arcticoder/spurious-force-balance/docs/kb/README.md

# KB index — `spurious-force-balance/docs/kb`

LLM-facing notes for future sessions. Read `session_handoff.md` first (state, what waits on the user, next tasks), then the topic you need. The sibling repo's notes (RP2040, lock-in, ordering, conventions)
are in github.com/arcticoder/lab `docs/kb/README.md`.

| Note | What it is for |
|---|---|
| `session_handoff.md` | state at the end of the last chat: done, in progress, waiting on the user, next three tasks, files to read |
| `balance_design_notes.md` | the torsion balance's numbers, design findings, and the checks that guard them; what is superseded |
| `instrument_electronics_notes.md` | the instrument board: decisions, simulation findings, open points before layout |
| `fab_ordering_notes.md` | JLC shipping, minimums, tactics (tagged by source), and this repo's fabrication decisions |
| `main_board_assessment.md` | why WP5 is slow (generic placement, all-at-once autorouting, two planes on 4 layers, KiCad features rebuilt in Python, rules added late) and the plan A-F; read before layout work |
| `main_board_layout_notes.md` | WP5 layout pipeline (`hardware/instrument/layout/mainboard.py`): placement, Freerouting, DRC, first-run result, KiCad 9 gotchas |
| `pcb_toolchain_notes.md` | KiCad 9, the venv, magpylib, kiutils pitfalls, the JLC parts snapshot, JLC capabilities |
| `project_workflow_notes.md` | the repos, the Opus-plans/Sonnet-actions routine, the user's standing preferences, tools |
| `easyeda_spark_notes.md` | SHELVED 2026-11-01 (EasyEDA/Spark route dropped, KiCad restored): the easyeda-mcp-pro Node fix, bridge status, Spark 2026 facts (unconfirmed), the .jxl picture convention, the main_board routing log, the EasyEDA install patches (`tools/patch_easyeda_autoroute_jobs.py`: job-style autorouting, DRC detail, copper rebuild) |
| `easyeda_validation.md` | SHELVED 2026-11-01: the offline validator `tools/validate_easyeda.py`, what it checks, how ERC/DRC and the `.epro2` export are obtained, the milestone routine |
| `part_a_planning_archive.md` | the instrument project's original planning text (constraints, gates, environment, architecture, toolchain) and the notes of finished Parts D, F, G, H |
| `printing_state.md` | K1 print hours rule, pre-sliced G-code, session routine, and the staged order notes |
