arcticoder/spurious-force-balance/docs/kb/project_workflow_notes.md

# KB: how this repo and its sibling are worked

Audience: future LLM sessions. Facts about the repos, the Opus/Sonnet routine and the user's standing preferences, as of 2026-10-24. The user's own words are never quoted in files; decisions are paraphrased.

## The repos

- `~/Code/python/pico`: the user's Pico/RP2040 sandbox (the Claude Code memory directory is keyed to it).
- `~/Code/python/lab` (github.com/arcticoder/lab, public): reusable bench circuits (SPICE netlists, breadboard guides, pass/fail smoke tests, MicroPython) plus the shared parts ledger (`docs/inventory.md`,
  `docs/orders.md`, `docs/parts_reference.md`) and its own knowledge base (`docs/kb/`). Every circuit there is ephemeral on a breadboard; parts return to inventory.
- `~/Code/python/spurious-force-balance` (github.com/arcticoder/spurious-force-balance, public, split from `lab` on 2026-10-23 with history): the torsion-balance experiment: plan, CAD, noise model, FR4 boards for JLC,
  the fab-assembled electronics design. Experiment-specific work lives in its own repo; a circuit built for an experiment stays in `lab` if it is reusable (`optical_shadow_readout`, `lockin_amplifier`) and the experiment links to it.
  Cross-repo references are GitHub URLs, not relative paths. `lab/lab.code-workspace` lists all three folders; the user keeps that one workspace.
- Licenses (both repos): MIT for code, CERN-OHL-P v2 for hardware designs and their documentation (`LICENSE`, `LICENSE-HARDWARE`).
- Git identity in both: `Arcticoder <10162808+arcticoder@users.noreply.github.com>`. Never commit: the user stages and commits both repos after each chat. Only flag, in `TODO-arcticoder.md`, milestones at which `hardware/easyeda/spurious-force-balance.eprj2` is worth committing (decided 2026-10-30). Commit messages end with the attribution line the session's system reminder gives.

## The Opus plans / Sonnet actions routine

The user alternates models with `/model`. In Opus mode nothing is actioned: Opus analyzes, then writes lettered **Parts** at the top of `docs/TODO-agent.md` (A, D, F, G so far) with concrete, checkable tasks. In Sonnet mode the user
says to process the tasks and Sonnet works them top to bottom, recording what was done in `docs/TODO-completed.md` and replacing a finished Part's task list with a short summary. `docs/TODO-arcticoder.md` is the user's own
list (hands, eyes, purchases only; one-line justifications; "En route" after the actionable sections), and anything the user must do goes at the top ("What I need from you").

## The user's standing preferences that shape this repo

- Paraphrase decisions; never quote the user or describe how they said it.
- **Design to stock sizes:** whole acrylic sheets, standard pads and rods; exact listing sizes in order lines; every cut needs a printed jig and a listed tool; the user has no saw, vise or scale in inventory.
- Carts must not incur single-item or under-threshold shipping fees; lines come from designs. AliExpress is the source for stock parts; no local-store suggestions; no mains parts on AliExpress.
- No hand soldering by the user; fab boards use only JLC's machine-placed SMT parts (nothing mailed in); one consolidated order where possible; USB power; under 50 V DC / 30 V AC.
- **Home printing is PLA only** (the fumes of ABS, PETG and nylon are ruled out). JLC PCB-as-structure, JLC3DP and JLCCNC are in scope when they beat buying and hand-cutting on cost, time or measurement risk.
- Instrument framing: never describe a circuit "without a multimeter"; name what it does. Real smoke tests (pass/fail safety and functional checks), not decorative simulations.
- Safety answers name the specific hazard or control gap; don't reassure or refuse.
- Jumper wires are never inventoried. Flux is not bought from AliExpress.

## Tools available to a session

`~/.venvs/lab-hw/bin/python` (CadQuery, magpylib, kiutils, SKiDL, numpy/scipy/matplotlib), KiCad 9.0.9 `kicad-cli`, ngspice, Freerouting (see `pcb_toolchain_notes.md`), `jlc` (live JLC stock/PCBA-type lookups; see `pcb_toolchain_notes.md`), `gh` (logged in as arcticoder), `git-filter-repo`,
`WebSearch`/`WebFetch` for vendor help pages, and read-only Pico probes through `mpremote` when the user leaves a rig plugged in (see `lab` `docs/kb/live_bench_measurement_notes.md`).
- **TODO-agent.md holds open items only** (the format of `aqei-bridge/docs/TODO.md`): a header pointing to `TODO-completed.md` (dated entries), `TODO-BLOCKED.md` (waiting on the user's build or A5) and `TODO-backlog.md`; finished work leaves the file the same session, and long notes go to `docs/kb/`. The old Part A planning text is in `kb/part_a_planning_archive.md`.
- **Mode:** on 2026-10-27 the user said there is no analysis-only mode for the agent: whichever model is running actions what needs actioning. The Opus/Sonnet split above describes how the user alternates, not a rule that blocks work.
- **JLC quote pages are unreadable from a session** and the `jlc` tool has no quotes: never present an estimated JLC price as fact, and do not send the user clicking through the quote UI for numbers that can be computed; ask for specific numbers only. The user's captures of the pages are in `lab/docs/jlc/`.
- `docs/history.md` is the user's chat transcript: never edit it unprompted and never use it as an analysis source.

## TODO-arcticoder.md hygiene (user's rule, 2026-11-01)
Only separately numbered tasks for the user's hands, eyes or decisions: no notes to self, no status reports, no placeholder "nothing needed" item. Explanations, EasyEDA recipes, the bridge-reconnect reminder (Advanced > MCP Bridge > Connect after sleep), the Spark registration timing (closes 2026-11-30; register only after the design exists) and the next `.eprj2` milestone belong in `kb/` (`session_handoff.md`, `easyeda_spark_notes.md`). A task I give in chat must also be in this file. Each action is its own numbered item.

## JLCONE desktop app access (2026-11-04)

The user launches the JLCONE app with `--remote-debugging-port=9222` when they want a quote or coupon read; the recipe, the gotchas and the permissions are in `lab/docs/kb/jlc_account_and_quotes.md`. Rules: read-only text reads, a few paced mouse clicks, uploads of this repo's own Gerber zips for quotes, never JLC's API, never the cookies, never "Submit"/"Save to cart"/payment (the user approves and pays), one order per task and at most one per day. Leave the page configured and tell the user what to approve.

## Standing rules added 2026-11-10

- **No tracking numbers** in chat or in any file (the user redacts them in `history.md` themselves; do not touch those). Say "tracking number in the JLC app".
- **Never state that I read a page unless the transcript shows the call; when asked, check the transcript and answer from it.** Order-page reads drive the JLCONE account tab through the debug port; the user does not need the tab left on the order list (they only need to know which page it was last on if they look at it), so just say what I read.

## Standing rules added 2026-11-11/12 (chat 13)
- **TODO-agent.md must be at 0 lines at the end of every chat** (`wc -l`): startable items are done in the same chat; items that truly wait (printer power, the user's decision or photo, the JLC app, a running computation) go to `TODO-BLOCKED.md` with the exact condition; user decisions also become numbered tasks in `TODO-arcticoder.md` (a decision that exists only in chat is a miss: the calibration-physics confirmation was one). Staged orders and standing duties live in `TODO-backlog.md`.
- **Never append to `docs/history.md`**; the user pastes the full chat summary there.
- **Long computations:** run them in the background (`run_in_background`) and write the plan to the TODO files before waiting; never poll or sleep. Keep a copy of the last good board/state before a new run. Do not mix the user's request for one thing with an extra experiment in the same background chain without a log file per run.
- **Photos:** the user drops a JPG in the repo root; convert to lossless `.jxl` in `docs/img/` with a descriptive name (via `tools/to_jxl.py` or Pillow with `pillow-jxl-plugin`, applying EXIF orientation), delete the original and its `:Zone.Identifier`, and parse what is in it against the CAD or inventory before relying on it.
- **Estimates vs facts:** label slicer-based print times, masses and price guesses as estimates in user-facing text; never state JLC prices; say when a check was not run.
- **Layout work:** read `kb/main_board_assessment.md` first (why it was slow: generic placement, all-at-once autorouting, planes, rebuilding KiCad in Python); change one thing per routing run and note the result in `kb/main_board_layout_notes.md`.
