arcticoder/spurious-force-balance/docs/kb/main_board_layout_notes.md

# KB: main-board layout pipeline (WP5), started 2026-11-08

Audience: future LLM sessions. The user's direction (2026-11-08): fab-assembled electronics, no hand-built stage; the layout does not wait on A5 (the breadboards `lockin_amplifier` and `optical_shadow_readout` in `lab` are no longer prerequisites; the board's digital lock-in and optical front end replace them).

**Milestone commits:** `4c877d7` holds the first placed-and-routed board, `88e0b3e` the geometry/DFM gate and the first DRC pass; both carry a generic refactoring message, so use these hashes to find them.

## Pipeline (all in `hardware/instrument/layout/mainboard.py`, run with `~/.venvs/lab-hw/bin/python`)

1. `mainboard.py place [W H]` builds `layout/out/main_board.kicad_pcb` (kiutils) from `schematic/out/main_board.net` (164 parts, 111 nets) and `lib/jlc.pretty`: four copper layers, nets on pads, connectors fixed at the edges (USB-C bottom, six 4-pin JST-SH top, four 2-pin JST-SH left, five 2.54 mm headers right), the rest placed by a damped force-directed pass (signal nets pull, power nets weakly, each capacitor toward the IC sharing its power net) then a repulsion-only legalisation with jitter. Deterministic. 110 x 90 mm gives 0 overlaps (parts are about 21% of the area).
2. `mainboard.py route` writes a Specctra DSN (own writer, no pcbnew), runs the bundled Freerouting 2.5.0 (`~/tools/freerouting/freerouting-2.5.0-linux-x64/bin/freerouting -de .dsn -do .ses -mp 8`) and imports the SES back as segments and vias (`import_ses`). A full run takes about 9 minutes (fanout 40 s, eight passes); the SES is written only at the end, so the `-do` file does not exist while it runs (the wrapper's 10-minute limit killed one run; run Freerouting directly in the background and wait for its exit).
3. DRC: `kicad-cli pcb drc --format json --severity-all --output out/drc.json out/main_board.kicad_pcb`.

## Result of the first run (110 x 90 mm, 0.2 mm tracks, 0.15 mm clearance, 0.6/0.3 vias)

415 nets to route, 9 left unrouted, DRC: 3 clearance, 6 tracks under 0.15 mm (0.10-0.12 mm pieces), 8 dangling vias, 2 annular-width, 2 padstack, 2 malformed courtyards (library footprints), 199 silk overlaps and 199 silk-over-copper (silk comes from the easyeda2kicad footprints; clean up before the fab outputs), 164 `lib_footprint_issues` (harmless, footprints are not from a library table). Not a fabricable board yet. Not yet done: ground planes on the inner layers (all four layers are used for routing), wider power tracks, USB differential pair, analog/digital partition checks, mounting holes, connector orientation (rotations were guessed: 0 on top, 90 left/right), silk and refdes, the 4-layer stackup/finish settings, and the visual review (WP6).

## Gotchas

- KiCad 9.0.9's Python `pcbnew` segfaults headless on `LoadBoard` and `BOARD.SetCopperLayerCount` raises a type error, so `ExportSpecctraDSN`/`ImportSpecctraSES` are unusable; kiutils plus the own DSN/SES code replaces them.
- `Footprint.description` from the easyeda2kicad libraries can contain newlines and colons; `kicad-cli` then fails with "Failed to load board". `mainboard.py` blanks it. When a board will not load, bisect by footprint (write one footprint at a time and run `kicad-cli pcb drc`).
- `kicad-cli pcb drc` takes its clearance from the `.kicad_pro` `net_settings.classes[Default]` next to the board, not from `board.design_settings.rules`; with the default 0.2 mm it reported 502 false clearance errors against a 0.15 mm route.
- kiutils writes pad angles as given: footprint rotation must be added to each pad's angle for connectors rotated by 90.
- DSN: unit um, y up (KiCad's y is down), one `component` block per image name, all parts on the front side.

## Design rules from the user (2026-11-09) and the checks that enforce them

- **Layer count by need:** 2 layers for a simple design; 4-6 with dedicated ground and power planes when noise reduction needs them. This board is 4 layers because of the RP2040 + 16-bit ADC + switching boost + USB mix; target stackup F.Cu signal / In1 GND plane / In2 power plane / B.Cu signal. The first Freerouting pass used all four layers for routing (no planes), which is why it is not the final state: pour GND on In1 and power on In2 (keep a plane unbroken under the ADC and its reference), then re-route the signals on F/B only. The mechanical boards and `elec_board` are 2-layer by design (no noise-critical analog on them).
- **No acute angles / 45-degree only:** `mainboard.py geometry [-v]` lists segments not on the 45-degree grid and same-net joints under 90 degrees. First pass (3340 segments): 0 off-grid (Freerouting's default snap angle is 45 degrees; the CLI has no option for it), 7 joints with a 45-degree interior angle (hairpins). Clean these by re-routing or by deleting the stub; also keep an eye on copper pours: thermal-relief spokes and neck-downs make acid traps too.
- **DFM gate:** `mainboard.py dfm` runs DRC and the shape check and exits 1 while a blocking item remains (clearance, track width, annular ring, dangling vias, unconnected nets, padstack, acute joints). Current blocking list: track_width 6, clearance 3, annular_width 2, padstack 2, via_dangling 8, unconnected 9, acute 7. Advisory (silk from the easyeda2kicad footprints, courtyards, library table): fix before the fab outputs but not a fab stop. Run it last, then confirm in JLC's own DFM/placement preview at order time (the preview is the user's step; read it through the app only if asked).

## Direction, rules and work order (moved from TODO-agent.md 2026-11-10)

No EasyEDA or Spark work is open: the native redesign, its MCP tooling, `tools/validate_easyeda.py` and the notes are shelved (`kb/easyeda_spark_notes.md` header). The KiCad/SKiDL netlists, the four mechanical boards, the sensor-head panel and its Gerbers are the order files. Open KiCad work: the WP5 main-board layout (details in `TODO-BLOCKED.md`, no longer gated on A5); WP4e sheet rendering is in `TODO-backlog.md`.
**Direction from the user (2026-11-08): no more hand-built electronics.** The electronics are fab-assembled boards from JLC: the main board and the sensor-head panel replace the breadboards (`lockin_amplifier`, `optical_shadow_readout`), so the A5 prototype check runs on the assembled boards and is not gated on the breadboards. The earlier plan to prove the design on breadboards before laying out the main board is dropped; the layout is not waiting on A5 any more.
**Board-design rules (user, 2026-11-09), apply to every board:** (a) layer count follows need: 2 layers for a simple design, 4-6 with dedicated ground and power planes where noise reduction needs them (the main board is 4 layers with inner planes still to draw; the arm, electrodes, clamps and `elec_board` are simple 2-layer designs); (b) no acute angles in copper (acid traps, signal integrity): 45-degree bends or arcs only; (c) a DFM check is the last step before any fab output. Implemented as `mainboard.py geometry` and `mainboard.py dfm` (exit 1 while anything blocking remains); the 2-layer boards get the same check at their next regeneration. Open: acute-joint cleanup (7 hairpin joints in the first pass), rounding the 45-degree corners is optional.
Main-board layout state: `kb/main_board_layout_notes.md` (first routed pass: 9 of 415 nets unrouted, 3 clearance errors; next: close the 9, add inner-layer ground planes, silk cleanup, connector rotations, mounting holes, DRC clean, WP6 review).
Open now, in order: (0) done 2026-11-08: `docs/plan.md` reconciled (remaining mentions of A5-before-layout, if any, are history); (1) WP5, the main-board layout in KiCad (RP2040 per its reference layout, ADC per its data sheet, analog/digital partition, decoupling, USB pair, DRC clean against JLC's rules; detail in `TODO-BLOCKED.md`, section "Main board"); (2) WP6 render review and the WP7 placement prechecks; (3) WP7 fab outputs (Gerbers, BOM, CPL, order-settings README) and the cost picture for the user's budget decision (JLC quotes are unreadable to me: ask for numbers only). The order itself (cost, coupons, parcel mass) is the user's decision once the files are checked. Waiting on the board only: the rest of WP8 and the bring-up.

## In1 ground plane and the 120 x 90 mm run (2026-11-10)
- `mainboard.py` now pours a GND zone on In1.Cu (`add_planes`, called from `import_ses`; kicad-cli DRC refills it) and the DSN keeps every net except GND off In1.Cu with `(use_layer F.Cu In2.Cu B.Cu)` in the signal class; GND may use all layers. Freerouting honours it: after the run In1.Cu holds 29 GND segments and nothing else.
- A DSN `(plane GND ...)` with In1 as a power layer did NOT work: Freerouting wrote no GND vias for the SMD pads, 148 GND pads stayed unconnected. Do not retry it.
- Board 100 x 80 mm with a plane left 156 connections unrouted; 120 x 90 mm leaves 3 unconnected, 3 clearance, 8 track-width, 17 acute joints (Y-branches), 2 dangling vias, 2 dangling tracks, 1 shorting item. The first routed pass (100 x 80, no plane, signals on In1) is in the scratchpad backup only; commit `4c877d7`/`88e0b3e` hold it in git. **120 x 90 is a price-tier question for the user** (the cheap 4-layer tier needs under 50 x 50 mm; this board is above it either way).
- A full route takes 15-25 minutes on this machine now: use `mainboard.py route 30` (minutes argument); an 8-minute limit writes no SES.
- Still no In2 power plane: In2 carries signals. Next step is the same trick for the 3V3 rails (zone on In2 plus `use_layer` excluding In2 for non-power nets) if the routing leaves room.

## 2026-11-11 evening: new tools, decisions and the In2 attempt
- New `mainboard.py` commands: `sync` (library description, models, courtyards, unplated pegs), `holes` (four M3 holes at the corners, moved inward until clear of copper), `silk` (reference and value texts to the Fab layer, no outlines on C/R/L/F 0603-1206 passives, title text; silk warnings fell from about 600 to 10), `rules` (writes `out/main_board.kicad_dru`: pad-hole gap 0.45 mm), `fixacute` (rewrites 45-degree Y-branch joints whose shorter leg is 0.72 mm or more: 4 of 17 on the 2026-11-10 route), plus `import_ses` now runs sync, holes, silk and both planes. `dfm` gained netlist parity (replaces the missing .kicad_sch: refs, footprints and every pad-net against the netlist; MH holes exempt), a mounting-hole count (at least two 2.5 mm+ NPTH) and a board-size advisory.
- In2 plane: `PLANE2_NET = "3V3_D"`; the DSN class `signals` is limited to F.Cu/B.Cu, `plane2` (3V3_D) may use In2, GND any layer. A 35-minute route with this wrote no SES; a 58-minute one was started 2026-11-11 about 21:00 (`out/route_in2_b.log`). Fallback is the routed state of 2026-11-10 (In1 GND only); `inner_plane_missing` in `dfm` then needs relaxing to In1 with the reason written down.
- Track widths under 0.15 mm in the DRC (0.10 and 0.12 mm, 0.01-0.39 mm long) are Freerouting neck-downs at fine-pitch pads; JLC allows 0.09 mm, so the DRC floor is 0.10 mm and they pass.
- 120 lib_footprint_mismatch warnings now (advisory) are intended: the silk policy deliberately differs from the library.
- Still a real defect: the USB-C VBUS via touches the GND pad A1B12 (short, hole clearance, solder-mask bridge). Courtyards of L4 overlap C49, R18, C3.
- `check_panel.py` reads the panel outline with kiutils because `pcbnew.LoadBoard` segfaults; `analog_sims.dut` ignores the last ngspice sample (a glitch at t = tstop).
- Result of the 58-minute In2 route (2026-11-11, ended 21:44): Freerouting finished in about 45 minutes and wrote `out/main_board.ses` (1427 wires, 372 vias; In2 carries only 3V3_D, as intended), but the import crashed: `sync_library_fields` tries to load a library file for the generated `MountingHole_M3` footprint, which has none (skip footprints not in `jlc.pretty`). So the board file is still the 2026-11-10 fallback and the unrouted count of this run is unknown. Not patched further (method change, `kb/main_board_assessment.md`); the SES stays in `out/` only as a data point (In2 as a solid plane is routable at 120 x 90 in about 45 minutes).

## 2026-11-12: block-placement runs, what worked, final state (read this first)
- Sequence of runs on the block floorplan (`BLOCK_REGIONS`, 120 x 90): (1) signals on In2 + 3V3_D pour: 0 shorts, 47 unconnected; (2) USB-C custom pads fixed in the DSN (their `size` is a 0.005 mm anchor, the copper is the polygon; the router had routed through the real pads, giving 5 shorts and 8 clearance errors); (3) pour dropped, signals F/B only: 25 unconnected; (4) cause of 40 unconnected 3V3_D pads found in the SES (16 wires for 47 pins): the rails class at 0.25 mm cannot enter the RP2040's 0.4 mm-pitch pads, class width back to 0.2 mm: 6 unconnected, all on U3's pads; (5) courtyard-based part sizes and a 0.25 mm keep-out around NPTH holes in the DSN removed the courtyard and hole-clearance errors; (6) `FANOUT_EXTRA` keep-out around U3 (3 mm), U9 (2.4), U8 (1.6) gave a fully routed board on the first run with it (route 40 min limit, finished earlier).
- Final: 415/415 routed, DRC: no shorts, clearance, dangling vias, courtyards, hole clearance; `dfm`: blocking none. Advisory: 4 silk over copper, 120 lib_footprint_mismatch (silk policy, intended), no fiducials, board size vs price tier.
- The In2 pour in all three forms failed (fragments, no layer left, or 45 minutes) and is dropped; In1 GND is the only plane. `stitch_pour` (vias to a pour) exists but is not called.
- `route2` (continue from existing tracks) did not change a stuck board; placement keep-outs did. Freerouting's log is not captured; count unrouted from DRC.
- Added: `fab` command (zone fill with system pcbnew, Gerbers, drill, BOM from netlist LCSC fields, CPL); kicad-cli plots stored fills only, so fill first or the plane is missing from the Gerbers (it was: In1 12 kB before, 256 kB after).
- Not done and not needed for the gate: connector rotation check (user, JLC preview), board-size decision.
