arcticoder/spurious-force-balance/docs/kb/easyeda_spark_notes.md

> SHELVED 2026-11-01: the EasyEDA/Spark route was dropped and KiCad is the design source again. Read this only if EasyEDA work is ever resumed (state of the main board: 117.3 x 96.8 mm, 0 clearance errors, 62 open connections around U4, project saved in `hardware/easyeda/`).

# EasyEDA MCP bridge and the Spark competition (2026-10-29)

## easyeda-mcp-pro
- Package `easyeda-mcp-pro` 1.6.0 (PolyForm Noncommercial) needs Node 24.x (pinned 24.22.1) and checks at startup. `bunx` runs it with whatever `node` is first on PATH (shebang), so bun is fine but PATH decides: the failure was nvm's default Node 22.15.0.
- Fix applied: `nvm install 24.22.1`; the VS Code Insiders `mcp.json` entry sets `env.PATH` with `~/.nvm/versions/node/v24.22.1/bin` first and keeps `TOOL_PROFILE=pro`. `extension --open` then prints the `.eext` path (inside the bun/npm cache; also `extension --copy <dir>`).
- The user reported the bridge connected (2026-10-29); this session still had no easyeda tools (the server loads at session start). Originally unverified: the bridge connection. It needs the user to import the `.eext` in EasyEDA Pro, fully restart it, and click MCP Bridge > Connect; EasyEDA Pro (`easyeda-pro` in /usr/local/bin, a Windows install under WSL) must reach the server's WebSocket across the WSL boundary. The MCP tools only appear in a session started after VS Code reloads the server.
- Cheaper fallback if the bridge fights back: EasyEDA Pro imports KiCad files itself (File > Import).

## Spark 2026 (source: FabFlow blog, a third party with a referral link; the official OSHWLab pages are JS-rendered and returned only navigation text)
- Registration 2026-01-01 to 2026-11-30; judging December; $85,000 pool; categories include Best Documentation and Community Choice.
- Needs: design in EasyEDA (Pro), public on OSHWLab with schematics, layout, BOM, firmware, build instructions.
- Material sponsorship about 80% of manufacturing and shipping (PCB, PCBA, 3DP, CNC), duties and taxes the participant's; acceptance criteria not stated. $100 JLCPCB coupon per registrant; $50 each for referrer and referee when the referee submits.
- Every figure above is unconfirmed until read on the official page while logged in.

## Pictures
- Repo pictures are lossless JPEG XL (`.jxl`) since 2026-10-29; generators write a temporary PNG and call `tools/to_jxl.py` (needs `pillow-jxl-plugin` in `~/.venvs/lab-hw`). `cjxl` is not installed. GitHub does not render `.jxl` inline, so a README that must show a picture needs a PNG/WebP copy. `lab` has no committed PNGs (its `schematic.png` files are generated and gitignored).

## LFS
- `*.jxl` is LFS-tracked in both repos (`.gitattributes`); `lab` also keeps `*.jpg`. Neither repo tracked PNG. Existing .jxl were re-added with `git add --renormalize`.

## MCP client wiring
- The VS Code `mcp.json` configures VS Code's MCP client, not Claude Code. Claude Code reads `~/.claude.json` `mcpServers` (the `claude` CLI is not on PATH in the WSL shell, so the entry was written directly; backup in the scratchpad). A stdio `initialize` against `bunx easyeda-mcp-pro` under Node 24 answers correctly (v1.6.0). EasyEDA Pro itself runs natively in WSL (`/opt/apps/easyeda-pro`), so the bridge is localhost. Two clients running the server at once may fight over the bridge port.
- Spark rule from the user (2026-10-29): the design must be made in EasyEDA, not imported from KiCad/SKiDL; apply only after the redesign exists.

## Bridge state (2026-10-29, later)
- Connected through the VS Code `mcp.json` (key `servers`, not `mcpServers`); in a Claude Code session the tools appear as `mcp__easyeda-mcp-pro__*` after the server is up. `easyeda_health_check` reports bridge_connected with EasyEDA Pro 1.6.0 extension.
- With nothing open, `schematic_components` fails and `canvas_capture` returns no image; every tool wants a `projectId` and there is no tool to create or list projects (only API inventory names `dmt_Project`), so the user must open a project first.
- Tool limits that shape the redesign: schematic writes (place_component, connect_pin_to_net, batch_write, net flags) exist; the PCB side is read-only plus DRC and autoroute; footprints reach the PCB only through `schematic_sync_to_pcb`, whose confirmation dialog the user must click. Custom board outlines, the 208 mm arm shape, placement and copper for the mechanical boards probably need EasyEDA's own UI or the extension API; check `api_inventory` filtered on PCB_ before promising it.

## Project file and profiles
- `hardware/easyeda/spurious-force-balance.eprj2` is a SQLite database (tables: boards, components, ...; 389 KB empty), rewritten on every save, so diffs are opaque: tracked through Git LFS (`*.eprj2` in `.gitattributes`), committed at milestones only, not every save. The OSHWLab copy is uploaded from EasyEDA itself, not from git.
- `canvas_capture` works with the project open (empty PCB, mil grid). The PCB API (`api_inventory` filter `PCB_`) has create/modify for components, pads, lines, polylines, pours, vias, regions; the `pro` profile exposes none of them. `full` adds "controlled documented API method calls" and CircuitIR floorplanning, so the profile was switched to `full` in the VS Code mcp.json (needs a restart). `dev` adds probes; avoid unless debugging.

- The server a Claude Code session talks to is spawned from `~/.claude.json` (not the VS Code `mcp.json`); changing the profile in the wrong file leaves `easyeda_health_check` reporting the old one. Check `profile` there before relying on `full` tools. Only one server process should run, or the bridge may bind to the wrong one.

## Native EasyEDA build: recipe that works (2026-10-30, `full` profile)
- Project UUID `4d31f2a7bcc8695ef8b75bd3a29ba297479082a28cd7122588689b19e4bb50ca`; Board1 holds Schematic1 and PCB1 (one PCB per Board: the other mechanical boards need their own Board/PCB, create through `DMT_Board`/`DMT_Pcb` calls or the UI). `easyeda_api_call` needs `confirmWrite:true` even for getters. Do not call `PCB_Layer.getAllLayers` again: its output is huge.
- Units are mil; y is up (KiCad y is down: use y_e = -y_k, x_e = x_k, 1 mm = 39.37008 mil).
- Board outline: `PCB_PrimitivePolyline.create("", 11, {"$polygon":[x0,y0,"L",x1,y1,...]}, 10, false)`, closed by repeating the first point.
- NPTH hole: `PCB_PrimitivePad.create(12, "", x, y, 0, ["ELLIPSE",d,d], "", ["ROUND",d,d], 0,0,0, false)` (metallization false).
- SMD pad: shape name is `RECT` (`["RECT",w,h,cornerRadius]`), not RECTANGLE; hole omitted; layer 1 top, 2 bottom; pass the net name as the 7th argument.
- Track: `easyeda_pcb_add_track` (layer 2 = bottom, width in mil).
- `easyeda_pcb_place_component` is disabled by the server; footprints come from the schematic through `schematic_sync_to_pcb` (the user clicks the dialog).
- `easyeda_drc_run` takes the project UUID and returned 0 violations for the arm.
- Arm status: outline, 7 NPTH holes, B.Cu pads 1 (5.6 x 12 mm) and 2 (20 x 8 mm), pad 3 (flag, top and bottom copper), the 0.6 mm trace; the net is called `ELEC_LEAD` (it was unnamed in KiCad). Silkscreen text not yet added.

## Mechanical boards done (2026-10-30)
- Boards in the project: Board1/PCB `arm`, Board2/PCB `clamp_plate` (uuid 3ddf518a3b25253b), Board3/PCB `clamp_ground` (a1c4bc42816028ee), Board4/PCB `elec_board` (05dc52ccb60a9ca9); arm is 7bc3367e1c2d2364. `DMT_Board.createBoard` (no args) makes a Board plus empty schematic and PCB; rename with `DMT_Pcb.modifyPcbName(uuid, name)`; switch the focused document with `DMT_EditorControl.openDocument(pcbUuid)` before PCB calls (DRC and the PCB API act on the focused document). Board names are still Board1..4.
- All four reproduce the KiCad geometry (outline, NPTH holes, copper pads, tracks, one via on elec_board) with 0 DRC violations each (arm and elec_board and clamp_ground checked after drawing; clamp_plate has no copper). `PCB_PrimitiveVia.create(net, x, y, holeDia, dia)`; plated through pad: layer 12, pad number, net, hole, metallization true.
- Not yet: silkscreen labels, the sensor-head panel, the instrument schematic and board (sync needs the user's click on the dialog), the Spark texts.

## Sensor heads, schematic side (2026-10-30)
- Board5 = PCB `sensor_head_1` (6b230bf28446d8f9, schematic page bbf87dc32958233f), Board6 = PCB `sensor_head_2` (868eebde0c888e1b, page 6041b681d252cfcb). Library parts found by LCSC number through `schematic_search_device` (library 0819f05c4eef4c71ace90d822a990e87): TMP117 C699536 uuid 4af454a0..., MMC5983MA C404329 dd001152..., SM04B-SRSS-TB C160404 eedd7219..., 100 nF C14663 a299e4f2..., 1 uF C15849 af2e25dc..., 10 uF C15850 e10bc30d....
- Wired with `connect_pins_by_net` (net-label stubs) to the same nets as `schematic/heads.py` (3V3_D, GND, I2C_SDA, I2C_SCL, MAG_CAP), unused pins marked no-connect with `setPinNoConnect`; head 1 validates fully (0 floating, ERC 0). Head 2's nets are right and ERC passes, but `validate_netlist` reports valid:false with "7 component(s) have no net connections" (unexplained; recheck after the PCB sync). Pin numbers equal the KiCad/SKiDL numbers for these parts.
- Head 2's 100 nF capacitor landed in the title-block area (placed at y=100): move it before publishing the schematic.
- `schematic_sync_to_pcb` only opens EasyEDA's confirmation dialog; the user must click it (steps in `TODO-arcticoder.md`).

- EasyEDA Pro 3.2.x menu: the sync is Design > Import Changes from Schematic (Alt+I) inside the PCB editor (no "Convert/Update PCB" item). `PCB_Document.importChanges()` via `api_call` with the PCB focused returns true but only raises that dialog; `pcb_components` stayed empty until the user confirms. Canvas captures do not show dialogs.

## Sensor head 1 layout recipe (2026-10-30, later session)
- Pad coordinates and nets: `PCB_PrimitiveComponent.getAllPinsByPrimitiveId(componentPrimitiveId)` through `easyeda_api_call` (confirmWrite true); the output is very large (about 3 KB per pad), so query one part at a time and read only X, Y, Net. Pad coordinates are absolute (mil, y up).
- The sync leaves parts in one row with no overlap, so placement can be kept; head 1's row spans x 0..860, y -456..-197 mil. Outline for a 26 x 17 mm board around it: `PCB_PrimitivePolyline.create("", 11, {"$polygon":[-80,8.3,"L",943.6,8.3,943.6,-661,-80,-661,-80,8.3]}, 10, false)`.
- `easyeda_pcb_autoroute` works with the PCB focused: `ignoreNets:["GND"]`, `cornerStyle:"45"`, `optimization:"completion"`, `existingPrimitiveMode:"keep"`, `boardData:{hasOutline:true,widthMm:26,heightMm:17,layerCount:2}`; it routed 4/4 nets in 1 s (detours, 8.9 to 10 mil tracks, two vias, one bottom-layer segment). Its DRC counts are coarse; `PCB_Drc.check(true,false,true)` via `api_call` gives per-net groups (the entries print as `[MaxDepth]`, so only the count and net name are readable).
- GND pour: `PCB_PrimitivePour.create("GND", layer, {"$polygon":[...]}, "solid", false, "GND_top", 1, 10, false)`; the copper is only filled after `easyeda_pcb_rebuild_copper`. A call with `net:"GND"` rebuilt the first pour (layer 1; DRC errors 12 to 6) but the bottom pour failed read-back, and the tool then refuses every later rebuild ("previous rebuild ended without complete verification"), apparently until the MCP server is restarted. Do not rebuild both pours in one call: pass one `pourIds` entry per call, and check `PCB_PrimitivePoured.getAll` for a fill.
- Head 1 state: outline, autorouted signals, top GND pour filled; bottom pour created but unfilled; 6 GND connection errors remain (pads enclosed by traces). Fix: restart the server, rebuild the bottom pour, add GND stitching vias beside the enclosed pads (CN1 pad 2, U1 pads 2/4/7, C1 pad 2, ...), rerun DRC. Head 2 not started.

- Bridge after suspend (user report 2026-10-30): the bridge drops when the computer sleeps; recovery is `pkill -f claude`, restart the session, then EasyEDA Pro's Advanced > MCP Bridge > Connect. `easyeda_health_check` returning `bridge_connected:false` / `degraded` means the user must click Connect again; the rebuild-copper guard does NOT reset with a new server process: it is persisted in `~/.easyeda-mcp-pro/easyeda-mcp-pro.sqlite` (a failed rebuild read-back blocks `easyeda_pcb_rebuild_copper` until reconciled; do not edit that file to bypass it, ask the user to rebuild copper from EasyEDA's menu instead). Deleting and recreating a pour does not fill it.
- Head 1 after the 2026-10-30 reconnect: bottom pour recreated (id ff793f60...), five 24/12 mil GND vias placed in big GND pads, DRC still 6 GND connection errors (bottom pour unfilled).

- Head 1 finished (2026-10-30, evening): the user rebuilt the bottom pour from EasyEDA's menu (the pour was renamed GND_BOT2 and held one fill); the tool's guard stayed locked anyway. The 6 remaining errors were GND pads enclosed by autorouted 3V3/SDA traces; a second `easyeda_pcb_autoroute` with `routingNets:["GND"]`, `existingPrimitiveMode:"keep"` connected them with GND tracks/vias and DRC read 0 (`PCB_Drc.check` returns `[]` when clean). Order that works: signals (ignore GND), pours (user rebuilds copper), then GND autoroute.
- EasyEDA writes `.epro2` auto-backups to `hardware/easyeda/spurious-force-balance_backup/` on save (timestamped, about 360 KB each); the folder is gitignored (`hardware/easyeda/*_backup/`).

- Head 2 (2026-10-31): same recipe; outline, signals autorouted (3/3 nets), GND_TOP/GND_BOT pours created, waiting for the user's Copper Manager rebuild, then the GND autoroute and DRC. Copper Manager lists nothing until pours exist (a user's empty list on a board without pours is expected). C5 in the schematic title block still to move.

- Head 2 finished (2026-10-31): after the user rebuilt both pours in Copper Manager, a GND-only autoroute gave DRC 0. Its schematic is fine: `schematic_components` and `validate_netlist` are project-wide counts, so head 2's "7 components have no net connections" warning is head 1's parts; C5 at (400,100) is nowhere near the bottom-right title block (A4 1170 x 825, position 3). Nothing to fix.
- Panels: `DMT_Panel` only has createPanel/copy/delete/getAllPanelsInfo/getPanelInfo/modifyPanelName; `panel1` exists (uuid 7ff8c5b618e84216), with no content API, so the panel would be built by the user in the UI. 2026-10-31: `panel1` opens as an empty frame with corner marks; the user could not paste a PCB into it and no verified procedure exists, so the panel is parked (do not give the user panel steps from memory; ask what the panel tab's menus offer if it is revisited). The JLC order uses the KiCad panel Gerbers.

- Silkscreen (2026-10-31): `easyeda_pcb_add_text` fails ("cannot create text primitive"); use `PCB_PrimitiveString.create(layer, x, y, text, "NotoSansMonoCJKsc-Regular", fontSizeMil, lineWidthMil, 1, 0, false, 0, mirror, false)` through `api_call` (layer 3 top silk, 4 bottom silk with mirror true). The anchor is the text's top-left; width is about 0.68 x font size per character (so centre a label at x - n*0.34*size, y + size/2). Done from the KiCad texts: arm (2 labels), clamp_plate (CLAMP), clamp_ground (GND, bottom), elec_board (SIG, GUARD, ELECTRODE note, bottom). Board uuids and KiCad (x, -y) mapping unchanged; the arm outline spans x +-100 mm, y +20..+80 mm in EasyEDA coordinates.

- Bottom-silk labels under top copper do not show in the combined view (top copper and top solder-mask/paste draw over them): elec_board's ELECTRODE note looked missing to the user but exists (verified with `PCB_PrimitiveString.getAll` and by hiding layers 1, 5 and 7 with `PCB_Layer.setLayerInvisible`, then restoring with `setLayerVisible`). Check text with `getAll` rather than a screenshot, or hide those layers first. Layer ids: 1 top, 2 bottom, 3 top silk, 4 bottom silk, 5 top mask, 6 bottom mask, 7 top paste, 8 bottom paste.

## State at 2026-10-30 handoff
- Both sensor-head PCBs now hold their imported footprints (sensor_head_1: C1-C4, CN1, U1, U2; sensor_head_2: C5, CN2, U3), unplaced and without an outline; footprints: C0603, C0805 (10 uF), WSON-6 2x2 mm (TMP117), LGA-16 3x3 mm 0.5 mm pitch (MMC5983MA), SM04B-SRSS-TB. Designators run project-wide (C5, CN2, U3 on head 2).
- The user imports with Design > Import Changes from Schematic (Alt+I) in the PCB tab and presses Apply; no tool does it for them.
- Next: outline, placement, routing, pour, DRC for the heads; the panel in Panel1; silkscreen; the main board.

## Main board in EasyEDA: plan and device table (2026-10-31)
- Source of truth for the parts and nets: `hardware/instrument/schematic/main_board.py` (164 BOM parts, 46 LCSC numbers, 542 pins, 111 multi-pin nets, 16 unconnected pins). Export that circuit to JSON with a small script (`builtins.default_circuit.parts`, pin.num, net name when the net has more than one part pin; skip LCSC "C0" power flags) rather than retyping it.
- `hardware/easyeda/main_board_devices.json`: LCSC number -> library device uuid (library 0819f05c...), found with `easyeda_schematic_search_device`. Short LCSC keys match many devices as substrings (C1588 also returns LTC1588...): pick the device whose name is the expected MPN. RP2040 is "RP2040_C2040" (key "RP2040"); the ADC crystal C21900468 is not in the library, so it uses C9002's device (as `main_board.py` does). **Unverified: C17928 (1 ohm 1206 shunt) resolved to "1206W4F100KT5E", whose name does not look like 1 ohm; check its value before use.**
- Board7 was created with `DMT_Board.createBoard` (name Board7, empty schematic and PCB); rename the PCB `main_board` with `DMT_Pcb.modifyPcbName`.
- Pipeline: `schematic_batch_write` (up to 200 ops, atomic) to create the components, then `schematic_connect_pins_by_net` per net (pin numbers equal the KiCad pin numbers for the parts tried), `schematic_set_pin_no_connect` for the 16 unconnected pins; then the user's Alt+I import, then placement and routing.
- Main board schematic progress (2026-10-31): Board7 (PCB renamed `main_board`, PCB uuid 85757acc0463db9b, schematic page a173bbce992e5a91) holds all 164 parts placed with `schematic_batch_write` (60 ops per call worked, atomic; operationId = the SKiDL ref, and the resulting designators equal those refs, e.g. USBC1, D1, U9; the RP2040 is U3). Layout is a spaced grid (passives at x 0..1320, y -100..-1000; ICs and connectors at x 900..2900, y 300..2400), so the sheet is not presentable yet. Pin numbers of the library symbols match the SKiDL pin numbers for the parts checked (RP2040, USB-C `A4B9`, USBLC6, polyfuse).
- `schematic_connect_pins_by_net` on this large sheet answers "timed out after 15000ms" but the wiring is applied; do not retry before listing `easyeda_schematic_nets` (a retry draws duplicate stubs). Verify the finished wiring by comparing each net's `node_count` with the SKiDL netlist.

### Main board schematic: wired and validated (2026-10-31)
- Result: `easyeda_schematic_validate_netlist` on Board7 reports 111 nets, no floating pins, native ERC 0 errors (57 warnings), `valid:true`. All 164 parts placed, all nets wired, the 16 intentionally unconnected pins set no-connect (`setPinNoConnect` batch).
- **Designators are EasyEDA's own, not the SKiDL refs.** `schematic_batch_write` operationIds are not designators; EasyEDA numbers parts by prefix (RP2040 = U4, flash U8, DAC U11, ADC U12, ADC crystal U13, TLV9062 chips U14 and U15, SN74LVC1G3157 U16/U17/U18, MT3608 U19, OPA197 U20, TMP117 U9/U10, accelerometer U7?, etc.; resistors and capacitors follow placement order). Read the real ones from `easyeda_schematic_components` (limit 100, use `offset`; the 60 KB reply is saved to a file by the harness). Keep a SKiDL-ref -> primitiveId map in a scratch file while wiring and use primitive ids, never designators, in `connect_pins_by_net` (a designator is rejected).
- TLV9062 unit B (pins 5, 6, 7) must carry the same designator as its unit A, or it becomes a separate designator that collides with other parts and leaves the footprint's pads 5-7 without nets. Chip 1 = U14 (unit B id 9ed70091b05687e4), chip 2 = U15 (unit B id 7e974e0e0b9b3812); both renamed after the first validation showed them colliding with U10/U11. Re-run `validate_netlist` after any designator edit.
- Timeouts (15 s "Bridge method timed out") on `connect_pins_by_net`, `net_detail` and `component_pins` were caused by the EasyEDA focus drifting to another document (the user working in another tab), not by net size: call `DMT_EditorControl.openDocument(<schematic page uuid>)` first when calls start failing ("failed to get all pins of the component" is the other symptom). With the focus right, nets of up to 6 pins apply in about a second; a 16-pin net still timed out, so chunk large nets (6 pins per call; GND took 25 calls).
- BOM follow-ups before any order: the ADC crystal U13 carries LCSC "C9900177807" because it uses the C9002 library part (3.2 x 2.5 mm, 4 pads) as a stand-in; set its LCSC/MPN fields to C21900468 (3X016384UP, 16.384 MHz, 16 pF) and check the pad numbering against the data sheet. R31 resolved to "1206W4F100KT5E" with value 1 ohm (EasyEDA's own record), so the earlier doubt about C17928 is settled. The layout of the sheet is a spaced grid, not a presentable schematic.
- Next: the user imports into the `main_board` PCB (Alt+I), then outline/placement/routing there. The PCB is 85757acc0463db9b.

- **Multi-unit parts and the PCB (2026-10-31):** the TLV9062 (U14, U15) is two schematic instances each (SubPartName `.1` with Unique ID `gge94`/`gge95`, AddIntoPcb true; `.2` with empty Unique ID, AddIntoPcb false). After Import Changes the footprint's pads 5-7 had no nets (found with `PCB_Net.getAllPrimitivesByNet`), and the dialog said "no changes" even after deleting and re-adding the footprints. Test in progress: copy unit A's Unique ID onto unit B (`SCH_PrimitiveComponent.modify(id, {uniqueId})`, done for both chips). If a re-import still lacks the nets, a component pad's net cannot be set through the API (`PCB_PrimitivePad.modify` on a component pad fails), so use two single op-amps instead. `SCH_Netlist.getNetlist` times out on this sheet.

- **Fix for multi-unit parts (2026-11-01, confirmed):** the PCB lost the pins of a second schematic unit because that instance had `AddIntoPcb:false` (the library default for unit 2). `SCH_PrimitiveComponent.modify(unitBId, {addIntoPcb:true})` on the schematic (page focused first) plus a user Alt+I made pads 5-7 of U14/U15 carry their nets with no duplicate footprint; the earlier "No changes" dialog had been the importer ignoring the unit-B instances. Do this for any multi-unit part before the first import (the Unique ID copy is not what fixed it). Validator after: 0 errors on main_board and both heads.
- Fork assessment (`~/Downloads/easyeda-mcp-pro` v1.6.0): the extension's `api.call` is a generic path caller (`easyeda-bridge-extension/src/api-runtime.ts`), so the import problem was EasyEDA behaviour, not the MCP server; a fork would add little.

- **Main board placement attempt (2026-11-01):** outline is a polyline on layer 11, now x -100..4100, y -3300..150 mil (106.7 x 87.6 mm; id 21627621fb40ee9d; the first 100 x 80 mm one gave 7 pad-to-outline DRC errors with the auto layout and was deleted). `PCB_Document.autoLayout()` / `startAutoLayout()` (EDA >= 3.2.150; typings in `/opt/apps/easyeda-pro/resources/app/assets/pro-api/<version>/api-types.d.ts`) time out the bridge at 15 s but keep running in EasyEDA and move the parts afterwards. The first run gave a usable spread inside the outline (DRC: 7 outline + 1 pad clearance errors, 526 connections); my second explicit call then collapsed the parts into a dense, overlapping central cluster, so the layout is non-deterministic and a second run must not be started. `easyeda_pcb_autoroute` on the 164-part board also times out at 15 s (heads took 1 s); its effect was not visible afterwards. Decision for next session: compute a deterministic floorplan in a scratch script (footprint sizes from `PCB_PrimitiveComponent.getAllPinsByPrimitiveId`) and move each part with `easyeda_pcb_modify_component` (many parallel calls), then autoroute in a job (`startAutoRouting` + `getAutoJobStatus`, which also times out for the first call, so poll with the jobId from `getAutoJobLog` or just wait and capture the canvas). Do not ask the user to commit the `.eprj2` in this state.

- **Patched MCP server (2026-11-01):** `easyeda_pcb_modify_component` is broken in v1.6.0: its input schema has no `projectId` but the handler requires one (`verifiedPcbIdentity` in `easyeda-bridge-extension/src/pcb-read-operations.ts`), so it always answers "PCB project identity unavailable". `api_call` `PCB_PrimitiveComponent.modify` works but returns about 3 KB of state per part. Fork at `~/Downloads/easyeda-mcp-pro` (branch `local/batch-place`, built with Node 24.22.1 via `corepack pnpm@11.28.8 install --ignore-scripts` then `npx tsc -p tsconfig.build.json`): new tool `easyeda_pcb_place_batch` (`placements:[{primitiveId,x,y,rotation?}]`, `confirmWrite:true`, loops `PCB_PrimitiveComponent.modify`, returns `{moved, failed}`); `~/.claude.json` `mcpServers.easyeda-mcp-pro` now runs `node ~/Downloads/easyeda-mcp-pro/dist/index.js` (backup of the old entry: scratchpad `claude.json.bak`; the old one was `bunx easyeda-mcp-pro`). The EasyEDA extension itself is unchanged (still 1.6.0). Floorplan: `tools/floorplan_main_board.py` reads `hardware/easyeda/exports/main_board_parts.json`, writes `main_board_placement.json` (designator -> id, x, y, rotation; extent fits the 106.7 x 87.6 mm outline). Next session: call `easyeda_pcb_place_batch` with those placements (chunks of about 40), capture the canvas, run DRC, then autoroute as a job.

- **Main board placed (2026-11-01):** `tools/floorplan_main_board.py` placement applied with the fork's `easyeda_pcb_place_batch` (164 parts in three calls, 0 failures); headers H1-H4 were respaced (x 1250/1560/1850/2150, y -3140) after 3 pad-clearance DRC errors; then DRC showed only the 526 unrouted connections (no outline or clearance errors). Edge connectors (signal pads inward) and USB-C on the right edge came out as intended. Signal autoroute (`easyeda_pcb_autoroute`, GND ignored, 45 degree, completion) times out the bridge at 15 s and runs for many minutes inside EasyEDA (user saw a progress percentage); `PCB_Drc.check` keeps reporting the open connections until it finishes. Orientation of the JST and USB-C connectors is inferred from pad geometry (not verified in the 3D view). Orientation check is a user task after routing.
- **PR prep (2026-11-01):** fork `arcticoder/easyeda-mcp-pro` cloned at `~/Code/typescript/easyeda-mcp-pro`, branch `fix/pcb-component-project-id` (upstream HEAD 83a30d6 still has the bug): `focusedProjectId()` in `src/tools/L1_pcb_write.ts` reads `DMT_Project.getCurrentProjectInfo` through `api.call` and passes `projectId` to `pcb.listComponents` (the root cause of "PCB project identity unavailable"; falls back to `{}` if unreadable), plus the new `easyeda_pcb_place_batch` tool. Unit tests (`tests/unit/tools/pcb-write.test.ts`, 67 pass with the resilience file), `tsc --noEmit` and `lint-tool-metadata` pass. Confirmed live 2026-11-01 with the PR build (`~/.claude.json` now runs `~/Code/typescript/easyeda-mcp-pro/dist/index.js`): modify_component preview, apply and restore work. `pnpm verify:fast` needs a `pnpm` shim for corepack (nested scripts otherwise pick the Windows pnpm 10.8.1): a script `pnpm` that runs `corepack pnpm@11.28.8 "$@"` first on PATH, Node 24.22.1; new tools also need `pnpm generate:capability-docs` and the `approxToolCount` values in `src/config/profiles.ts` + `tests/unit/config/profiles.test.ts`. PR: https://github.com/oaslananka/easyeda-mcp-pro/pull/811 (opened 2026-11-01). `~/Downloads/easyeda-mcp-pro-old` is the original clone with the first batch-tool patch (branch `local/batch-place`).

- **Routing status (2026-11-01):** first signal pass (GND ignored) left 22 signal connections open on 11 nets (3V3_D, I2C_SCL, I2C_SDA, SPARE_A/F/G/H, USB_DP, LED1_MOD, DUT_EN, QSPI_SD1) besides the 149 GND ones; a second `routingNets` pass for exactly those nets was started at about 11:45. Then: GND pours on both layers (user rebuilds copper in Copper Manager), GND autoroute for the rest, DRC 0, `native_checks.json`, validator, user checks connector orientation in the 3D view, then the `.eprj2` commit request.

- Main-board pours (2026-11-01): `PCB_PrimitivePoured.getAll` returns one object per pour with `pourFills` (a non-empty list = filled; 162 KB output, save-to-file and count with python). A screenshot shows the fill as solid colour. `PCB_Drc.check(true,false,true)` on this board returns nested `[MaxDepth]` placeholders: read the per-net `count` fields. The canvas shows no autorouter progress bar after the bridge times out in the capture; ask the user whether it is still running before starting another pass.
- Autorouter slowness (2026-11-01, user report: crawls from 35% to 40% in minutes on main_board, twice, after restarting EasyEDA; earlier boards finished in seconds): cause unverified; suspect the 369 filled GND pour pieces as obstacles (the first signal passes ran before any pour existed). The typings (`pro-api/*/api-types.d.ts` `IPCB_AutoRoutingProps`) have no router-engine field (JRouter/HRouter is UI-only) but this EasyEDA (3.2.x) lists `PCB_Document.startAutoRouting/getAutoJobStatus/cancelAutoJob/getAutoJobLog` as "since v4.1.79": calling `startAutoRouting` through `api_call` timed out after 15 s like `easyeda_pcb_autoroute`, so it is probably absent or blocking here; no jobId came back. Fallback if it stalls: no autorouter for GND; add a GND via beside each pad listed in the DRC "GND" connection errors (top and bottom pours then join), via `easyeda_pcb_add_via`/`PCB_PrimitiveVia.create`, plus a short track where the pad is enclosed. Rebuild copper after vias (user, Copper Manager).
- Patching `pro-api/0.3.59.1ca9efb5/api.js` (asked 2026-11-01; not done): it is only the thin RPC client of EasyEDA's `pro-api` package (`rpcCall("extensionApi.PCB_Document.autoRouting", cfg)`); the handlers live in the app (`app.js`, 2.6 MB), and the config object it sends (`routingRange, routingCorner, isKeep, routingEffectPriority, routingNetPriority, layers, ignoreNets, ignoreLayers`) has no router-engine field, so adding one in api.js would change nothing unless the app's handler reads it; it is also checksummed in `extension.json` and unverified whether the MCP bridge extension loads it at all. Not worth it. The 15 s timeout is the MCP server's `BRIDGE_TIMEOUT_MS` (default 15000, max 120000, `src/config/env.ts`), set through the server's `env` in `~/.claude.json`; it only lengthens the wait for a reply, the autorouter itself keeps running either way. Copper rebuild is already in both the API (`PCB_PrimitivePour.rebuildCopperRegion`) and the MCP (`easyeda_pcb_rebuild_copper`, per-pour `pourIds`); what blocked it was the persisted read-back guard in `~/.easyeda-mcp-pro/easyeda-mcp-pro.sqlite`, not a missing API. Untried this session: calling `rebuildCopperRegion` through `api_call` (`PCB_PrimitivePour.rebuildCopperRegion` on one pour id) would sidestep the guard.
- **Autorouter engines and job-API patch (2026-11-01).** The app is split: `app.js` is only the Electron shell; the editor lives in `assets/pro-pcb/*/js/pcb.js` (class `lge`, instance `x2`, rpc services registered with `A.messageBus.rpcService`), `assets/pro-ui/*/js/ui.js` (class `Vg` plus the `PCB_Document:{...}` registry that `eda.pcb_Document.*` resolves through) and `pcbRouterWorker.js`. There is no router-name field and none is needed: `autoRouting` picks the engine from `routingEffectPriority` (API `optimization`): 1 (default, "completion") publishes `pangolin/autoRouting_wasm` (`PCBRouter` wasm), 0 ("faster") publishes `pangolin/autoRoutingJR` (the JRouter wasm). My `startAutoRouting` call of 2026-11-01 used 0 (JRouter); the earlier MCP runs used the default 1. Which one the user's UI calls HRouter is not confirmed. The app version (3.2.209) has no `startAutoRouting/getAutoJobStatus/cancelAutoJob/getAutoJobLog` handlers although `pro-api/api.js` calls them (so they hang to the 15 s timeout). `tools/patch_easyeda_autoroute_jobs.py` adds them (originals saved as `*.orig`, `--revert` restores, refuses if an anchor string changed, so re-run it after an EasyEDA update; effect only after a restart, which kills a running route): `PCB_Document.startAutoRouting(props)` returns `{jobId}` at once; `getAutoJobStatus(jobId)` returns `{jobId,state(running|completed|canceled|failed),progress 0-100,error,partial}` (progress from `lge.updateProgress`); `getAutoJobLog`; `cancelAutoJob` (manual `routerInterrupt`). Syntax-checked with `node --check`; untested live and the pro-pcb `extension.json` md5 list was not updated (unknown whether EasyEDA verifies it). Next: after the restart call it through `api_call` (`PCB_Document.startAutoRouting` args `[{RoutingNets:["GND"],existingPrimitiveMode:"keep",optimization:0|1}]`), poll status until completed, then DRC; then change the fork's `easyeda_pcb_autoroute` to use the job calls.
- **Router option + job API live (2026-11-01, later).** After the user's restart `PCB_Document.getAutoJobStatus("x")` returns null at once (job API loaded). The patcher now also adds `router` ("pangolin" | "jrouter", overrides `optimization`): `pcb.js` engine choice (`lge.autoRouting`), and `api.js` `getAutoRoutingUserConfig` passes `router` through (it builds the config object field by field, so an unknown prop was dropped). Needs another restart to load; verify by starting a GND job with `router:"jrouter"` and polling. The user declined the `BRIDGE_TIMEOUT_MS` change: do not offer it again. State of the killed GND route unknown: re-run DRC (`PCB_Drc.check(true,false,true)`; before it, 98 GND + 22 signal errors).
- **Job API in use (2026-11-01, evening).** Start: `PCB_Document.startAutoRouting` through `api_call` with `[{RoutingNets:[...],existingPrimitiveMode:"keep",router:"jrouter"|"pangolin"}]` returns `{jobId}` at once; poll `getAutoJobStatus(jobId)` (a poll every 1-2 minutes from a background `sleep` is enough). main_board results: JRouter GND-only pass took about 10 minutes (progress 16% after 20 s, 19% after 1.5 min, 89% after 4 min, 93% after 6 min, completed after about 10) and cut the GND connection errors from 98 to 33; a pangolin pass for the 10 open signal nets (3V3_D, I2C_SCL, I2C_SDA, SPARE_A/F/G/H, USB_DP, LED1_MOD, QSPI_SD1; two open connections each) took about 4 minutes and changed nothing, so the autorouter cannot connect them with the other copper in place (their primitives are pads only: `PCB_Net.getAllPrimitivesByNet("USB_DP")` returns just two pads). `completed` with `partial:true` is what a finished job reports; success is judged by DRC. Several of the open ratlines run from the RP2040 area to the bottom-edge parts (H1-H4, connectors), so hand-routing them means long runs across a dense board: consider moving parts or routing them on a layer with fewer GND tracks first.
- **Job API gotchas (2026-11-01).** (1) The app's 15-minute API timeout timer (`setTimeout` in `lge.autoRouting`) is never cleared, so an earlier job's timer fires during a later job and interrupts it (job state `failed`, "Auto routing timed out after 15 minutes", after about 8 minutes); the patcher now guards it (loads at the next EasyEDA restart; until then leave 15 minutes between job starts). (2) A JRouter pass for the 10 open signal nets sat at 50% for 12+ minutes with nothing added; cancelled with `cancelAutoJob` (manual interrupt keeps the geometry already placed). Both engines leave the same 20 signal connections open, so the signals need hand routing or part moves; GND stands at 33 open connections after the JRouter pass (98 before).
- **main_board routing state (2026-11-01, late).** DRC: 41 clearance errors (12 track-track, 7 track-via, 6 hole-track, 10 copper-track, 3 copper-via, 3 copper-hole) and 24 connection errors (6 GND, 18 on the 9 listed signal nets, two open connections each; LED1_MOD, 3V3_D, I2C_SCL, SPARE_A/F/G/H, USB_DP, QSPI_SD1; I2C_SDA dropped out). The clearance errors appeared after I cancelled a pangolin GND pass at 60% (progress reaches only about 60% in 13 minutes; the 15-minute timeout would undo the whole run, so cancelling keeps interim geometry that has clearance violations); a second completed pangolin pass added nothing. The bridge's DRC returns only counts (nested `[MaxDepth]`), so the user's DRC panel is the source of per-error locations (item 1 in `TODO-arcticoder.md`). Offline connectivity model for GND: `PCB_Net.getAllPrimitivesByNet("GND")` (490 KB, saved by the harness) gives Pad/Track/Via/Copper/Polygon records (Copper coordinates and pad `topWidth/topHeight` are in units of 10 mil, pad `center`, track and via coordinates in mil); a union-find over pad/via/track/copper overlap found 22 isolated GND pad groups (mostly single passive pads, no island big enough for a 24 mil via), plan script was in the session scratchpad only. Upstream state: PRs #813 (modify_component fix) and #816 (`easyeda_pcb_place_batch`, independent implementation) are merged; #811 can be closed; the fork's branch is older than upstream main, switch the MCP to upstream when convenient (needs a rebuild and a session restart).
- **DRC detail (2026-11-01).** `[MaxDepth]` in `PCB_Drc.check` results comes from the bridge extension's `normalizeValue(result, 5)` in `easyeda-bridge-extension/src/api-runtime.ts` (`callAllowedApi`), not from EasyEDA; `callAllowedApi` accepts any method found on an allowed `eda.<class>`, so a string result passes through untouched. The patcher adds `PCB_Drc.checkJson(strict, ui, verbose)` to `pro-api/api.js` (class `VT`, returns `JSON.stringify` of the whole result with cycle guard). Use it via `api_call` `PCB_Drc.checkJson` args `[true,false,true]` after the restart; untested whether the structured result keeps the per-error primitive ids/coordinates (the app's own DRC panel shows them). The user will not click through the app any more: everything is coded, and they restart EasyEDA when asked.
- **DRC detail works (2026-11-01, late).** `api_call PCB_Drc.checkJson [true,false,true]` returns the whole DRC result as a JSON string (about 70 KB: save it to a file; the first try dumped it into context). Each clearance item has `obj1/obj2` ids and types (`errData`), net suffixes, layer, `position` (divide-by-10 units: multiply by 10 for mil); each connection item has `objs` (primitive ids) and `pos`. What it showed on main_board: 12 GND tracks and 5 GND vias from the cancelled pangolin pass overlapped other nets' tracks (d = 0 mil); I deleted them with `PCB_PrimitiveLine.delete([ids])` and `PCB_PrimitiveVia.delete([ids])` (ids from `errData.obj1/obj2` whose suffix starts with `(GND)`), which cleared those 28 errors and re-opened GND (26 connection errors, many of them dangling router stubs `(GND): e19xx/e20xx` and pads). The 13 remaining clearance errors are the stale GND pour fills (top `e0e0`, bottom `e1e1`) against the I2C_SDA track/vias a router pass added after the pours were filled: the pours need rebuilding. `easyeda_pcb_rebuild_copper` fails with "readback-mismatch" (`Pour deb152eb... != 6a590aab...`, its verification compares the wrong pour) and is then guard-locked; the patcher adds `PCB_PrimitivePour.rebuildCopperById(id|ids)` to `api.js` (calls the app's rebuild rpc, one pour per call) and raises the API autoroute time limit from 15 to 60 minutes (`pcb.js`); both load at the next restart. Plan: rebuild both pours (ids `6a590aab3806d515` top, `deb152eb4908f417` bottom; check `PCB_PrimitivePour.getAll` for current ids), run a GND pangolin pass to completion (it reached 60% after 13 minutes before), DRC via `checkJson`, then the 9 signal nets.
- **main_board re-floorplan and routing lessons (2026-11-01, chat 5).** (1) A GND pangolin pass on the dense board, a pour rebuild, then deleting dangling GND stubs made things worse: the stubs were the only link between some pads and a via, so removing them opened 15 pad connections; and 9 stitching vias+tracks I placed by hand (shapely script, scratchpad only) mostly landed in pour fragments of the congested RP2040 area (the vias themselves then showed as unconnected). Conclusion: the 106.7 x 87.6 mm placement (margin 28 mil per part) is too dense to route; the free copper fragments (26 `Copper Region(Filled)` "free" errors) and the 18 signal ratlines around U4 cannot be fixed by stitching. (2) `tools/floorplan_main_board.py` now takes `FP_SCALE` (spreads anchor positions and interior; edge parts keep hugging their edges, right/bottom edges shift out) and `FP_MARGIN` (per-part bbox margin, default 28). Used 1.1 and 40: outline now polyline x -100..4520, y -3650..160 mil (117.3 x 96.8 mm; new id 6e7bf56be77fbe8f); the old outline was deleted, pours recreated (`PCB_PrimitivePour.create("GND", layer, {$complexPolygon:[[-80,140,"L",4500,140,4500,-3630,-80,-3630,-80,140]]}, "solid", false, name, 1, 0.2, false)`; new ids GND_TOP 473110e174a939f3, GND_BOT 0311cc6a827b5195). `FP_SCALE=1.0 FP_MARGIN=28` reproduces the old placement. Placement applied with `easyeda_pcb_place_batch` (4 calls, 164 parts, 0 failed). (3) `startAutoRouting` with `RoutingNets` = all non-GND nets and `existingPrimitiveMode:"remove"` removes existing copper ONLY on the listed nets: old GND tracks stayed at their old positions and overlapped the new signal tracks (841 clearance errors). Re-routing GND in remove mode cleared the GND vias but left 385 GND tracks (deleted by id from `PCB_PrimitiveLine.getAll`). Lesson: after moving parts, delete all tracks/vias of every net first (ids from `getAll`, `PCB_PrimitiveLine.delete(ids)` takes a long array in one call). (4) A pangolin GND pass again produced about 300 GND tracks overlapping signal tracks at 0.2 mil (324 clearance errors) even though the job said completed: do not use the autorouter for GND; rely on the two pours plus stitching vias. (5) Signals alone routed to 9 open nets (XIN, DVDD_1V1, DUT_EN, MON_5V, LED1_MOD, LED2_MOD, I2C_SDA, I2C_SCL, SPARE_A/G/H) with 0 clearance errors; GND with no router copper leaves 89 SMD pads + 1 TH pad without a pour connection. (6) Each `PCB_PrimitiveVia.create`/`PCB_PrimitiveLine.create` reply is about 1.5 KB of state; the patcher now adds `PCB_PrimitiveVia.createMany([[net,x,y,hole,dia],...])` and `PCB_PrimitiveLine.createMany([[net,layer,x1,y1,x2,y2,width],...])` (ids only; needs an EasyEDA restart; `easyeda_pcb_add_via` fails with a generic create error even with valid numbers). (7) Stitching plan method: pull pads/lines/vias with `getAll` (the harness saves 1 MB files), shapely obstacles per layer (non-GND pads, tracks buffered by width/2, vias), candidate via centers on a ring 7 mil outside each unconnected GND pad polygon so the 24 mil via copper overlaps the pad edge (no track needed), reject any within 8 mil of other-net copper on either layer, add each accepted via to the obstacle set; 68 of the 90 open pads had a spot, 22 (U10_6, U17_3, U9_2, U10_3, U12_10/13/27/32, C22_2, C64_2, R26_2, U11_4, R22_2, C65_2, U4_19, C44_2, R19_1, C32_2, CN12_6, CN4_2, D1_2, R45_2) did not. Scripts lived in the session scratchpad; recreate from this description as `tools/stitch_gnd_pads.py` if needed again. (8) DRC-by-detail parsing: `PCB_Drc.checkJson` result is `[ {name,count,list:[{name,count,list:[item]}]} ]`; item.explanation.errData has obj1/obj2/obj1Suffix/obj2Suffix; net is the text in the suffix parentheses. State at the end of chat 5: main_board saved (2026-11-02T01:27Z); 0 clearance errors, 114 connection errors (90 GND pads, 24 on the 9 signal nets above); GND stitching vias not yet placed (waiting for the restart that loads `createMany`).
- **GND stitching done with createMany (2026-11-01, late).** After the restart `PCB_PrimitiveVia.createMany` works (68 vias in one call, ids returned). Vias were placed overlapping the unconnected GND pad edges per the plan (7 mil ring around the pad polygon, 8 mil clearance to other-net copper); pours rebuilt (`rebuildCopperById` with both ids); DRC: 1 clearance error (via 688a8dec3aaa1920 near the USB-C slot region of USBC1, deleted afterwards) and 63 connection errors: 39 GND (about 22 pads that had no via spot, e.g. U9_2/7, U10_3/6, U12_10/13/27/32, U17_3, C22_2, C65_2, C64_2, R26_2, U11_4, R22_2, C15_2, C10_2, U4_19, CN4_2/6, D1_2, C9_2, R24_2, R45_2, R48_2, R15_1, R19_1, C32_2, C39_2, C44_2, plus about 10 stitching vias that landed in pour fragments around U4, e.g. e460-e510) and 24 on the nine open signal nets (XIN U4_20/U7_1, MON_5V R47_2/U4_39, DUT_EN R26_1/U4_15, DVDD_1V1 U4_23 + vias e357/e359, LED1_MOD R22_1/U4_8, LED2_MOD R24_1/U4_9, I2C_SDA R9_2/U4_6, I2C_SCL R10_2/U4_7 + via e432, SPARE_A H1_1/U4_4, SPARE_G H4_1/U4_11, SPARE_H H4_2/U4_12). Everything left is in the RP2040 (U4) escape area and the spare-header run to the bottom edge: route those by hand with `PCB_PrimitiveLine.createMany` (U4 east-side pads at x about 2420+; bottom-layer escapes through vias), then move the stranded stitching vias next to a pad with a short track. `PCB_Drc.checkJson` returns the result INLINE when it is under the harness limit (about 50 KB): a DRC reply of 63 errors cost about 25k tokens of context; to avoid it, call it only when the board is nearly clean, or ask for `PCB_Drc.check` counts first. The project was saved at 2026-11-02T02:15Z.
- **Offline maze router `tools/route_open_nets.py` (2026-11-01, late).** Inputs: `getAll` dumps of pads, lines and vias; output: a plan for `PCB_PrimitiveLine.createMany` / `PCB_PrimitiveVia.createMany`; env `RT_PITCH` (grid, mil) and `RT_CLR` (clearance, mil). Findings on the 9 open signal nets plus DVDD_1V1/XIN/DUT_EN: at a 5 mil grid nothing routes (the 0.4 mm-pitch U4 pads need the finer grid; the DRC rule is 4 mil track-to-track, 6 mil slot-to-via); at 2.5 mil / 4.5 mil clearance only XIN and DUT_EN found paths, and they are absurd detours (XIN, a crystal input, ran about 2000 mil around the board with 8 vias; DUT_EN 14 vias) so they were NOT applied; MON_5V, LED1_MOD, LED2_MOD, I2C_SDA, I2C_SCL, SPARE_A/G/H and DVDD_1V1 have no path at all because the pads are enclosed by fan-out tracks of neighbouring pins on both layers (an ASCII dump showed U4_20's pad boxed in by tracks above and below, with a free pocket only beyond a 5 mil blocked row). Conclusion: the pangolin fan-out around U4 uses the escape corridors; the remaining nets cannot be added without ripping up. Runtime: about 15 s per net at 5 mil, 2-5 minutes per net at 2.5 mil (pure Python A*).
- **Next approach for the U4 area (decision 2026-11-01).** Rip up every signal track and via that touches U4's neighbourhood (or all signals on the board) and route them with `tools/route_open_nets.py` in a deliberate order (crystal XIN/XOUT and USB first, short nets before long ones, nets sharing a bus together) instead of letting pangolin consume the corridors; or make room first (move the U4 decoupling capacitors and the SPARE headers H1-H4 farther out, or place the spare-header nets on the bottom layer by moving H1-H4 to the other side). Do not apply a plan whose length is more than about 2x the pad-to-pad distance for a clock or analog net.
- **DRC call sizes.** `PCB_Drc.checkCompact(strict, ui, maxErrors)` is added to the patcher (loads at the next restart): returns `{counts:{group:n}, errors:["group|type|obj1|obj2|ids|x_mil|y_mil|distance"]}` with `errors` empty unless `maxErrors` > 0, so a full state check costs about 300 characters; use it in place of `checkJson` for loops, `checkJson` only for a one-off deep dive.
