arcticoder/spurious-force-balance/hardware/balance/boards/fab/arm.png

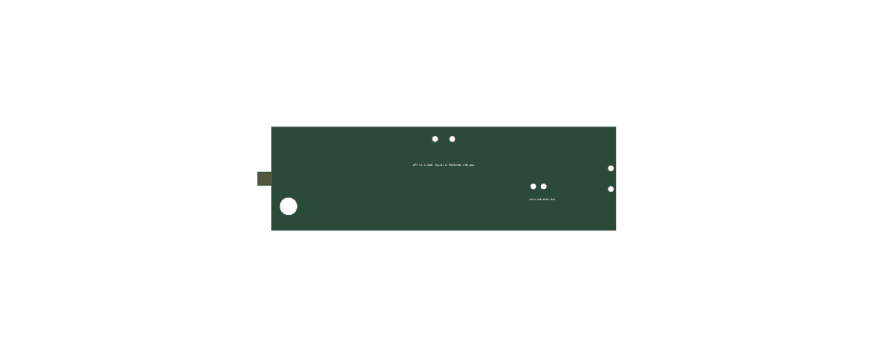
hardware/balance/boards/fab/arm.png
