arcticoder/spurious-force-balance/hardware/balance/boards/fab/clamp_plate.png

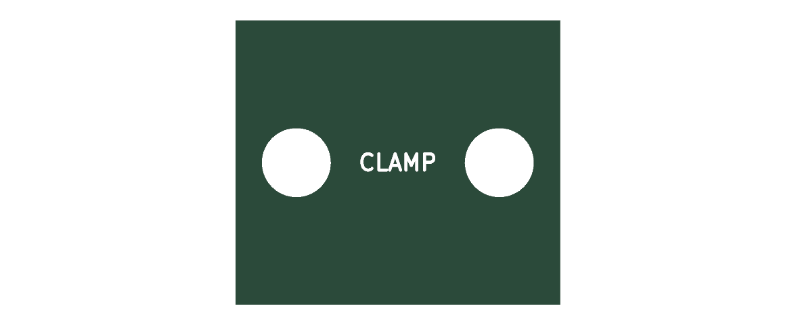
hardware/balance/boards/fab/clamp_plate.png
