arcticoder/spurious-force-balance/hardware/balance/boards/fab/elec_board.png

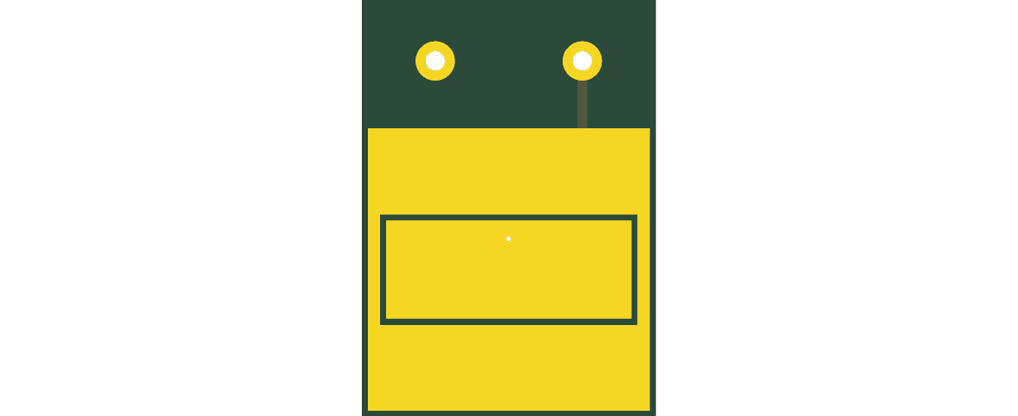
hardware/balance/boards/fab/elec_board.png
