arcticoder/spurious-force-balance/hardware/balance/cad/views.png

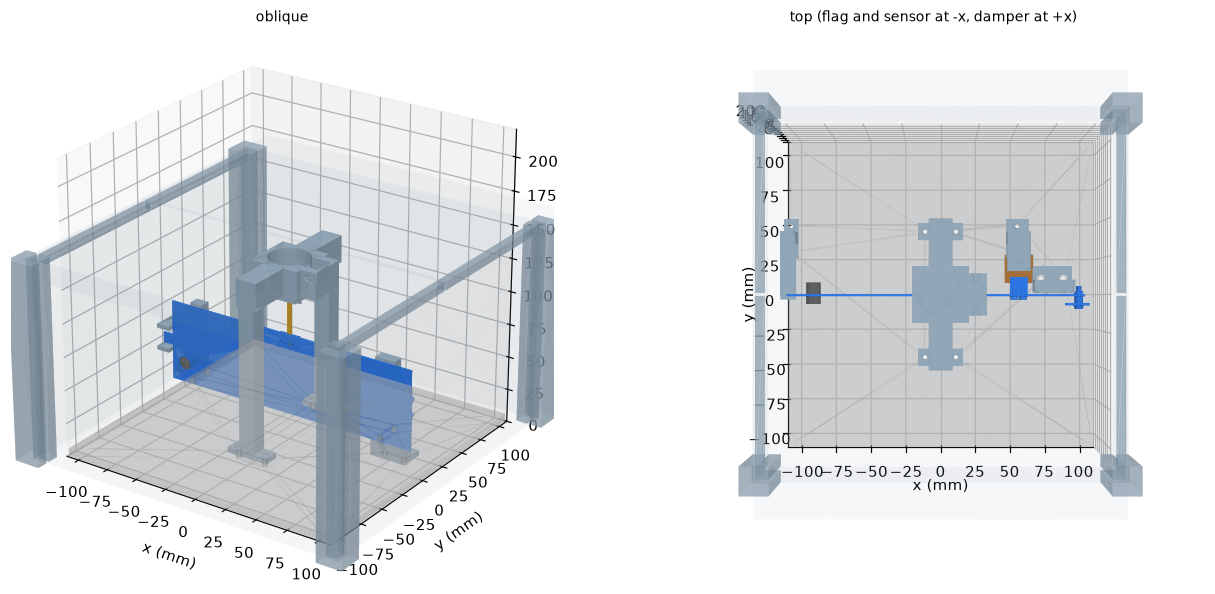
hardware/balance/cad/views.png
