arcticoder/spurious-force-balance/hardware/instrument/heads_panel/out/heads_panel.png

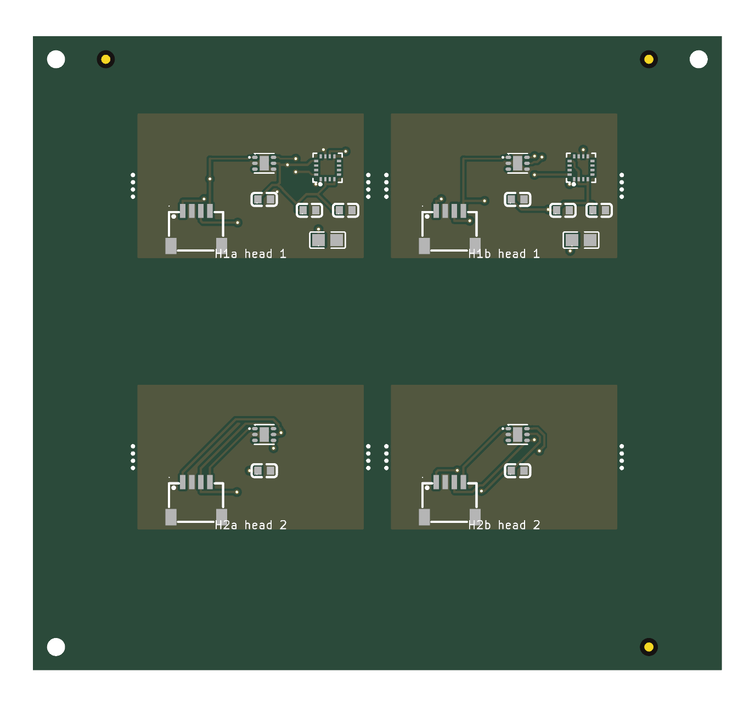
hardware/instrument/heads_panel/out/heads_panel.png
