arcticoder/spurious-force-balance/docs/kb/fab_ordering_notes.md

# KB: ordering fabrication from JLC (PCB, PCBA, 3D printing, CNC) — shipping, minimums, tactics

Audience: future LLM sessions. Ingested 2026-10-24 from a user-supplied pair of LLM chats (a Gemini answer on JLC shipping and a
Grok review of it) and checked against web sources the same day. The chat transcript itself was not committed. Tags: **[confirmed]**
read on a JLC/OSH Park page on 2026-10-24 (URL given); **[community]** third-party measurement or guide; **[second-hand]** stated
by an LLM chat and not checked; **[verify at checkout]** always read the live quote page. Prices drift with promotions and destination.
The user is in Canada (British Columbia area) and pays by the cheapest postal tier.

## Shipping

- JLC shipping is dearer than AliExpress's free tier because there is no retail margin to subsidize freight, FR-4 is dense, and each
  custom order is packed and tendered on its own; AliExpress consolidates thousands of parcels. [second-hand, plausible]
- **The 0.3 kg cliff on "Global Standard Direct Line":** one 2024 measurement (Peter Tanner, `petertanner.dev/posts/JLCPCB-shipping-price-hack/`)
  found the price jumping from 3.18 at 0.18–0.29 kg to 14.35 at 0.33 kg, **in Australian dollars for an Australian destination**, so the
  numbers don't transfer; only the shape does. [community; the 0.3 kg threshold is not on any JLC page found] Treat 0.3 kg as a
  working limit and read the quote.
- Board weight in the quote uses the **bounding rectangle × thickness**, so cutouts and odd outlines don't lower it; assembly raised one
  quoted mass past a tier. [community]
- Direct Line may be limited to orders under a total value, may not prepay duties, and the price has moved with promotions (about
  $1.50 for a 100 × 100 mm 5-piece order in some 2025 promos). [community / second-hand]
- **Canada:** JLC's shipping-policy page lists a 20 CAD threshold for Canada [community snippet of jlcmc.com/help/article/Shipping-Policies;
  read it before ordering]. Couriers (DHL, UPS, FedEx) bill brokerage on parcels over about CAD 20, which can double a small order's cost;
  postal tiers are usually cheaper, with an optional Canada Post collection fee (users report $5–10). [community] **Check at checkout** whether GST is collected up front.
- **Combine Shipping (a JLC add-on)** [confirmed, `jlcpcb.com/help/article/combine-shipping-service`, page dated Sep 2026]: turn it on under
  Add-On Services, choose a trigger (by weight, by order count, or a fixed weekly schedule), and orders are held until the trigger is
  met; you then pick a courier and pay storage and shipping. **Free storage is 15 days** from the first order's arrival at the warehouse
  (fees from day 16). A search snippet of an older version said 7 days; the live page says 15. The page does not list which products
  qualify or say whether one order can be split. Separate sources: PCB, stencil, SMT parts and JLCMC mechanical parts ship together
  since August 2024; JLC3DP and JLCCNC orders combine with PCB orders [second-hand; verify the qualifying list at checkout]. One order
  (one design × quantity) is one unit and cannot be split across parcels. [second-hand, consistent with the page]
- The slowest process sets the ship date of a combined parcel (CNC and 3D printing are usually slower than PCBs). [second-hand]
- A freight forwarder or factory pickup adds inbound fees and courier minimums that exceed the saving at this volume; not used.
  Paying for boards and having JLC discard them isn't an option. [second-hand]

## Board orders

- **Price tier:** 2-layer boards under 100 × 100 mm are the $2 tier for 5 pieces; 4–8 layers must be under 50 × 50 mm for the same
  price. [confirmed on a Hack Club guide, `hwdocs.hackclub.dev/user-contrib-guides/jlc-cost-optimizing/`, undated, US-focused]
- **Minimum 5 bare boards per design.** Keep or recycle the rest. Panelization (below) is the way to get several designs per 5 boards.
- **Assembly:** economic PCBA accepts 2–50 pieces [confirmed, `jlcpcb.com/solutions/pcb-prototype-assembly`], so a 5-board order can
  have 2 assembled; one assembled is not offered. Economic assembly places parts on one side. [community guide]
  Each **extended** part adds a loading fee of about $3 [community guide; the repo's `parts.py` counts 27 extended]. Standard (two-sided)
  assembly has a setup fee about $17 higher. [community guide] JLC also marks individual parts "Standard only"; one such part puts the whole board on Standard.
  As of the live check of 2026-10-24, two of the instrument BOM's 50 parts are (the accelerometer C189624 and magnetometer C404329); **Decision (H5, 2026-10-24): the electronics order uses Standard assembly**, keeping both sensors (the magnetometer measures the budget's field term and has no Economic equivalent). Fallbacks if it is dropped: NXP MMA8452Q C11360 for the accelerometer. [`jlc` CLI, live]
- **Thickness:** weight scales with thickness, so 1.0 or 1.2 mm instead of 1.6 mm cuts board mass about 35–40%. [arithmetic; second-hand]
  FR-4 is about 1.85 g/cm³, so a 100 × 100 mm 1.6 mm board is about 30 g and five are about 150 g, plus packing.
- **Panelizing:** designs can share a board with mouse-bites or V-cuts. JLC's panel page suggests 150–200 mm panels and says nothing
  about mixed-design surcharges [confirmed absent, `jlcpcb.com/help/article/panelizing-your-pcb-for-assembly`]; a fee of about
  $3–4 for multiple designs in one file is reported [second-hand; ask JLC support]. A board that is two designs joined once pays one
  assembly setup.
- Steel stencils add weight and area; leave them out unless needed. [second-hand]
- **Two small shipments under the weight limit can cost less than one over it.** [community]

## Alternatives

- **OSH Park** [confirmed, `docs.oshpark.com/services/two-layer/`]: 2-layer, ENIG finish standard, $5 per square inch for **3 copies**,
  free shipping worldwide, 9–12 days (Super Swift $10 per square inch, 4–5 business days); 1.6 mm board (a 0.8 mm 2-layer 2 oz service
  exists), purple mask. Customs and brokerage for Canada are not stated; check. Useful for tiny ENIG boards.

## How this repo uses it (decisions of 2026-10-24; full record in `docs/fabrication.md`)

- **FR4 boards as structure.** The balance's arm, strip clamp plates and fixed electrode are unassembled JLC boards (four designs, 5 pcs each, 1.2 mm, black mask, ENIG on three): they fix the thermal,
  creep and mass-uncertainty problems of printed parts and need no cutting. Everything fixed is PLA on the user's K1. No JLC3DP or JLCCNC part is needed now.
- **Every JLC parcel targets under 0.29 kg estimated** (boards 154 g for the mechanical order plus about 40 g packing [assume]); a smoke check holds the mechanical order to that.
- **Two JLC shipments:** the mechanical boards now, the electronics (5 bare, 2 assembled; sensor heads panelized together; no stencil) after the A5 prototype measurement, because 15 free days of Combine Shipping
  storage cannot bridge weeks of measurement.
- **Arm board over the cheap tier:** 200 x 60 mm. If its quote is over about $60 or the parcel over 0.29 kg, ask the user before changing anything: a shorter arm needs a damper rework (zeta 0.10 per pad at 75 mm).
- **Separate small designs rather than a mixed panel** unless the quote shows the panel cheaper (a mixed-design surcharge is unconfirmed). OSH Park is dearer for the arm and comparable for the small boards.
- **AliExpress for stock parts only after the design fixes the counts** (acrylic, washers, 304 nuts, JST-SH cable, weights, tools).

## 2026-10-27 additions (user's JLC account; prices there are in CAD)

- **Coupons** [user-supplied, in `lab/docs/jlc/coupons.md` once Part I1 is done]: most new-user coupons end 2026-11-25 (PCB C$8.42, SMT C$14.03, CNC C$28.06, shipping, 3D printing 1, mechanical parts 1), the others 2026-12-25; the larger JLCONE $8 PCB (C$11.22) and JLCONE-$20 CNC (C$28.06) end 11-26; the full list, including the EasyEDA-only and PCBA Special Offer coupons, is in `lab/docs/jlc/coupons.md`; only one coupon applies per order (C$14.03 = US$10 at the account's rate on 2026-10-27); generic 30/60-day ones carry no date in the list. One coupon per checkout; monthly SMT coupons lapse at month end. The "shipping" coupons apply only above a shipping charge of C$20.99 (all services) or C$55.97 (global ship), so they do not combine with the $3-4 postal tier. [user-supplied: EasyEDA exports reportedly unlock PCBA coupons withheld from Gerber uploads, and publishing to the Open Source Hardware Hub reportedly yields project coupons of $10 up to $400; both unverified, see backlog]
- **Mass rule** [community: petertanner.dev, 2024]: JLC estimates a board's mass from its bounding rectangle times thickness, so cut-outs and panel gaps still count; the cheap Global Standard Direct Line tier jumps at 0.3 kg (AUD 3.18 at 0.29 kg, 14.35 at 0.33 kg in 2024). Several orders with Combine Shipping on become one parcel, so combine only below 0.29 kg; two parcels of $3-4 beat one heavy parcel of $14+. PCBA packaging options (cardboard, ESD) add weight.
- **Standard PCBA minimum is 70 x 70 mm with edge rails in the design; stencil and assembly are processed per order; Economic needs only 10 x 10 mm, single side, $8 setup** [user's capture of the quote page, `lab/docs/jlc/pcba_quote_ui.md`]. Consequence for the two Standard-only sensors: the heads must ride on a panel of at least 70 x 70 mm.
- **HDI** launched 2026-09-14 [jlcpcb.com/news/hdi-pcb-manufacturing-services]: the page gives no thickness, layer, via or price data; the quote UI lists "HDI: microvia, minimum laser via 75 um". It changes via technology and density, not the mass rule.
- **JLCCNC's sheet-metal quote page shows only a file upload to a visitor** (the specification window appears after an upload); JLCMC's product pages list fastener categories but no product data without a search: both need the user's captures.
- **Arm stiffness (computed, `hardware/balance/material_study.py`)**: with the device card, vane and ballast on it the arm's first bending mode is about 36 Hz at 1.2 mm FR4 (E 20 GPa; two 100 mm cantilevers bending in the thin direction), 29 Hz at 1.0 mm, 22 Hz at 0.8 mm, 54 Hz at 1.6 mm; 0.8 mm aluminium matches FR4 1.2 mm (24.8 g, 36 Hz); printed PLA needs 2 mm for 32 Hz and has 5x the thermal drift. (An earlier unloaded estimate of 64 Hz ignored the lumped masses and was wrong.) The decision (FR4 vs aluminium) waits on quotes: `docs/fabrication.md`.
- **Coupons do not stack in one checkout**: the SMT and the stencil coupons cannot both apply to the same PCBA order.

## Observed quotes (user, CAD at the account's rate; the quote pages cannot be read from a session)

- **Arm alone, 5 pieces, 208 x 60 mm** (2026-10-28): Engineering fee C$5.61, Board C$8.56, Surface Finish ENIG +C$25.25 (HASL: C$0). **Thickness defaults back to 1.6 mm at every upload: at 1.6 mm the page estimated 0.34 kg and the Global Standard Direct Line shipping was C$12.05; at 1.2 mm it is under 0.3 kg and shipping is C$2.10.** Quantity cannot go below 5. Subtotal with shipping and the JLCONE coupon (-C$8.42, applied when the line went into the cart): **C$7.86** (FR4 1.2 mm, green, HASL with lead).
- The mass JLC estimates includes about **155 g of packing**: five arms are 185 g at 1.6 mm by the bounding-rectangle rule and the page showed 0.34 kg (`tools/jlc_parcel_mass.py`, `PACKING_G`; one data point). The arm's parcel at 1.2 mm is 294 g of the 300 g line: nothing else fits in it. The shipping method's "<=55 x 40 cm" restriction is not the issue for these boards.
- The small default board shows the new-user "special offer" price of about C$2.81 (5 pieces up to 100 x 100 mm); the arm (over that size) gets the normal lines. Coupons are applied at the payment step and in the cart; a coupon cannot take a line below zero. The user states two coupons can be used per order. The earlier $70-140 estimate for the four boards was wrong (the arm is C$7.86 net).
- The `jlc` command-line tool searches the LCSC/EasyEDA parts catalogue only: it has no PCB, CNC or shipping quote; the JLC quote pages are scripts a fetch cannot read. Every other JLC price in this repo is an estimate.

## JLC small-board pricing read from the quote page (2026-11-04; details in `lab/docs/jlc/small_boards_panel_quote_2026-11-04.md`)

- A 5-piece 2-layer board up to 100 x 100 mm as **Single PCB, 1 design** gets a **C$2.79 Special Offer**, independent of 1.2 versus 1.6 mm and HASL; very small boards add "Deburring/Edge rounding" (C$0.28 at 14 x 16 mm, C$0.14 at 17-34 mm). "Confirm Production file = Yes" adds C$1.46. The PCB coupons need goods over C$2.79, so they do not apply to Special Offer orders.
- **Panel by Customer** adds C$5.65 per design beyond the first (3 designs: Engineering 5.57 + Panel 11.31 + Board 2.37 = C$19.25 for the 36 x 96.5 mm `small_panel`), so the three small balance boards are ordered as three single-board orders, one order per day at most (the user's rule), not as the panel. Declaring a multi-design file as one Single PCB would misstate it; do not.
- HDI (4 layers, 1-step) is C$188.11 for the same file; JLCCNC sheet metal is quoted manually in 2-4 hours after an upload (`lab/docs/jlc/hdi_quote_ui.md`, `cnc_sheet_metal_quote_ui.md`). The arm order (Y3) order page, read through the app on 2026-11-08 in USD: merchandise $10.10, shipping $7.75 (Global Standard Direct Line, 0.28 kg), discount -$15.35, PayPal fee $0.50, total $3.00. The earlier "merchandise 1.20 + shipping 1.80" was wrong. Order pages are in USD while the card is charged in CAD (the elec_board order, placed 2026-11-05: $2.10 + $1.50 shipping = $3.60 USD = C$5.10, about 1.42); quote-page figures (C$2.79 offer, C$2.92 calculated) are CAD estimates. Status table in `hardware/balance/boards/fab/ORDER.md`.
- **Shipping series on the Global Standard Direct Line (2026-11-08 analysis):** Y3 arm, 0.28 kg, 2026-11-03: US$7.75; elec_board, 0.14 kg, 2026-11-05: US$1.50; clamp_ground Y5, 0.14 kg, 2026-11-06: about C$2.12 (derived: grand total C$5.08 less merchandise C$2.96); clamp_plate Y6, 0.14 kg, 2026-11-08: C$8.14 (about US$5.77). Weight and destination are the same for the last three, so the rise is in the rate (a promotional rate ending, or a rate change), not in the parcel. The 0.3 kg cliff does not explain it. Support is the only way to confirm. Coupon behaviour: the Y3 discount exceeded its goods, so coupons can take off shipping at checkout; the test for clamp_plate is in `TODO-arcticoder.md`.
- Order state: the arm (HASL) is ordered and in JLC's review; elec_board, clamp_ground and clamp_plate are three user tasks in `TODO-arcticoder.md`; the account's unused coupons are in `lab/docs/jlc/coupons.md`.

## Shipping discount line (read 2026-11-09)
The Global Standard Direct Line's list rate was US$5.77 for 0.14 kg and US$7.75 for 0.28 kg on the order pages; Y3/Y4/Y5 each carried an order-level DISCOUNT line (Y4/Y5: -US$4.27, net shipping US$1.50) that absorbed shipping. The clamp_plate checkout showed the list rate. Plan with the list rate unless the cart shows the discount. See `lab/docs/kb/jlc_account_and_quotes.md`.
