arcticoder/spurious-force-balance/hardware/instrument/parts.md

# Candidate parts — instrument board (WP2)

Generated by `hardware/instrument/parts.py` from the JLC parts snapshot; do not edit by hand.
Every part is machine-placed SMT in JLCPCB's library. Quantities are per main board and are fixed by the schematic (WP4).
Before ordering, run `parts.py --live` (live stock, basic/extended, Economic-vs-Standard PCBA).

| Group | Role | LCSC | Type | Qty | In stock | Unit price (5) | Part | Why |
|---|---|---|---|---|---|---|---|---|
| core | RP2040 microcontroller | C2040 | extended | 1 | 53,168 | $0.9966 | RP2040 (LQFN-56(7x7)) | keeps every RP2040 register address the repo's code uses; PIO + DMA for the LED modulation and ADC readout |
| core | QSPI flash, 16 Mbit | C131025 | extended | 1 | 3,665 | $1.2638 | W25Q16JVSSIQ (SOIC-8-208mil) | W25Q16JV, the flash on the Pico itself, so MicroPython and the repo's firmware boot unchanged |
| core | RP2040 12 MHz crystal (the Raspberry Pi Pico crystal) | C20625731 | extended | 1 | 10,637 | $0.6245 | ABM8-272-T3 (SMD3225-4P) | ABM8-272-T3: 10 pF load, 50 ohm ESR, 30 ppm; the RP2040 hardware design guide says any other crystal needs extensive testing, so this exact part is used with its 15 pF load capacitors and 1 kohm series resistor |
| core | USB-C receptacle, 16-pin | C165948 | extended | 1 | 367,975 | $0.1872 | TYPE-C-31-M-12 (SMD) | power and data |
| core | USB ESD protection | C7519 | extended | 1 | 32,269 | $0.1781 | USBLC6-2SC6 (SOT-23-6L) | USBLC6-2SC6 on D+/D-/VBUS |
| core | input polyfuse, 0.75 A hold | C20987 | extended | 1 | 6,459 | $0.1022 | SMD1206P075TF (1206) | SMD1206P075TF; the USB budget peaks near 390 mA (pins.py) |
| core | tactile switch (BOOTSEL, RESET) | C318884 | basic | 2 | 296,384 | $0.0207 | TS-1187A-B-A-B (SMD-4P,5.1x5.1mm) | basic part |
| power | 3.3 V LDO, 250 mA, 6.5 uVrms noise (analog and digital rails) | C80670 | extended | 2 | 57,672 | $0.1652 | LP5907MFX-3.3/NOPB (SOT-23-5) | LP5907-3.3, one part number for both rails: the analog rail (ADC AVDD, op-amps, optical heads, 82 dB PSRR at 1 kHz) and the digital rail (RP2040, sensors, logic); the digital load stays under 100 mA (pins.py) |
| power | ferrite bead, 600 ohm at 100 MHz | C1002 | basic | 2 | 717,275 | $0.0116 | GZ1608D601TF (0603) | analog rail split (3V3_A carries under 50 mA; the bead is rated 200 mA); basic part |
| power | boost converter (to 24 V) | C84817 | extended | 1 | 111,362 | $0.0956 | MT3608 (SOT-23-6) | MT3608, 2 V to 24 V adjustable, for the plate driver |
| power | boost inductor, 22 uH | C128694 | extended | 1 | 195,953 | $0.0845 | SMMS0630-220M (SMD,7.1x6.6mm) | SMMS0630-220M, 2.6 A |
| power | Schottky diode, 1 A 40 V (boost, motor flyback) | C2480 | basic | 3 | 1,318,854 | $0.0192 | SS14 (SMA(DO-214AC)) | SS14; basic part |
| analog | 24-bit simultaneous ADC, 4 channels | C882747 | extended | 1 | 2,046 | $6.5515 | ADS131A04IPBSR (TQFP-32(5x5)) | ADS131A04: 79 nV/rtHz input-referred at 3.3 V (TI Table 1), up to 128 kSPS, 16.384 MHz clock |
| analog | ADC clock, 16.384 MHz crystal | C21900468 | extended | 1 | 2,905 | $0.0810 | 3X016384UP (SMD3225-4P) | 3X016384UP, 16 pF, +/-10 ppm |
| analog | quad 12-bit DAC with I2C | C108207 | extended | 1 | 6,786 | $2.3292 | MCP4728-E/UN (MSOP-10) | MCP4728: LED currents, plate drive, device-current set |
| analog | op-amp, dual, 10 MHz, rail-to-rail | C398355 | extended | 4 | 164,086 | $0.1197 | TLV9062IDR (SOIC-8) | TLV9062: LED current sinks; device-under-test current source; TIAs on the heads use the same part |
| analog | op-amp, 36 V, 10 MHz, rail-to-rail output | C221351 | extended | 1 | 97,424 | $0.9163 | OPA197IDBVR (SOT-23-5) | OPA197: electrostatic plate driver on the 24 V rail |
| analog | analog switch, SPDT (LED gate) | C10426 | extended | 3 | 252,661 | $0.1054 | SN74LVC1G3157DBVR (SOT-23-6) | SN74LVC1G3157: gates each LED's current reference from the PIO |
| analog | N-MOSFET, SOT-23 (motor drivers, LED sinks) | C20917 | basic | 4 | 757,862 | $0.0895 | AO3400A (SOT-23) | AO3400A; basic part |
| analog | N-MOSFET, DPAK (device-under-test current sink) | C99124 | extended | 1 | 22,068 | $0.3574 | AOD4184A (TO-252) | AOD4184A, 40 V 50 A; dissipation is the open point of WP3 |
| analog | device-current shunt, 1 ohm 1206 1% | C17928 | basic | 1 | 146,898 | $0.0235 | 1206W4F100KT5E (1206) | 0.3 A gives 0.3 V (90 mW of 250 mW); read by the ADC; basic part |
| analog | device-current ballast, 4.7 ohm 2512 1 W | C25489 | extended | 1 | 222,281 | $0.0379 | 25121WJ047JT4E (2512) | takes 1.3 V and 0.42 W of the 5 V off the sink MOSFET (WP3 thermal check); on the board, not the balance |
| sensors | temperature sensor, 16-bit digital | C699536 | extended | 3 | 26,658 | $1.0261 | TMP117AIDRVR (WDFN-6-EP(2x2)) | TMP117 on the main board; two more on the heads |
| sensors | 3-axis accelerometer | C189624 | extended | 1 | 16,312 | $1.1474 | LIS2DW12TR (LGA-12(2x2)) | LIS2DW12: floor motion and level |
| sensors | 3-axis magnetometer (head board) | C404329 | extended | 1 | 14,167 | $2.0883 | MMC5983MA (LGA-16(3x3)) | MMC5983MA, 18-bit, +/-8 G, I2C/SPI |
| optical | photodiode, SMD 4.4 x 3.9 mm (each head) | C145262 | extended | 2 | 18,857 | $0.5442 | VBPW34S (SMD,4.4x3.9mm) | VBPW34S |
| optical | 940 nm IR LED, 1206, 20 degrees (LED head) | C131280 | extended | 1 | 68,187 | $0.0505 | IR26-21C/L110/CT (1206) | IR26-21C |
| connectors | JST-SH 1 mm, 4-pin, SMD | C160404 | extended | 10 | 60,891 | $0.2151 | SM04B-SRSS-TB(LF)(SN) (SMD,P=1mm,卧贴) | LED heads x2 (3V3A, ground, LED sink, reference-photodiode output), photodiode heads x2 (3V3A, ground, output, ground), I2C heads x2 |
| connectors | JST-SH 1 mm, 2-pin, SMD | C160402 | extended | 4 | 63,871 | $0.1327 | SM02B-SRSS-TB(LF)(SN) (SMD,P=1mm,卧贴) | plate, two motors, device leads |
| connectors | 2.54 mm pin header, 1 x 2, SMD | C41417359 | extended | 5 | 46,091 | $0.0282 | HX PZ2.54-1x2P TP-YQ (SMD,P=2.54mm(交错脚)) | debug serial, SWD, spare I/O in pairs, test pads (Dupont wires plug on) |
| indicators | red LED, 0603 | C2286 | basic | 2 | 7,858,146 | $0.0077 | KT-0603R (0603) | status; basic part |
| passives | resistor 1 kohm 0603 1% | C21190 | basic | 20 | 24,277,749 | $0.0020 | 0603WAF1001T5E (0603) | basic |
| passives | resistor 10 kohm 0603 1% | C25804 | basic | 10 | 32,380,385 | $0.0052 | 0603WAF1002T5E (0603) | basic |
| passives | resistor 5.1 kohm 0603 1% (CC pulldowns, I2C) | C23186 | basic | 3 | 23,749,760 | $0.0015 | 0603WAF5101T5E (0603) | basic |
| passives | resistor 2.2 kohm 0603 1% (I2C pull-ups) | C4190 | basic | 2 | 6,762,276 | $0.0018 | 0603WAF2201T5E (0603) | basic |
| passives | resistor 33 kohm 0603 1% (TIA feedback) | C4216 | basic | 2 | 3,644,037 | $0.0021 | 0603WAF3302T5E (0603) | basic |
| passives | resistor 100 kohm 0603 1% | C25803 | basic | 12 | 19,748,113 | $0.0031 | 0603WAF1003T5E (0603) | basic |
| passives | resistor 51 ohm 0603 1% (LED current sense) | C23197 | basic | 5 | 1,524,650 | $0.0018 | 0603WAF510JT5E (0603) | basic; 1.02 V = 20 mA |
| passives | resistor 47 kohm 0603 1% (plate driver feedback) | C25819 | basic | 1 | 1,993,053 | $0.0021 | 0603WAF4702T5E (0603) | basic; gain 1 + 47k/10k = 5.7 |
| passives | resistor 27 ohm 0805 (USB series) | C17594 | extended | 2 | 252,532 | $0.0029 | 0805W8F270JT5E (0805) | extended; RP2040 USB needs 27 ohm in series |
| passives | capacitor 100 nF 0603 X7R | C14663 | basic | 34 | 50,349,394 | $0.0141 | CC0603KRX7R9BB104 (0603) | basic; decoupling at every supply pin |
| passives | capacitor 1 uF 0603 X5R | C15849 | basic | 16 | 9,868,521 | $0.0152 | CL10A105KB8NNNC (0603) | basic |
| passives | capacitor 10 uF 0805 X5R | C15850 | basic | 6 | 3,710,191 | $0.0692 | CL21A106KAYNNNE (0805) | basic |
| passives | capacitor 22 pF 0603 C0G (crystal loads) | C1653 | basic | 2 | 1,920,262 | $0.0058 | CL10C220JB8NNNC (0603) | basic |
| passives | capacitor 10 pF 0603 C0G (plate-driver feedback) | C1634 | basic | 3 | 1,511,383 | $0.0060 | CL10C100JB8NNNC (0603) | basic; removes an 8.6% overshoot in the WP3 simulation |
| passives | capacitor 1 nF 0603 X7R (TIA feedback, filters) | C1588 | basic | 6 | 6,432,787 | $0.0090 | CL10B102KB8NNNC (0603) | basic |
| power | ferrite bead, 120 ohm at 100 MHz, 2 A | C14709 | basic | 1 | 1,291,458 | $0.0147 | BLM18PG121SN1D (0603) | BLM18PG121SN1D: supply entry and boost input carry up to 0.4 A (the 600 ohm bead C1002 is only rated 200 mA); basic part |
| passives | capacitor 15 pF 0603 C0G (RP2040 crystal loads) | C1644 | basic | 2 | 804,717 | $0.0114 | CL10C150JB8NNNC (0603) | basic; with the crystal's 3 pF stray gives the 10 pF load |
| passives | capacitor 10 nF 0603 X7R 50 V (device-current loop integrator) | C57112 | basic | 1 | 5,976,362 | $0.0102 | 0603B103K500NT (0603) | basic |
| passives | capacitor 4.7 uF 1206 X7R 50 V (24 V boost output and filter) | C132170 | extended | 3 | 58,180 | $0.1138 | CC1206KKX7R9BB475 (1206) | CC1206KKX7R9BB475; 50 V rating because a 25 V part loses most of its capacitance at 24 V of bias |

50 part numbers, 195 components per board; 27 extended parts (JLC charges a per-part setup fee for each extended part on an assembled order, amount to be read on jlcpcb.com at order time); parts cost about $27.49 per board at the 5-piece unit prices (components only: the board, assembly fee and shipping are extra).
