arcticoder/spurious-force-balance/hardware/instrument/fab/bom.csv

Comment | Designator | Footprint | LCSC Part #
CL21A106KAYNNNE | C1,C5,C8,C51,C52 | C0805 | C15850
CC0603KRX7R9BB104 | C2,C9,C10,C11,C12,C13,C14,C15,C18,C19,C22,C23,C24,C25,C26,C28,C30,C31,C32,C33,C38,C46,C47,C57,C58,C59,C60 | C0603 | C14663
CL10C150JB8NNNC | C20,C21 | C0603 | C1644
CL10A105KB8NNNC | C3,C4,C6,C7,C16,C17,C27,C29,C34,C35,C36,C37,C39 | C0603 | C15849
CL10C220JB8NNNC | C40,C41 | C0603 | C1653
CL10B102KB8NNNC | C42,C43,C44,C45 | C0603 | C1588
CL10C100JB8NNNC | C48,C49,C56 | C0603 | C1634
0603B103K500NT | C50 | C0603 | C57112
CC1206KKX7R9BB475 | C53,C54,C55 | C1206 | C132170
SM04B-SRSS-TB | CN1,CN2,CN3,CN8,CN9,CN10 | CONN-SMD_4P-P1.00_SM04B-SRSS-TB-LF-SN | C160404
SM02B-SRSS-TB | CN4,CN5,CN6,CN7 | CONN-SMD_2P-P1.00_SM02B-SRSS-TB-LF-SN | C160402
USBLC6-2SC6 | D1 | SOT-23-6_L2.9-W1.6-P0.95-LS2.8-BL | C7519
SS14 | D2,D3,D4 | SMA_L4.2-W2.6-LS5.0-RD_1 | C2480
SMD1206P075TF | F1 | F1206 | C20987
HX PZ2.54-1X2P TP-YQ | H1,H2,H3,H4,H5 | HDR-SMD_HX-PZ2.54-1X2P-TP-YQ | C41417359
GZ1608D601TF | L1,L2 | L0603 | C1002
BLM18PG121SN1D_C14709 | L3 | L0603 | C14709
SMMS0630-220M | L4 | IND-SMD_L7.3-W6.6_MHCI06030 | C128694
KT-0603R | LED1,LED2 | LED-SMD_L1.6-W0.8-R-RD | C2286
AO3400A | Q1,Q2,Q4,Q5 | SOT-23-3_L2.9-W1.3-P1.90-LS2.4-BR | C20917
AOD4184A | Q3 | TO-252-2_L6.6-W6.1-P4.57-LS9.9-TL-CW | C99124
0603WAF5101T5E | R1,R2,R36 | R0603 | C23186
0603WAF1002T5E | R11,R13,R27,R39,R43,R45,R47,R48 | R0603 | C25804
0603WAF1003T5E | R12,R22,R24,R26,R30,R33,R34,R35,R42,R44,R51,R53 | R0603 | C25803
0603WAF510JT5E | R23,R25,R37,R40,R41 | R0603 | C23197
0805W8F270JT5E | R3,R4 | R0805 | C17594
1206W4F100KT5E | R31 | R1206 | C17928
25121WJ047JT4E | R32 | R2512 | C25489
0603WAF4702T5E | R38 | R0603 | C25819
0603WAF1001T5E | R5,R6,R7,R8,R14,R15,R16,R17,R18,R19,R20,R21,R28,R29,R46,R49,R50,R52 | R0603 | C21190
0603WAF2201T5E | R9,R10 | R0603 | C4190
TS-1187A-B-A-B | SW1,SW2 | SW-SMD_4P-L5.1-W5.1-P3.70-LS6.5-TL_H1.5 | C318884
LP5907MFX-3.3/NOPB | U1,U2 | SOT-23-5_L3.0-W1.7-P0.95-LS2.8-BR | C80670
TLV9062IDR | U10,U11 | SOIC-8_L5.0-W4.0-P1.27-LS6.0-BL | C398355
SN74LVC1G3157DBVR | U12,U13,U14 | SOT-23-6_L2.9-W1.6-P0.95-LS2.8-BR | C10426
MT3608 | U15 | SOT-23-6_L2.9-W1.6-P0.95-LS2.8-BL | C84817
OPA197IDBVR | U16 | SOT-23-5_L3.0-W1.7-P0.95-LS2.8-BR | C221351
RP2040 | U3 | LQFN-56_L7.0-W7.0-P0.4-EP | C2040
ABM8-272-T3_C20625731 | U4 | CRYSTAL-SMD_4P-L3.2-W2.5-BL | C20625731
W25Q16JVSSIQTR | U5 | SOIC-8_L5.3-W5.3-P1.27-LS8.0-BL | C131025
TMP117AIDRVR | U6 | WSON-6_L2.0-W2.0-P0.65-TL-EP | C699536
LIS2DW12TR | U7 | LGA-12_L2.0-W2.0-P0.50-BL | C189624
MCP4728-E/UN | U8 | MSOP-10_L3.0-W3.0-P0.50-LS5.0-TL | C108207
ADS131A04IPBSR | U9 | TQFP-32_L5.0-W5.0-P0.50-LS7.0-TL | C882747
TYPE-C-31-M-12 | USBC1 | USB-C_SMD-TYPE-C-31-M-12_1 | C165948
X322512MSB4SI | X1 | CRYSTAL-SMD_4P-L3.2-W2.5-BL | C21900468
