arcticoder/spurious-force-balance/hardware/instrument/heads_panel/out/bom.csv

Comment | Designator | Footprint | LCSC Part #
C0603 | C1,C4,C5,C8,C9,C10 | C0603 | C14663
C0805 | C2,C6 | C0805 | C15850
C0603 | C3,C7 | C0603 | C15849
CONN-SMD_4P-P1.00_SM04B-SRSS-TB-LF-SN | J1,J2,J3,J4 | CONN-SMD_4P-P1.00_SM04B-SRSS-TB-LF-SN | C160404
WSON-6_L2.0-W2.0-P0.65-TL-EP | U1,U3,U5,U6 | WSON-6_L2.0-W2.0-P0.65-TL-EP | C699536
LGA-16_L3.0-W3.0-P0.50-BL_SQ | U2,U4 | LGA-16_L3.0-W3.0-P0.50-BL_SQ | C404329
