arcticoder/spurious-force-balance/hardware/balance/boards/fab/arm_cnc.dxf

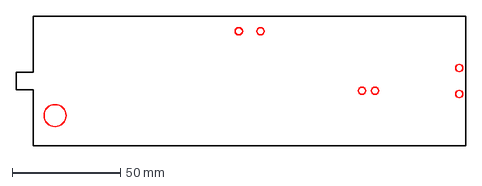
[picture p6: CAD file, 2026-11-14]
hardware/balance/boards/fab/arm_cnc.dxf
208.0 x 60.0 mm
