arcticoder/spurious-force-balance/hardware/balance/cad/fixture_hacksaw_handle_body.stl

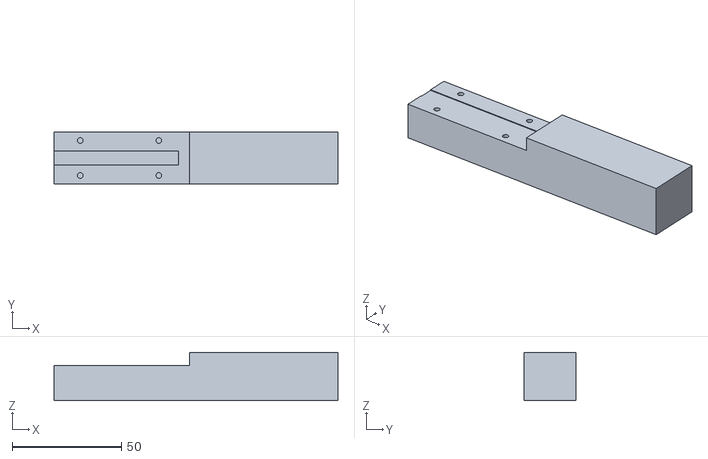
[picture p7: CAD file, 2026-11-14]
hardware/balance/cad/fixture_hacksaw_handle_body.stl
130.0 x 24.0 x 22.0
