arcticoder/spurious-force-balance/hardware/balance/cad/fixture_hacksaw_handle_cover.stl

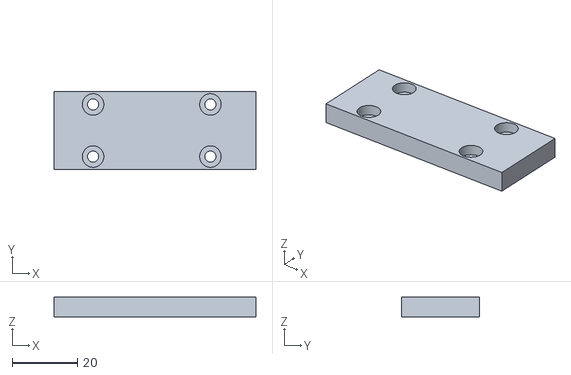
[picture p8: CAD file, 2026-11-14]
hardware/balance/cad/fixture_hacksaw_handle_cover.stl
62.0 x 24.0 x 6.00
