arcticoder/spurious-force-balance/hardware/balance/cad/encl_print_wall_nx_a.stl

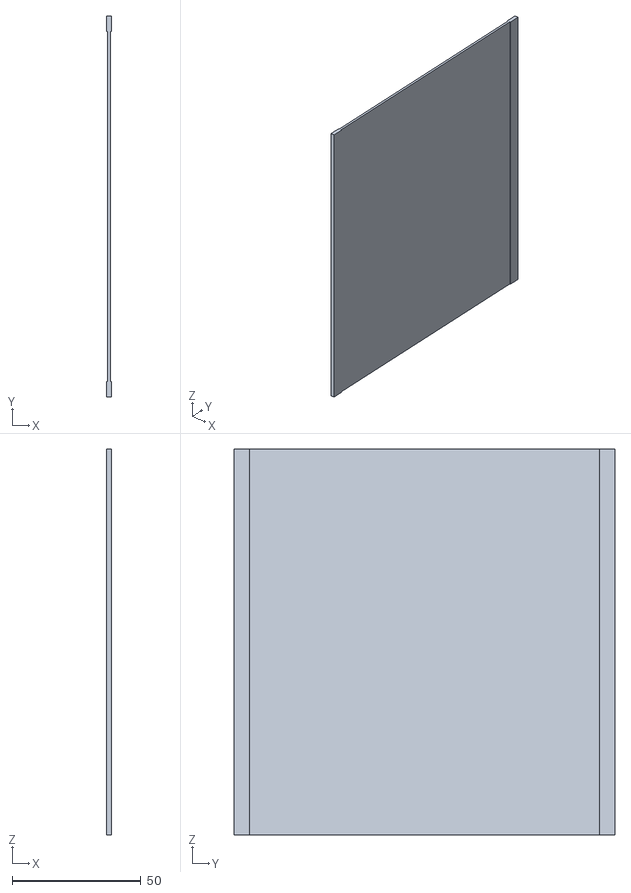
[picture p9: CAD file, 2026-11-13]
hardware/balance/cad/encl_print_wall_nx_a.stl
2.00 x 148.0 x 150.0
