arcticoder/spurious-force-balance/hardware/balance/cad/encl_print_wall_ny_b.stl

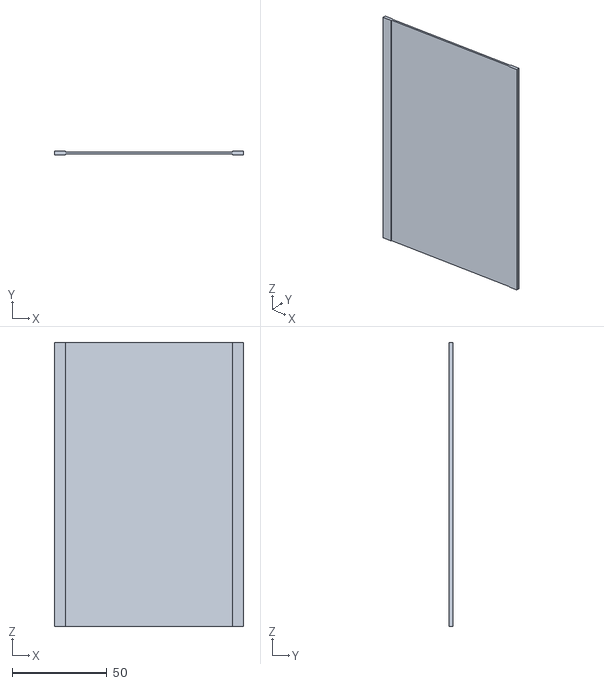
[picture p10: CAD file, 2026-11-13]
hardware/balance/cad/encl_print_wall_ny_b.stl
100.0 x 2.00 x 150.0
