arcticoder/spurious-force-balance/hardware/balance/cad/encl_print_lid_0_b.stl

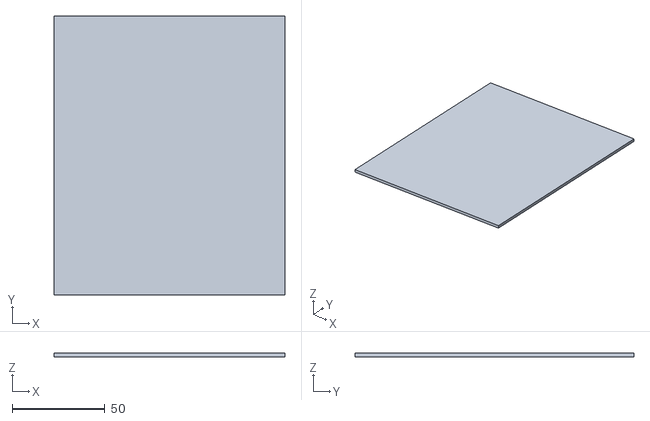
[picture p11: CAD file, 2026-11-12]
hardware/balance/cad/encl_print_lid_0_b.stl
124.0 x 150.0 x 2.00
