arcticoder/spurious-force-balance/hardware/balance/cad/encl_print_lid_1_mullion.stl

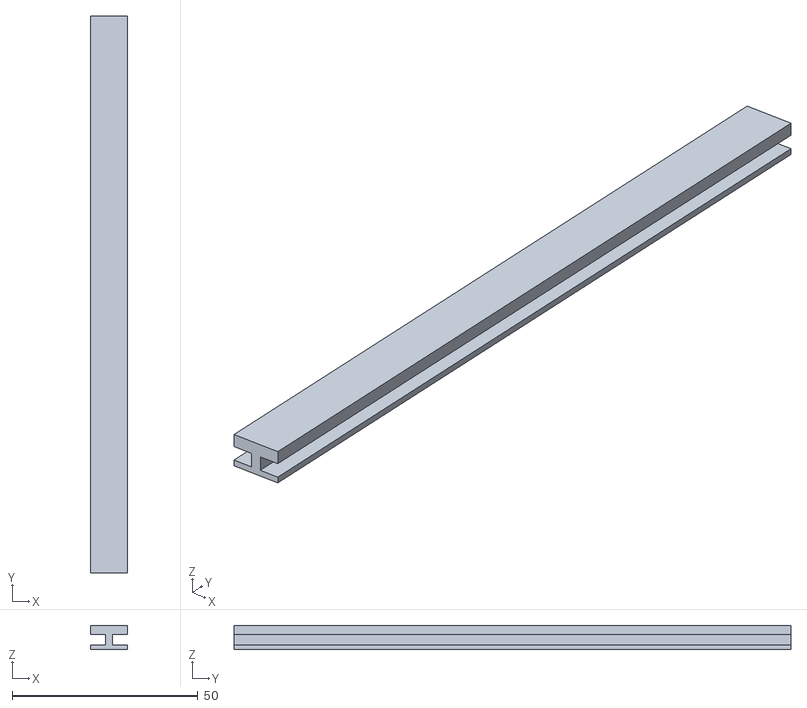
[picture p12: CAD file, 2026-11-12]
hardware/balance/cad/encl_print_lid_1_mullion.stl
10.0 x 150.0 x 6.50
