arcticoder/spurious-force-balance/hardware/balance/cad/encl_print_wall_nx_mullion.stl

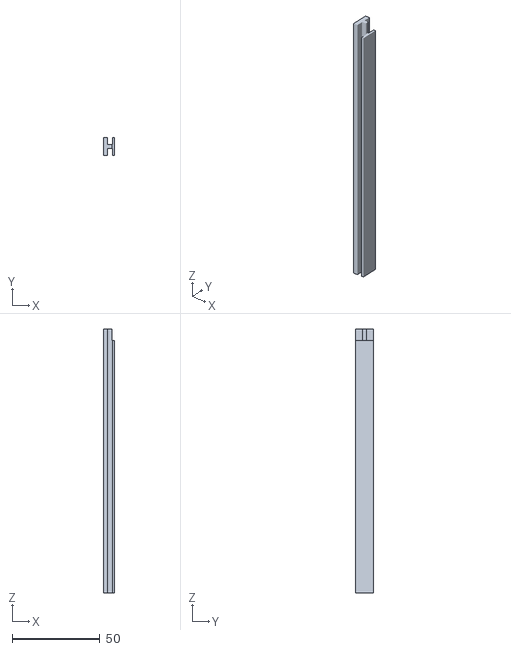
[picture p13: CAD file, 2026-11-12]
hardware/balance/cad/encl_print_wall_nx_mullion.stl
6.50 x 10.0 x 150.0
