arcticoder/spurious-force-balance/hardware/balance/cad/fixture_saw_guide_base.stl

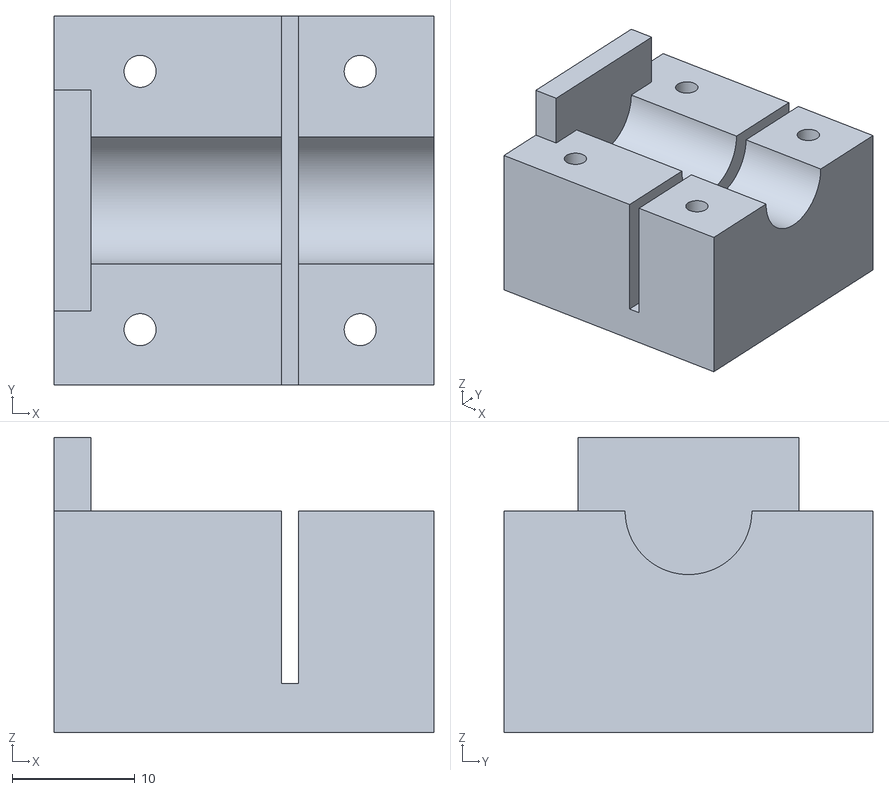
[picture p14: CAD file, 2026-11-12]
hardware/balance/cad/fixture_saw_guide_base.stl
30.9 x 30.0 x 24.0
