arcticoder/spurious-force-balance/hardware/balance/cad/fixture_cal_rider.stl

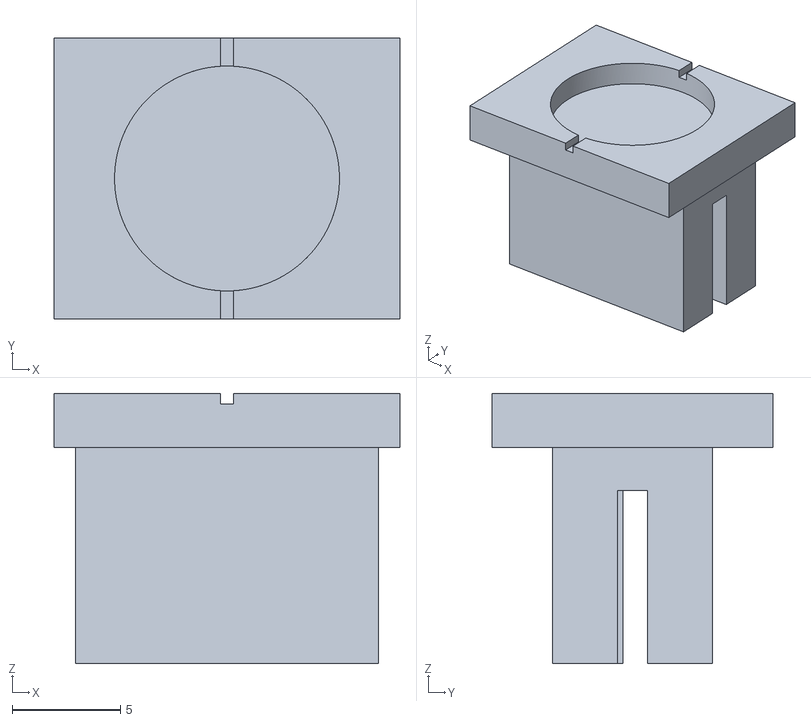
[picture p15: CAD file, 2026-11-12]
hardware/balance/cad/fixture_cal_rider.stl
16.0 x 13.0 x 12.5
