arcticoder/spurious-force-balance/hardware/balance/cad/fixture_saw_guide_plate.stl

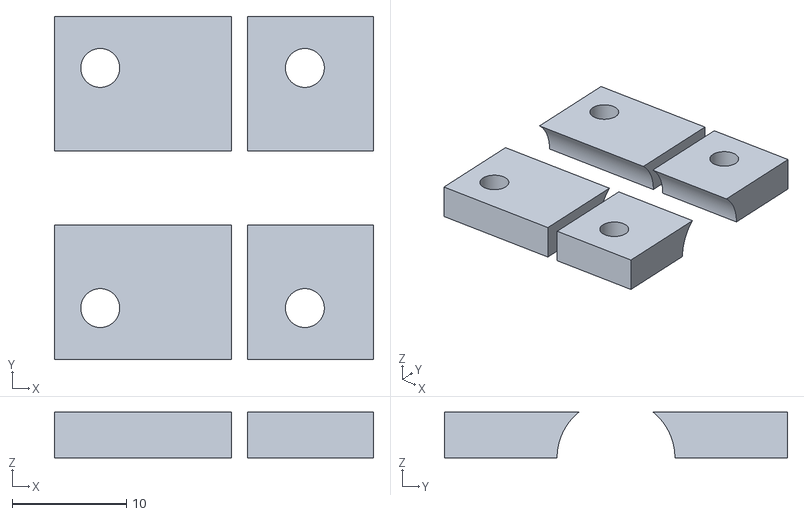
[picture p16: CAD file, 2026-11-12]
hardware/balance/cad/fixture_saw_guide_plate.stl
27.9 x 30.0 x 4.00
