arcticoder/spurious-force-balance/hardware/balance/cad/ballast.stl

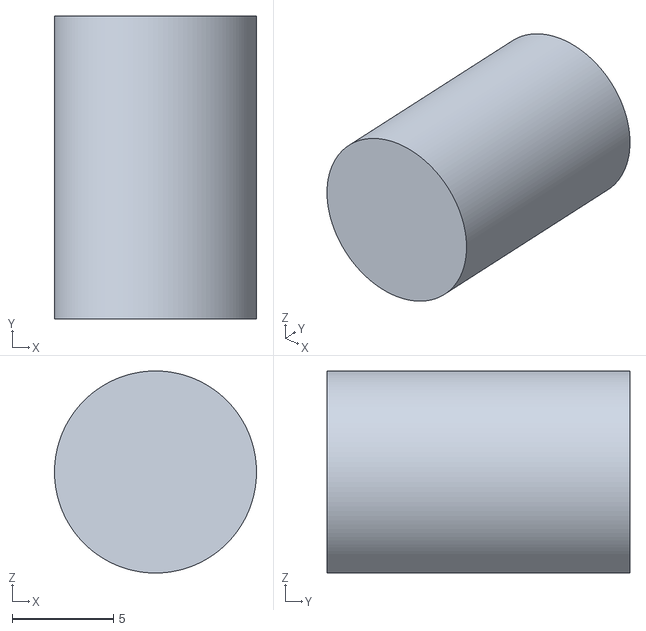
[picture p17: CAD file, 2026-11-11]
hardware/balance/cad/ballast.stl
10.0 x 15.0 x 10.00
