arcticoder/spurious-force-balance/hardware/balance/cad/encl_post_pp_bar.stl

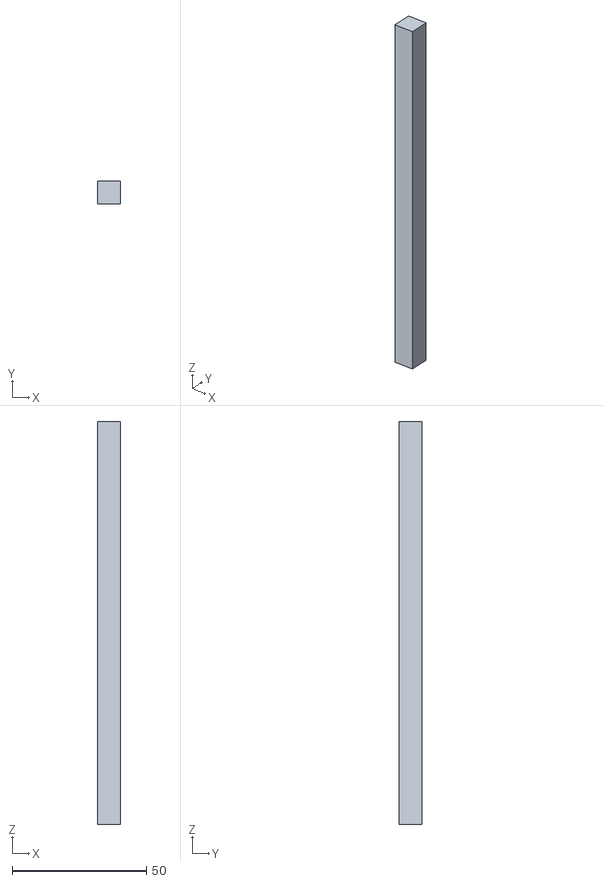
[picture p18: CAD file, 2026-11-11]
hardware/balance/cad/encl_post_pp_bar.stl
8.60 x 8.60 x 150.0
