arcticoder/spurious-force-balance/hardware/balance/cad/encl_post_pn.stl

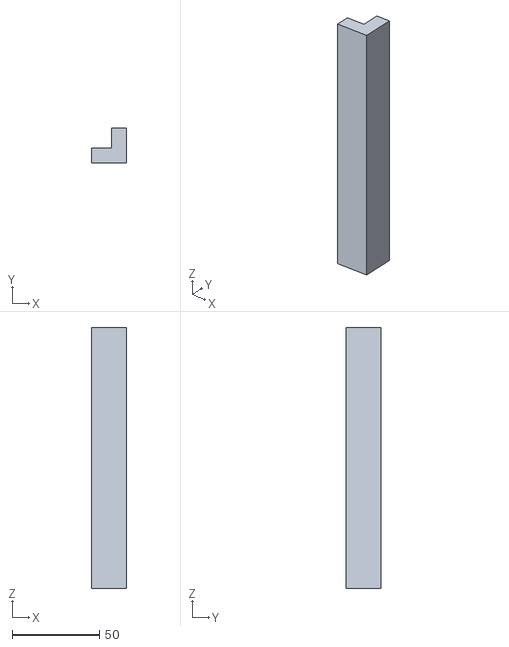
[picture p19: CAD file, 2026-11-11]
hardware/balance/cad/encl_post_pn.stl
20.0 x 20.0 x 150.0
