arcticoder/spurious-force-balance/hardware/balance/cad/balance.step

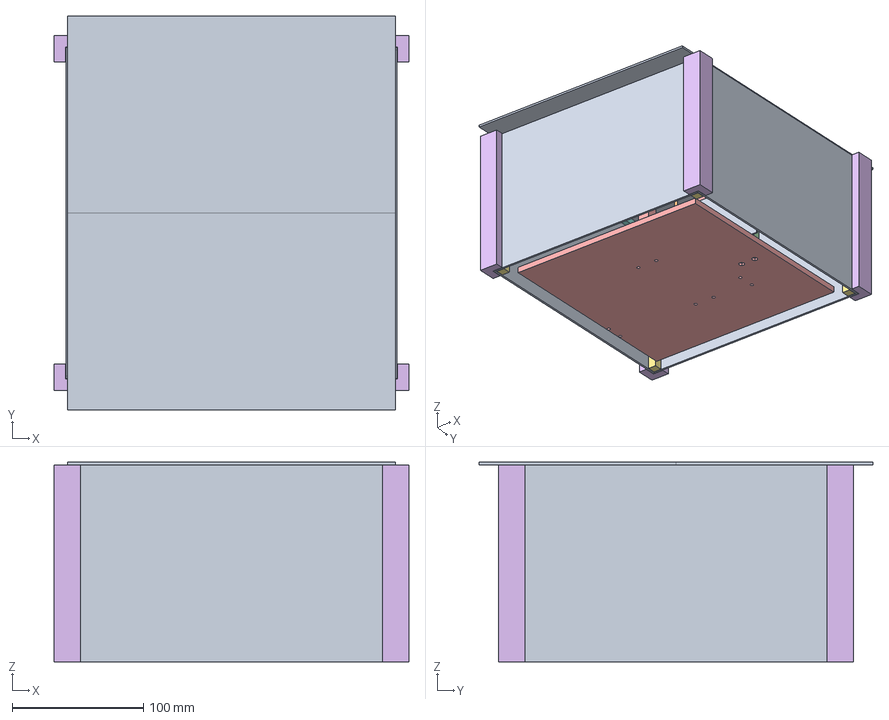
[picture p20: CAD file, 2026-11-11]
hardware/balance/cad/balance.step
270.0 x 300.0 x 152.0 mm
arm
strip
clamp_low
hw_clamp_low
ballast
vane_holder
hw_holder
vane
dut_card
hw_dut
gantry
head
clamp_up_a
clamp_up_b
sensor_bracket
damper_holder
magnet_low_0
magnet_up_0
magnet_low_1
magnet_up_1
elec_board
elec_bracket
base
encl_post_pp
encl_post_pp_bar
encl_post_pn
encl_post_pn_bar
encl_post_np
encl_post_np_bar
encl_post_nn
encl_post_nn_bar
encl_shelf_px_0
encl_shelf_px_1
encl_shelf_nx_0
encl_shelf_nx_1
panel_py
panel_px
panel_ny
panel_nx
encl_lid_a
encl_lid_b
