arcticoder/spurious-force-balance/hardware/balance/cad/magnet_low_1.stl

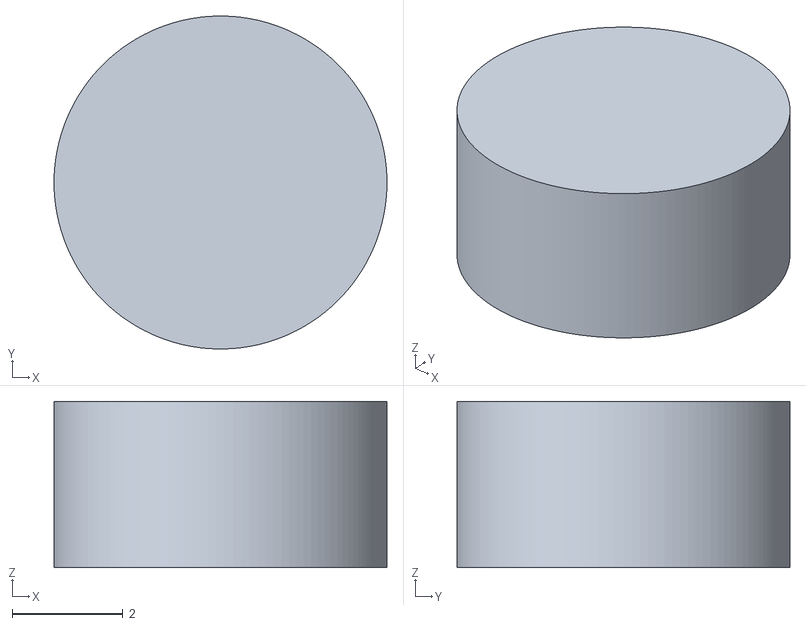
[picture p21: CAD file, 2026-10-27]
hardware/balance/cad/magnet_low_1.stl
6.00 x 6.00 x 3.00
