arcticoder/spurious-force-balance/hardware/balance/cad/dut_card.stl

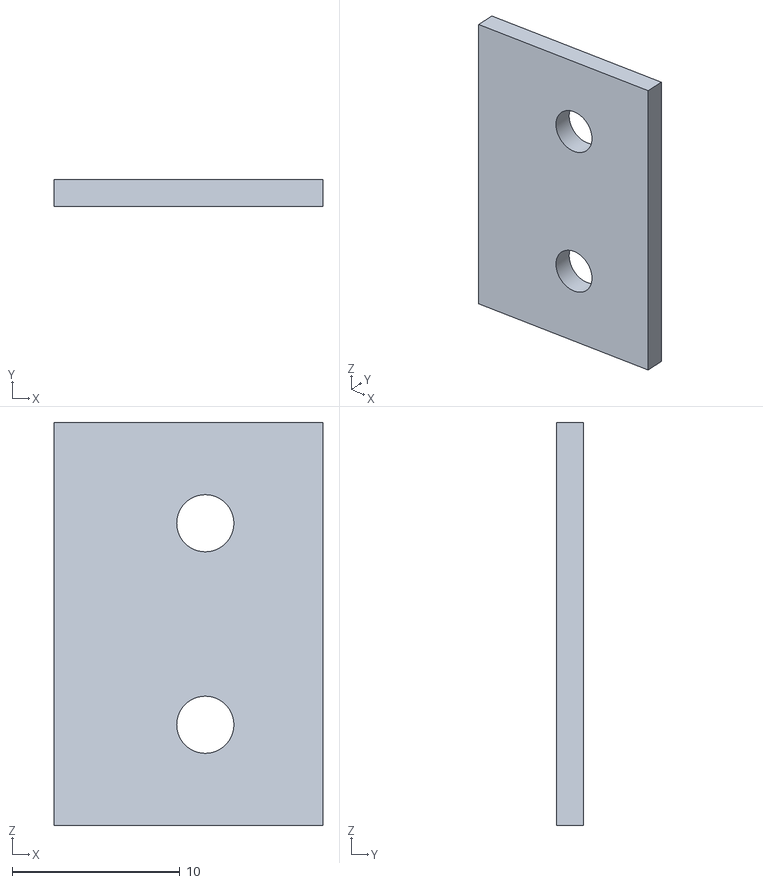
[picture p22: CAD file, 2026-10-24]
hardware/balance/cad/dut_card.stl
16.0 x 1.60 x 24.0
