arcticoder/spurious-force-balance/hardware/balance/cad/base.stl

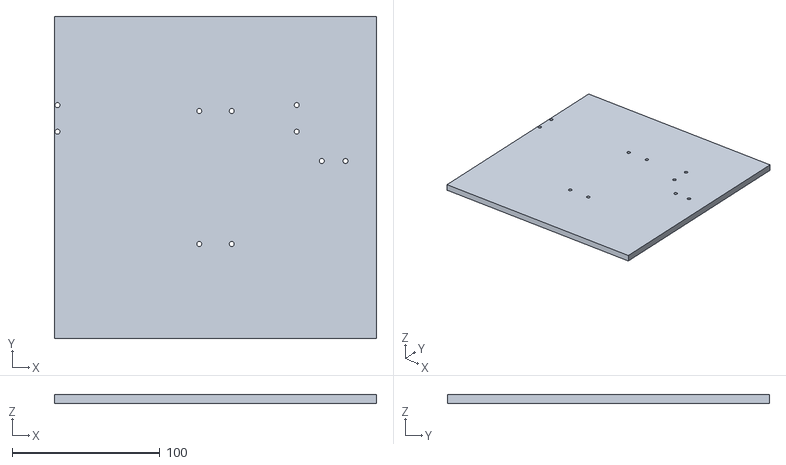
[picture p23: CAD file, 2026-10-24]
hardware/balance/cad/base.stl
218.0 x 218.0 x 6.00
