arcticoder/spurious-force-balance/hardware/balance/cad/clamp_up_a.stl

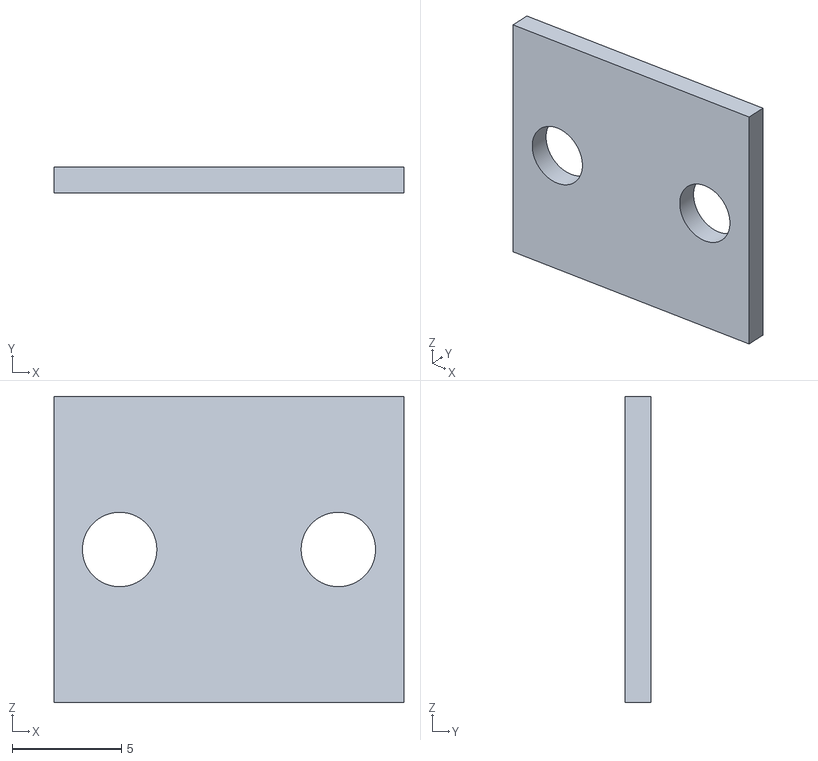
[picture p24: CAD file, 2026-10-24]
hardware/balance/cad/clamp_up_a.stl
16.0 x 1.20 x 14.0
