arcticoder/spurious-force-balance/hardware/balance/cad/hw_clamp_low.stl

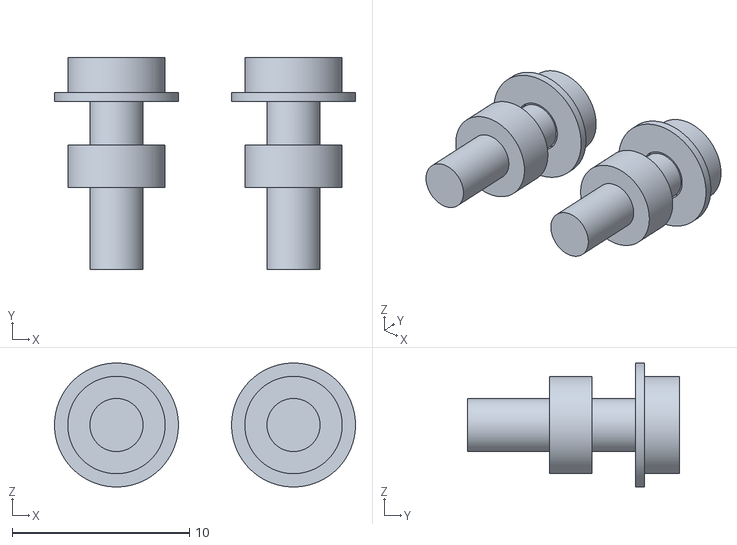
[picture p25: CAD file, 2026-10-24]
hardware/balance/cad/hw_clamp_low.stl
17.0 x 12.0 x 7.00
