arcticoder/spurious-force-balance/hardware/balance/cad/hw_holder.stl

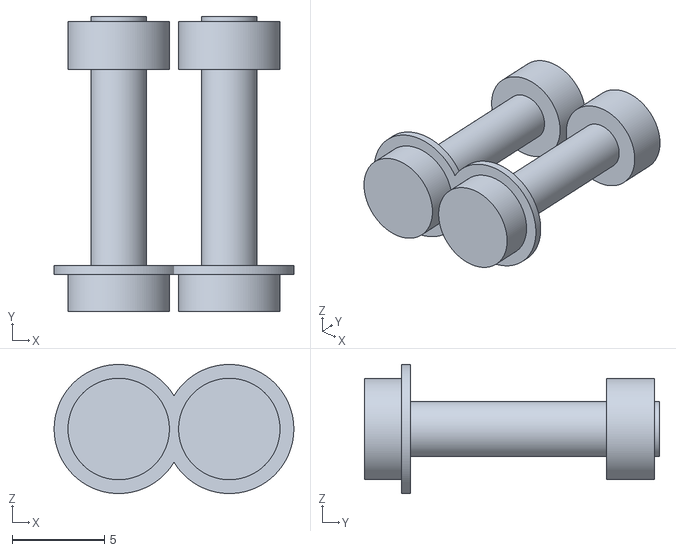
[picture p26: CAD file, 2026-10-24]
hardware/balance/cad/hw_holder.stl
13.0 x 16.0 x 7.00
