arcticoder/spurious-force-balance/hardware/balance/cad/vane_holder.stl

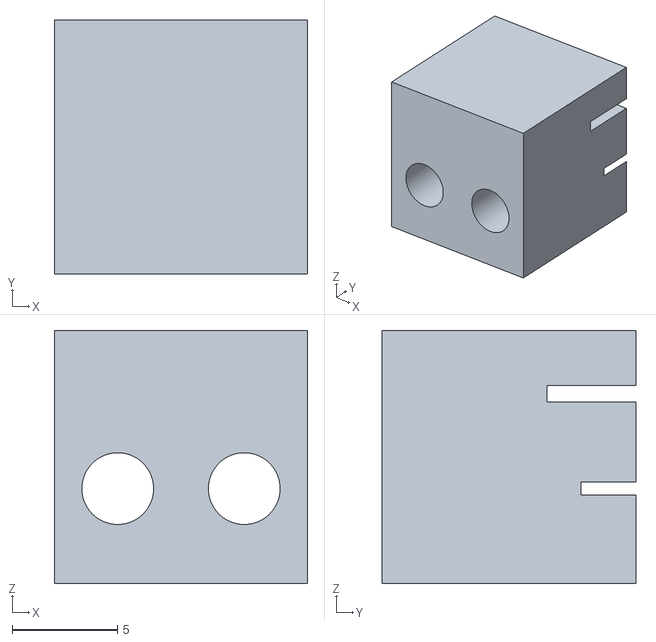
[picture p27: CAD file, 2026-10-24]
hardware/balance/cad/vane_holder.stl
12.0 x 12.0 x 12.0
