arcticoder/spurious-force-balance/hardware/balance/cad/damper_holder.stl

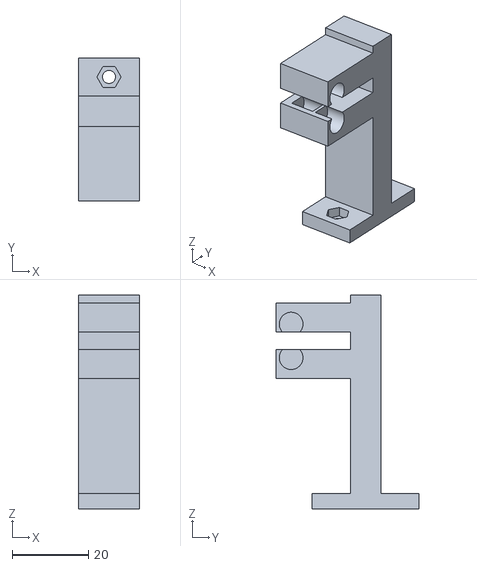
[picture p28: CAD file, 2026-10-24]
hardware/balance/cad/damper_holder.stl
16.0 x 37.5 x 56.0
