arcticoder/spurious-force-balance/hardware/balance/cad/fixture_gap_gauge.stl

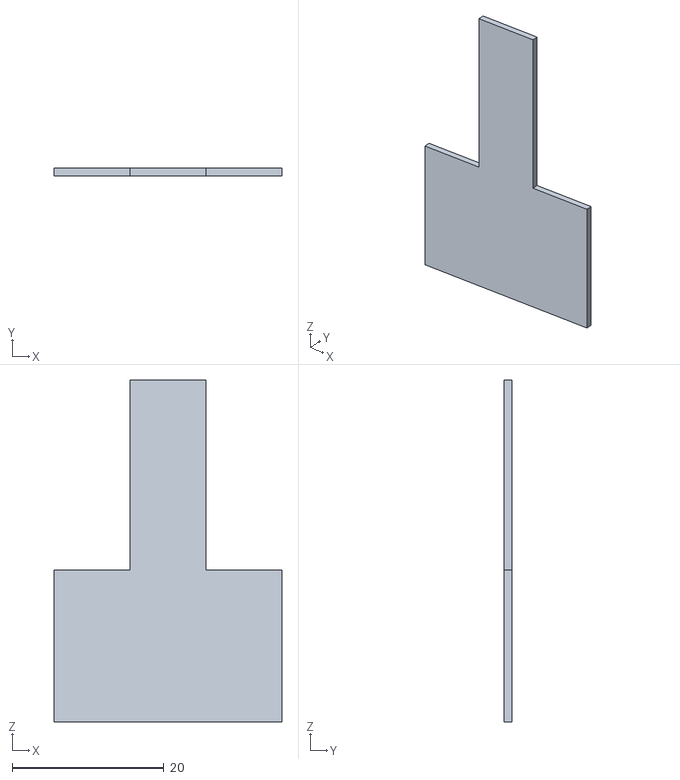
[picture p29: CAD file, 2026-10-24]
hardware/balance/cad/fixture_gap_gauge.stl
30.0 x 1.00 x 45.0
