arcticoder/spurious-force-balance/hardware/balance/cad/strip.stl

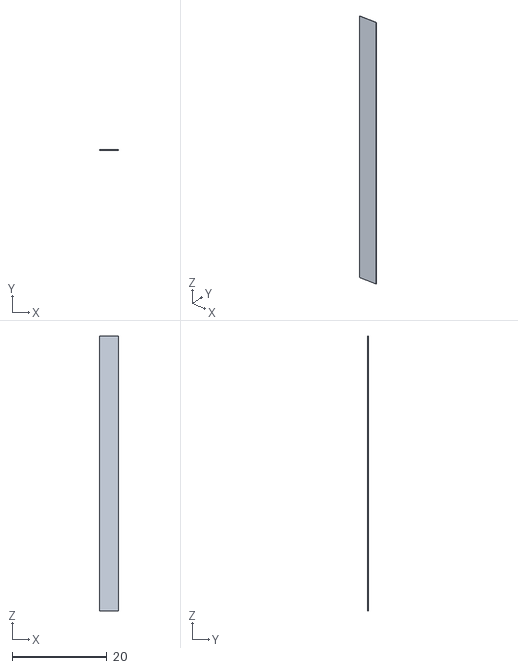
[picture p30: CAD file, 2026-10-24]
hardware/balance/cad/strip.stl
4.00 x 0.05 x 58.0
