arcticoder/spurious-force-balance/hardware/balance/cad/panel_nx.stl

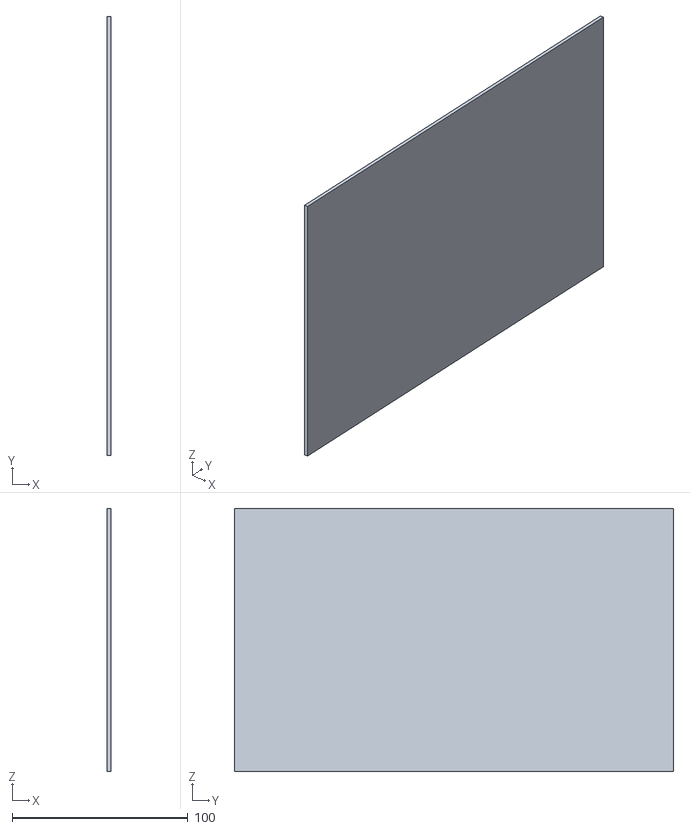
[picture p31: CAD file, 2026-10-24]
hardware/balance/cad/panel_nx.stl
2.00 x 250.0 x 150.0
