arcticoder/spurious-force-balance/hardware/balance/cad/encl_shelf_nx_1.stl

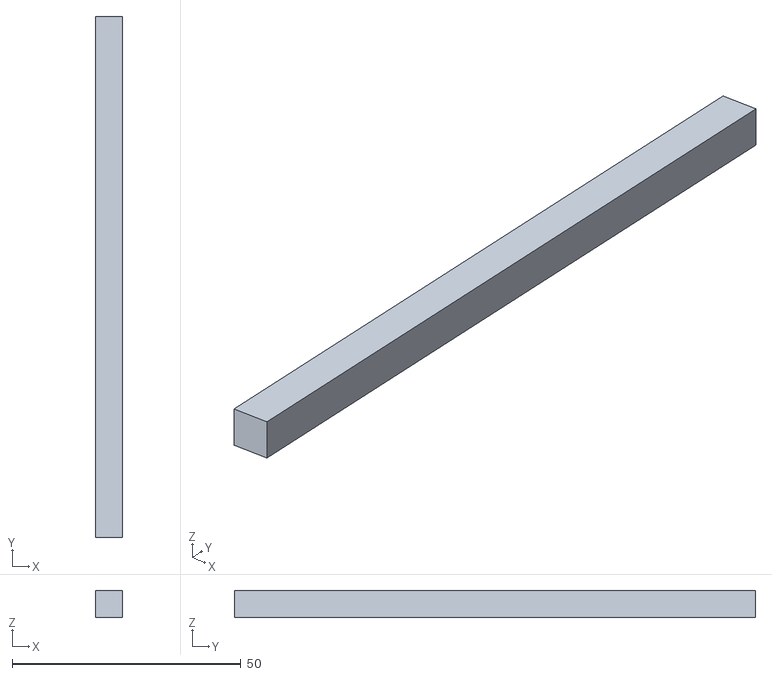
[picture p32: CAD file, 2026-10-24]
hardware/balance/cad/encl_shelf_nx_1.stl
6.00 x 114.0 x 6.00
