arcticoder/spurious-force-balance/hardware/balance/cad/vane.stl

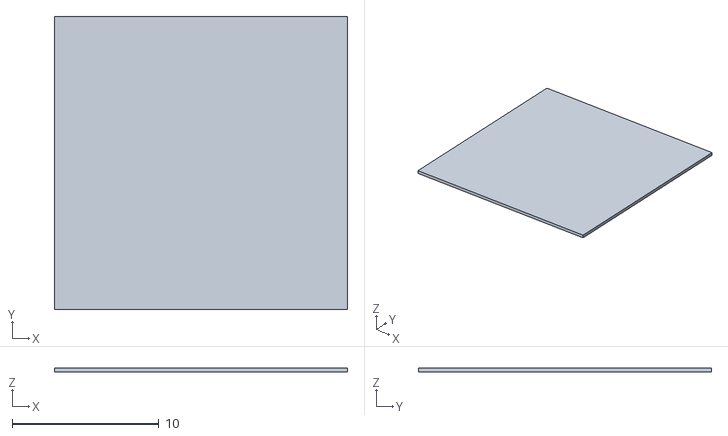
[picture p33: CAD file, 2026-10-24]
hardware/balance/cad/vane.stl
20.0 x 20.0 x 0.3
