arcticoder/spurious-force-balance/hardware/balance/cad/fixture_strip_guide.stl

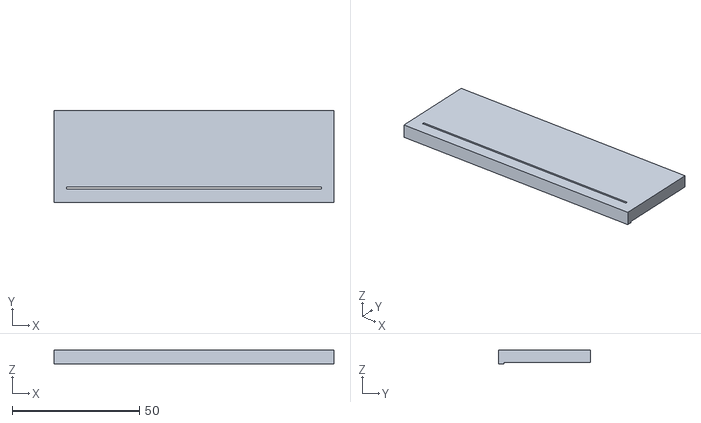
[picture p34: CAD file, 2026-10-24]
hardware/balance/cad/fixture_strip_guide.stl
110.0 x 36.0 x 5.50
