arcticoder/spurious-force-balance/(list of files, cad)

Other CAD files:
hardware/balance/cad/encl_print_wall_py_b.stl
hardware/balance/cad/encl_print_wall_py_a.stl
hardware/balance/cad/encl_print_wall_px_b.stl
hardware/balance/cad/encl_print_wall_px_a.stl
hardware/balance/cad/encl_print_wall_nx_b.stl
hardware/balance/cad/encl_print_wall_ny_a.stl
hardware/balance/cad/encl_print_wall_ny_mullion.stl
hardware/balance/cad/encl_print_lid_1_b.stl
hardware/balance/cad/encl_print_wall_py_mullion.stl
hardware/balance/cad/encl_print_wall_px_mullion.stl
hardware/balance/cad/encl_print_lid_0_a.stl
hardware/balance/cad/encl_print_lid_0_mullion.stl
hardware/balance/cad/encl_print_lid_1_a.stl
hardware/balance/cad/encl_post_nn_bar.stl
hardware/balance/cad/encl_post_np_bar.stl
hardware/balance/cad/encl_post_pp.stl
hardware/balance/cad/encl_post_np.stl
hardware/balance/cad/encl_post_pn_bar.stl
hardware/balance/cad/encl_post_nn.stl
hardware/balance/cad/magnet_up_0.stl
hardware/balance/cad/magnet_low_0.stl
hardware/balance/cad/clamp_low.stl
hardware/balance/cad/magnet_up_1.stl
hardware/balance/cad/encl_lid_a.stl
hardware/balance/cad/panel_px.stl
hardware/balance/cad/encl_shelf_px_1.stl
hardware/balance/cad/encl_shelf_nx_0.stl
hardware/balance/cad/panel_py.stl
hardware/balance/cad/balance.3mf
