arcticoder/spurious-force-balance/docs/kb/printing_state.md

# KB: printing state and staged orders (moved from TODO-agent.md 2026-11-10)

Audience: future LLM sessions. State as of 2026-11-10; update at each print session.

## Print hours and direct control

**Print hours rule (user, 2026-11-09):** the K1's touchscreen counter is the true total; Moonraker's `server/history/totals` (`total_print_time`) only counts jobs since Moonraker was installed (1.61 h before and 2.85 h after the 2026-11-09 evening print, which I read at both points). The user read 131 h on the touchscreen on 2026-08-06 and has printed more since, so the real total is above that and unknown: ask the user for the touchscreen figure (task on their list) and keep a running estimate as touchscreen figure plus Moonraker hours since. **When the total reaches 300 h, put a task on `TODO-arcticoder.md` to re-run the printer's equipment self-test** (touchscreen). Record each reading and date in `kb/session_handoff.md` and the wsl K1 note.
Direct control: the orcaslicer and 3d-printer MCP servers drive Orca and the K1 (connection notes in `~/Code/sysadmin/wsl/docs/kb`). The 3MF is a source for settings and per-part overrides, not required to print. State (2026-11-10): printed so far: plate 1 of 2026-11-08 (head, saw guide plate, elec_bracket, four shelves, vane_holder) and `balance_plate0_small` of 2026-11-09 (sensor_bracket, damper_holder, fixture_gap_gauge, fixture_saw_guide_base, 74 min, 31.7 g). **Pre-sliced G-code is ready in `~/.orcaslicer-mcp/gcode/` (all at the section-6 settings, 225/220 C, bed 60, 3 walls, 30%, tree supports, no prime tower, headers checked):** `balance_p0_post_nn.gcode` (post nn, 1 h 13 min, 37.2 g), `balance_p4_strip_guide.gcode` (35 min, 14 g), `balance_p1_posts_np_pn_pp.gcode` (three posts, 3 h 34 min, 110 g), `balance_p3_gantry.gcode` (3 h 16 min, 70 g), `balance_p2_base.gcode` (4 h 41 min, 177 g). The gantry and base times differ from the older figures (3 h 58 min and 3 h 25 min); the older slices may have used other per-object settings, so re-check the base against the 177 g before trusting the mass, and look at both in the preview before printing. The Orca project is in the MCP fork's memory (five plates), not saved to disk. Plan: the user prints the gantry on the morning of Wed 2026-11-11 (4 h window, printer plugged in and switched on by them; Tuesday's window was dropped because of rain). The gantry slice is 3 h 16 min, 70 g (older figure 3 h 58 min): look at it in the preview and check the header before submitting, and tell the user which spool to load. Start-up heating and levelling take about 12 min on top. The base (4 h 41 min) does not fit a 4 h window. Filament: the opened black spool had about 65-90 g before the last print used 32 g; one post needs 37 g, so a post may need a spool swap (pause, swap, resume) and the other jobs (70-177 g) need the unopened spool. Procedure for every session: `~/Code/sysadmin/wsl/docs/print-session-runbook.md`. Heater and print start need the user's explicit request each time. Bed mesh: the tilt is front to back, almost none left to right, so Z-belt tooth skipping does not apply; the direction: front is the low end by about 1.4 mm (convention checked 2026-11-11 against Klipper's source; see the wsl K1 note); `START_PRINT` levels every print. K1 notes: `~/Code/sysadmin/wsl/docs/kb/apps/k1-moonraker.md`.

## Print-session routine

Runbook: `~/Code/sysadmin/wsl/docs/print-session-runbook.md`; follow it at the start of each session, update it when a step is learnt. Name it in the user's task for every printing session (done for 2026-11-11). The slices are made before the session and each G-code's header, mass and preview are checked before submitting. After a session re-slice nothing unless a part changed; a reprinted part is sliced that day and saved under a dated name.

## Staged orders (one order per day; promote to `TODO-arcticoder.md` only when the order before it is placed)

2026-11-09: the AliExpress balance list was promoted to the user's list (nothing else was in transit and the calipers need a button cell); when the user sends the links and prices, log the order in `lab/docs/orders.md` (listings, variants, prices, bag), add the cells to the inventory on arrival, then give the head-hole measurement steps once the calipers have a cell. The sensor-head panel (about 13 parts; New User SMT coupon C$13.93 ends 2026-11-25) with a 4-pin JST-SH cable stays optional; `clamp_plate` stays in `TODO-BLOCKED.md` (revisit condition there). Keep a JLC or AliExpress parcel in transit at all times: when the AliExpress order is placed, the next gap is the JLC side (after the arm, elec_board and clamp_ground land, nothing is in production at JLC until the main board or the small-designs order).

## Session log 2026-11-11 (gantry day)
- Window: printer free about 7:07-14:00; the user wants the last print off the plate at 13:45 and the next file ready at each handover. Plan: gantry (started about 7:22, finish about 10:40), then `balance_p0_post_nn` (1 h 13 min, 37.2 g, about 1 h 25 min with start-up), then `balance_p4_strip_guide` (36 min, 14 g, about 48 min); the user clears the plate and says go before each; headers of both files were checked. Three posts (3 h 34 min) and the base (4 h 41 min) do not fit.
- Filament: the black spool opened recently (formerly the sealed one, about 1 kg) is loaded; the other black spool is nearly empty. Both black spools were opened before today (inventory corrected).
- Load sequence that worked: `G28` (cold; the printer was unhomed so `G1` is refused until homed), `G90`, `G1 Z120 F600`, `G1 X10 Y210 F6000`, `M104 S225`, the user seats the filament and locks the feeder, then `M83` + `G1 E40 F150` + `G1 E40 F200` pushed the strand (it fell onto the plate corner; the user removed it). Start: upload with curl `-F print=true`, `print_stats.state` confirms.
- Observation limits: the printer is on the balcony with the door shut (fumes), the user is in the office, there is no camera (Moonraker lists no webcam, ports 8080/4408 closed), and the user cannot hear the extruder. Name every visual check with a clock time and what to look for; first layer was checked by the user at about 7:30 (stuck, no globs), a mid-print look at 9:15 (flat, no stringing). The data I can watch is state, temperatures, filament sensor, progress.
- G-code progress is by file position, not time (54.7 % at 85 min, 69 % at 115 min of a 196-minute job): do not read it as a clock.
- Wi-Fi drops (K1 off the network, print continues): 7:19-7:21, 7:24-7:27, 7:43 on, then seven short flaps 7:44-7:50 (6 s to 3 min each), none from 7:50 to 8:52, one of 13 s at 8:52, then stable. Log of timestamps: scratchpad `k1_wifi_drops.txt` (not kept); the user reset the Wi-Fi on the touchscreen at about 7:28.
- Monitor design that worked: a 15 s poll of `print_stats`, `heater_bed`, `extruder` that prints on state change and once if the printer is offline for 10 min; Monitor expires every 30 min and must be re-armed; its first line after each re-arm is just the current state.
- Gantry result 2026-11-11: finished about 10:43, 201.6 min (estimate 196), 23.6 m of filament, heaters off by the printer, no errors; the user pulled it at bed ~40 C and found it good (no gaps or thin layers). Moonraker `total_print_time` 6.21 h over 3 jobs afterwards (2.85 h before). Post nn started 10:46 on the user's go (plate clear), expected end about 12:10; strip guide next.
- Post nn: 10:46-12:03, 71.3 min, 12.5 m filament, no errors, user's inspection fine. Strip guide: started 12:07:46, finished about 12:42, 34.4 min, 4.7 m (about 14 g). Moonraker `total_print_time` 7.97 h over 5 jobs after it. Last print of 2026-11-11; nothing else fits a window under an hour (the three posts are 73 min each, the base 4 h 41 min).
- Fast start (user asked for no repeated homing/levelling, 12:06): the K1 `START_PRINT` macro skips rough G28, nozzle clear, accurate G28 and `CX_PRINT_LEVELING_CALIBRATION` when `PRINT_PREPARED` has set its `prepare` variable to 1 (it still draws the purge line and does not heat: wait for temperatures yourself). Sequence used: `M140 S60`, `M104 S225`, `G28` (the printer is unhomed after the idle timeout), check `bed_mesh` still shows profile `default`, `M190 S60`, `M109 S225`, `PRINT_PREPARED`, then curl upload with `print=true`. Saved about 8-10 min; the first layer held (user looked). Use only when the mesh is recent and the nozzle is clean.
- Printer model (from the Mainsail/Fluidd page, 2026-11-11): K1-FA35 at 192.168.1.70.
- Post geometry (2026-11-11, user found it printing post nn): each `encl_post_*` is two disjoint solids, the 20 x 20 L-shaped post and an 8.6 x 8.6 x 150 mm inner corner bar, left by the two wall slots. Grouped in one object, the bar lay above the bed and got supports. `balance.py` now emits the bar as its own part (`encl_post_xx_bar`, four new STLs); slice each part as its own object laid flat, no supports. Post nn was printed grouped (L plus bar, with supports for the bar) and the user's photo of 2026-11-12 shows the bar printed, so post nn is complete. Re-sliced 2026-11-11 evening (OrcaSlicer reopened by the user; the reopened project had lost the temperature edits, so 225/220 and bed 60 were set again): `balance_p1_posts_np_pn_pp_bars.gcode` = posts np, pn, pp (each laid on its 20 mm outer face; np needed a different rotation about the long axis than pn/pp) and their three bars, all flat, no supports, 2 h 4 min, 104 g, header checked (225/220, bed 60, 3 walls, 30%). The old grouped file was deleted. Reopening the Orca project drops unsaved config edits: check temperatures in `get_config` before every slice.
- Camera (searched 2026-11-11): the K1 family's stock stack serves one USB UVC camera through Creality's service; whether a cheap generic UVC camera is picked up on current stock firmware is unconfirmed and needs a test on this unit (firmware updates have broken the camera stream for others; a second camera is not supported). Not purchased; the user leans to continued manual checks.
- Remaining to print: the posts file above (`encl_post_np/pn/pp` + three bars, 2 h 4 min, 104 g) and `base` (4 h 41 min, 177 g), plus the not yet designed calibration rider and hacksaw frame.

- Printed-parts inventory (photo `img/printed_parts_2026-11-11.jxl`, parsed 2026-11-12 against the CAD sizes at 67 px/cm; the three long bars at the left are read as post nn's L and its bar): head, sensor_bracket, damper_holder (screws left in), elec_bracket, vane_holder, fixture_saw_guide_base, fixture_saw_guide_plate (it prints as four separate pieces: the rod groove and kerf slot split it, four small blocks each with one hole), fixture_gap_gauge, fixture_strip_guide, four `encl_shelf_*` strips, gantry, post nn with its bar: 15 of the 15 expected objects, nothing to reprint. Still to print: posts np, pn, pp, three bars, base.

- Files for the remaining parts (2026-11-11 evening, all at 225/220 C, bed 60, 3 walls, 30%, no supports, headers checked): `balance_p1a_post_np_bars_np_pn.gcode` (post np, np bar, pn bar; 54 min, 43 g; planned for the Thursday 2026-11-12 window of 75 min from 7:45 pm: about 60 min with start-up), `balance_p1b_posts_pn_pp_bar_pp.gcode` (posts pn and pp, pp bar; 73 min, 61 g; needs a window of about 85 min), `balance_p5_cal_riders_x2.gcode` (two calibration riders printed platform-down; 13 min, 3 g), `balance_p2_base.gcode` (4 h 41 min, 177 g). Per-object times from slicing: post with its bar 43 min; each extra bar about 11 min.
- Rider design: `fixture_cal_rider` in `fixtures.py` (clip over the arm board's top edge, 1.4 mm slot with crush ribs, 10 mm weight seat, usable radii 20-80 mm; the weight's real diameter is unknown until it arrives: `CAL_WEIGHT_D`).
- 2026-11-12 (early): OrcaSlicer crashed when `delete_object` was called on an object with two instances (the duplicated rider); the in-memory project and its "balance" print preset (which lived only in the project, from `cad/balance.3mf`) were lost. Relaunched with `flatpak run com.orcaslicer.OrcaSlicer`; Remote API came up on 13130 without a preference change. The saved G-code files are unaffected. Before deleting a duplicated object, delete its extra instances one by one, or move it off the plate instead. To get the old per-object settings back, open `cad/balance.3mf` (the project, not load_model).
- Enclosure plate estimates (2026-11-12, one 124 x 150 tile, standard K1 0.20 mm preset, flow capped at 12 mm3/s, 225/220 C, bed 60): 2 mm thick, 3 walls 30 %: 63 min 32 g; 2 mm solid (2 walls, 5/5 shells): 59 min 36 g; 2 mm, 2 walls, 15 %, 3/3 shells: 57 min 28 g (sparse infill in a 2 mm plate needs internal bridges, so lower infill saves almost nothing); 1.2 mm, 3/3 shells: 39 min 21.5 g. The first layer alone is about 11 min (bottom surface at 5 mm3/s). Whole enclosure = about 11.2 tile-equivalents of plate plus six strips.
- 2026-11-12 18:40 prep for the evening window (runbook A and read-only B): Moonraker reachable (the K1 answered while cold: standby, bed 21 C, nozzle 22 C, targets 0, unhomed, `bed_mesh` profile default, filament sensor detects filament, totals 5 jobs 7.97 h 63.6 m), Orca fork 2.4.2 (user flatpak) answering on 13130 with `balance.3mf` open (not used; the saved G-code is sent with curl), `balance_p1a` header checked (225/220 C, bed 60, 3 walls, 30 %, no supports, no prime tower, three objects: np, np bar, pn bar, 43.29 g, 54 min). Window moved to start at 8:15 pm (user): 75 min covers the 54-min print plus start-up. Spool: the black 1 kg one stays loaded.
- 2026-11-12 evening, FAST START FAILURE (important): after a power-on, the fast start (`G28`, `PRINT_PREPARED`, upload) crashes Klipper into Shutdown: `START_PRINT` runs `CX_PRINT_DRAW_ONE_LINE`, which does `M104 S%d` of `self.extruder_temp` in `custom_macro.py`; that value is only set by `CX_ROUGH_G28 EXTRUDER_TEMP=...`, which the prepared path skips, so it is None until one full `START_PRINT` has run since Klipper started (yesterday it worked because earlier prints had run in the same boot). Error shown: `Internal error on command:CX_PRINT_DRAW_ONE_LINE`, `TypeError: %d format ... NoneType` in klippy.log, print_stats `paused`. Recovery: `POST /printer/firmware_restart` (ready in about 20 s, heaters off, unhomed). Rule: after any power-on or firmware restart, the first print uses the normal start (just upload with `print=true`, no `PRINT_PREPARED`; start-up about 8-10 min incl. rough G28 at about 135 C, nozzle clear, accurate G28, mesh); fast start only for the second and later prints of the same boot. Also: `G28` cools the nozzle to about 140 C, so a hand purge must come after `M109`; extrusion below the minimum temperature is refused (empty reply from the script call).
- The pre-sliced G-code from 2026-11-11 evening has `START_PRINT ... BED_TEMP=55` and `M140 S55` although the header says `hot_plate_temp_initial_layer = 60` (the key `bed_temperature_initial_layer_single` was not changed by `set_config` of `hot_plate_temp*`): the first layers of p1a ran at 55 C. When re-slicing the others, check the START_PRINT line, not the header.
- Evening print of 2026-11-12: `balance_p1a` started 19:42:30 on the normal start after the restart (first attempt 19:40 crashed at the purge-line macro).
- 2026-11-12 first-layer look (user, about 19:53): bed looks good, layers laying down. p1a first layers ran at bed 55 C.
- 2026-11-12 20:05: the user offered a second print (under an hour). New file `balance_p6_post_pn_bar_pp_riders_x2.gcode`: post pn (L, flat on its 20 mm face), pp bar, two calibration riders (platform-down): 50 min 37 s, 37.8 g, no supports, START_PRINT BED_TEMP=60. Post pp's L (about 32 min, about 25 g) is still to print, then the base (4 h 41 min). `balance_p1b` is superseded (pn + pp + pp bar, 73 min) and `balance_p5` (riders alone) is covered by p6. Bed temperature for the K1's START_PRINT comes from the textured-plate keys: set `textured_plate_temp` and `textured_plate_temp_initial_layer` (60) as well as `hot_plate_temp*` before slicing (the project's reopened defaults were 220/220 nozzle and 55 bed). The slicer warns about the bed being at the filament's softening temperature at 60 C; earlier prints at 60 C were fine.
- 2026-11-12 mid-print look (user, about 20:15): print looking good.
- 2026-11-12 20:38 p1a finished (print started about 19:51 after the 8-10 min normal start, ran about 47 min; state complete, no errors). User's mid-print look good.
- 2026-11-12 p6 started 20:49 on the fast start (worked: a full START_PRINT had run since the restart); first-layer look (user, about 20:55): good.
- 2026-11-12 p6 mid-print look (user, about 21:15): plate looks good.
- 2026-11-12 21:37 p6 finished (state complete, no errors; started 20:49 on the fast start). Printed now: posts nn, np, pn, their bars np/pn/nn and the pp bar, two calibration riders (to be inspected by the user). Left to print: post pp (L, about 32 min, about 25 g) and the base (4 h 41 min); then the enclosure (kb/balance_design_notes.md). `balance_p1b` and `balance_p5` are superseded; the pp L needs a new file (slice it the day before its window).
- 2026-11-13 00:00 summary of the 2026-11-12 sessions: p1a (np, np bar, pn bar) and p6 (pn, pp bar, two riders) printed and monitored with no defects seen by the user; fast start works only after one full start since the last Klipper boot; Orca project values after a reopen (nozzle 220/220, bed 55) must be reset (`nozzle_temperature_initial_layer` 225, `hot_plate_temp*` and `textured_plate_temp*` 60) and the START_PRINT line checked. Remaining prints: post pp L (new file needed; load `encl_post_pp.stl`, rotate [90,0,0] then [0,90,0], z -65, check `describe_plate` says flat), base (`balance_p2_base.gcode`, 4 h 41 min, 177 g, check its START_PRINT bed temperature), enclosure plates. Orca object ids change after every reopen: use `list_objects` (large output; prefer `load_model` then `list_plates`).
- 2026-11-13 (chat 14): the user reports the 2026-11-12 prints look good (no defects); nothing printed or heated this chat. Saturday 2026-11-14 07:30-10:00 is RESERVED for printing (first misread as blocked); pp L is sliced for it (entry below). The printer was not contacted this chat.
- 2026-11-13 evening (Sonnet, user asked for slicing only on Sonnet): OrcaSlicer 2.5.0 (flatpak `com.orcaslicer.OrcaSlicer`, started by the agent with `nohup flatpak run ...`, API on 13130 in about 10 s; GPU/MESA warnings in its log are harmless). Earlier the MCP timed out because a second Orca held the port; 13131 answers 401 (token needed). A fresh Untitled project has stock settings, NOT the earlier ones: 220/220 C, bed 55, 2 walls, 15 %, prime tower on, speeds up to 300 mm/s, which `check_profile_physics` blocks (flow 24 mm3/s). Settings used for the pp L slice (physics check ok): nozzle 225/220, `hot_plate_temp*` and `textured_plate_temp*` 60, `wall_loops` 3, infill 30 %, prime tower off, `filament_max_volumetric_speed` 12, outer wall 100, inner wall/sparse/solid infill 120, top 100, gap 100 mm/s. `open_project cad/balance.3mf` is refused (blocked_by_remote_api_policy: the project brings its own machine_start_gcode etc.; the user must open it in the window or allow script edits in Preferences > Remote API); do not change that preference. Rotation [90,0,0] then [0,90,0] on `encl_post_pp.stl` lands it on the bed already (z offset 10, no extra translate); `describe_plate`: flat, no overhang, no support, bbox y 35-185. Result `balance_p7_post_pp_L_20261113.gcode` (in `~/.orcaslicer-mcp/gcode/`): 47 min 33 s, 26.3 g, 100 layers, `START_PRINT EXTRUDER_TEMP=225 BED_TEMP=60`; the softening-temperature warning at bed 60 is the known one. The slower speeds make it longer than the old 32 min estimate; the older 2026-11-11 files were sliced at faster per-object settings, so check the base file's speeds before use.
- 2026-11-13 evening, second file for Saturday's window: `balance_p8_wall_strips_x4_20261113.gcode` (`encl_print_wall_{nx,ny,px,py}_mullion.stl`, each rotated [90,0,0] and arranged; 65 min 36 s, 29.1 g, same settings as p7, bed 60). Not optimised: the H-profile strips show 371 s of bridge time, nx/px have 71 % first-layer contact (two islands), ny/py 931 mm of overhang perimeter in the first 10 mm, no supports; a better rotation about the long axis could be tried later. The 12 min per strip estimate in `balance_design_notes.md` was too low (about 16 min each at these speeds). The wall plates (grey) and lid strips are not sliced yet.
- 2026-11-13 night: printed pad-saw handle designed (`fixtures.hacksaw_handle`, smoke checks pass): blade 150 x 6 x 0.4 mm clamped by friction plus an end stop under a 6 mm cover with four M3 x 14 screws (self-tapped pilots), groove 6.3 x 0.30 mm (shallower than the blade so the cover crushes it 0.1 mm), no frame because PLA creeps under bow tension. Sliced later the same night on Sonnet: `balance_p9_hacksaw_handle_20261113.gcode` (body + cover on one plate, both flat, no overhang, no supports, 72 min 23 s, 39.5 g, bed 60) for the Sunday 2026-11-15 window. Print check: first test whether the blade holds under hand pressure before sawing brass.
- 2026-11-14 06:50 prep for the 07:30-10:00 window (runbook A, steps 2-5): `balance_p7` (pp L, 47 min 33 s, 26.3 g) and `balance_p8` (four wall strips, 65 min 36 s, 29.1 g) headers verified (225/220 C, bed 60 in START_PRINT, 3 walls, 30 %, no supports, no prime tower, EXCLUDE_OBJECT lists the right parts). Plan: p7 on the normal start (about 10 min start-up, ends about 08:30 from a 07:30 start), p8 on the fast start straight after (about 68 min, ends about 09:40, 20 min inside the window). Spool: the opened 1 kg black cardboard spool (sealed gross 1228 g on 2026-11-05; used since: gantry 70 g, post nn 37 g, strip guide 14 g, p1a 43 g, p6 38 g, about 200 g in all, so about 790 g left) should still be loaded since 2026-11-11; the other black spool (65-90 g left) is NOT used. Orca (user flatpak 2.5.0, relaunched 2026-11-13) answers on 13130; Moonraker was silent at 06:49 (printer off).
