arcticoder/spurious-force-balance/docs/kb/easyeda_validation.md

> SHELVED 2026-11-01 with the EasyEDA route (see `easyeda_spark_notes.md`); the milestone routine no longer applies.

# EasyEDA offline validation layer (2026-11-01)

Purpose: a second, tool-independent check of the EasyEDA project, runnable by any LLM or CI job without MCP access to EasyEDA. The user's rule: run it at every milestone, i.e. before telling them to commit `hardware/easyeda/spurious-force-balance.eprj2`, and report the result in `TODO-arcticoder.md`.

## What runs
- `python3 tools/validate_easyeda.py [project.epro2] [--json report.json] [--strict] [-v] [--board NAME]` (standard library only). Default input: the newest `.epro2` in `hardware/easyeda/exports/`, else the newest `hardware/easyeda/*_backup/*.epro2` (EasyEDA writes those itself; the folder is gitignored).
- It reads the `.epru` inside the `.epro2` (a zip): one JSON record per line (`header||payload|`), documents DEVICE (LCSC number `Supplier Part`, library prefix `Designator: "C?"`, `Value`), FOOTPRINT (pad numbers), PCB (COMPONENT, ATTR Designator/Device/Footprint, PAD_NET pad to net, NET, VIA, POLY...). The netlist is the PCB's pad-to-net table, so it is only as current as the last "Import Changes from Schematic".
- Checks: NAME-* (designators and net names), CONN-* (pads without a net unless the board's SKiDL netlist `hardware/instrument/schematic/out/<board>.net` leaves them open on purpose; single-pad nets), PULL-* (I2C pull-ups on boards with the RP2040 master; reset/enable/run/boot/CS nets need a driver or bias; USB-C CC 5.1 k to ground), FLOAT-* (input pins by electrical type from `hardware/instrument/lib/jlc.kicad_sym`: unconnected, or on a net with no driver or bias), SKIDL-* (every net's (LCSC, pin) multiset and part counts against `<board>.net`), BOM-* (assembled parts without LCSC number; the ADC crystal stand-in C9002/C9900177807 for C21900468), NATIVE-* (EasyEDA's own ERC/DRC, see below).
- Exit code 1 on any ERROR; `--strict` also on WARN.

## ERC and DRC are EasyEDA-native and cannot run offline
An agent with MCP access records them in `hardware/easyeda/exports/native_checks.json` at each milestone (`wip:true` downgrades a still-unrouted board to WARN): PCB: `PCB_Drc.check(true,false,true)` through `easyeda_api_call` with that PCB focused (`DMT_EditorControl.openDocument(pcbUuid)` first); an empty result list is clean; schematic: `easyeda_erc_run` (scope focused) and `easyeda_schematic_validate_netlist`. Record counts, the date, and the project save time. The validator only reads this file; it warns when a board has no entry.

## Getting the data: live netlists (works) versus `.epro2` export (user-supplied, optional)
`easyeda_export_netlist`, `easyeda_bom_export` and `easyeda_pcb_export_route_context` answer "Bridge did not return data" (the API returns a `File` object), and Ctrl+S in EasyEDA writes no new `*_backup/*.epro2` (checked 2026-10-31: still the 2026-10-30 files). **What works (2026-10-31): `easyeda_api_call` path `PCB_Net.getNetlist`, args `["JLCEDA"]`, `confirmWrite:true`, returns the netlist as TEXT**: a list with one JSON string per PCB (order seen: main_board first, then the four mechanical boards, then sensor_head_1, sensor_head_2; identify by designators). Each string has `components{id:{props{Designator,Supplier Part,Value,FootprintName,...},pinInfoMap{pad:{net}}}}`. The reply is about 400 KB, so the harness saves it to a file: load that file with `python3 -I`, `json.load`, then `json.loads(result[i])` and write the boards that have components to `hardware/easyeda/exports/netlists/<board>.json`. Run `python3 tools/validate_easyeda.py --netlists hardware/easyeda/exports/netlists -v`. It reflects the PCB's last Import Changes, exactly what the board will be built from. Live netlists have no library prefix, so NAME-4 is skipped. The `.epro2` path (`tools/validate_easyeda.py file.epro2`) still works for a whole-project snapshot, but nothing needs the user to produce one.

## Milestone routine (agent)
1. Save the project, run ERC/DRC per board through MCP and update `native_checks.json`.
2. Pull the live netlists (above) for main_board and the heads.
3. `python3 tools/validate_easyeda.py --netlists hardware/easyeda/exports/netlists -v --json hardware/easyeda/exports/validation_report.json`; fix ERRORs or explain them; record the result line in `TODO-arcticoder.md` next to the commit request.

## Known state
- DRC with per-error detail: `api_call PCB_Drc.checkJson [true,false,true]` (patched install, see `easyeda_spark_notes.md`) returns every error with primitive ids and positions as a JSON string; `PCB_Drc.check` returns only counts (nested objects become `[MaxDepth]`). Use checkJson for `native_checks.json` counts and for fixing errors.
- `native_checks.json` still shows main_board as `wip` with the old unrouted counts (520 DRC); refresh it when the board is routed (DRC through `easyeda_drc_run`, which returns 60 KB: save to file and count with python; native PCB_Drc.check also works).
- 2026-10-31 first main-board run (live netlist): found the stale import (TLV9062 pads 5-7 of U14/U15 without nets, 4 SKIDL-2 and 1 SKIDL-1 errors, caused by the PCB being imported before the unit-B designators were renamed); the first Alt+I re-import said "no changes" (the importer does not notice missing unit-B pad nets), so (cause: second units had AddIntoPcb false, see easyeda_spark_notes.md; fixed 2026-11-01, validator 0 errors) U14 and U15 were deleted from the PCB with `easyeda_pcb_delete_component` (`primitiveIds` array) and a second Alt+I must re-add them. Confirm with `PCB_Net.getAllPrimitivesByNet(["LED2_G"])` (should list Q2 pad 1 and U14 pad 7); that call is also how to find a part's primitive id from a net. A crystal pin now counts as a driver (FLOAT-2 on the ADC XTAL1 net was a false positive). Heads: clean.
- Tested on the 2026-10-30 backup (arm, clamp_plate, clamp_ground, elec_board, sensor_head_1, sensor_head_2): 0 errors. The main board is not in that export yet; its first run is pending the user's export (expect: many NATIVE-3 WARN while unrouted, BOM-2 for the crystal, and whatever the netlist cross-check finds).
- EasyEDA numbers designators itself (RP2040 = U4), so the SKiDL cross-check matches on (LCSC, pin) per net name, not on designators.
