arcticoder/spurious-force-balance/docs/TODO-completed.md

# TODO — completed

Dated entries, newest first.

- 2026-11-13 (night) — Printed pad-saw handle for the 150 x 6 x 0.4 mm blades designed in `fixtures.py` (my own design; smoke test passes); user approved it (Printables link not used); sliced on Sonnet as `balance_p9_hacksaw_handle_20261113.gcode` (72 min, 39.5 g) for the Sunday window.

- 2026-11-13 (evening) — Post pp L sliced on Sonnet after OrcaSlicer was relaunched: `balance_p7_post_pp_L_20261113.gcode`, 47 min 33 s, 26.3 g, flat, no supports, bed 60 (`kb/printing_state.md`). Nothing sent to the printer. Second file for the same window: four wall strips (`balance_p8_wall_strips_x4_20261113.gcode`, 65.6 min, 29.1 g).

- 2026-11-13 (later) — Chat 14 (cont.): safety glasses added to the AliExpress cart by the user (C$3.48, not yet placed). Print windows set by the user: Sunday 2026-11-15 16:30-18:30 (post pp L), Saturday 2026-11-21 07:30-12:30 (base). The user asked for any slicing before tomorrow morning; the OrcaSlicer MCP timed out (`get_status`, 30 s), so nothing was sliced; slicing is in `TODO-BLOCKED.md`.

- 2026-11-13 — Chat 14: the user reports the 2026-11-12 prints look good (inspection task closed). Ballast decided: the 10 mm brass rod, one hacksaw cut in the printed saw guide; the abrasive-wheel route and its Dremel chop stand are shelved, and the stainless 10 g weight is not pursued. Dust masks dropped from the AliExpress list; safety glasses stay (now `TODO-arcticoder.md`, task 1). Saturday 2026-11-14 07:30-10:00 was first recorded as blocked, a misreading: it is reserved for printing (corrected in the evening). The JLC order states were not re-read this chat (the app's orders route bounced to the events page; retry is in `TODO-BLOCKED.md`). `docs/history.md` was searched for sensitive strings: the user checked the printer-password concern and found nothing (the agent's check had overclaimed), and the partial tracking numbers are already redacted by the user; nothing was edited there. Glasses need no Z87.1/EN 166 mark and no mask is required for a hand hacksaw cut (user's questions answered).

- 2026-11-12 (evening) — With the K1 on: print hours (no total counter on the printer; the 50-job history file is a partial record, touchscreen stays the source), Wi-Fi (-62 dBm, no dropout evidence in the logs), START_PRINT (never hot over the plate centre) checked and recorded in the wsl K1 note; first print of the balance frame (p1a) printed, fast-start failure after power-on found and documented, second file p6 sliced.

- 2026-11-12 (late night) — Main board layout finished to the DFM gate: 415/415 connections routed, no blocking item (`mainboard.py dfm`), In1 GND plane only (In2 pour dropped after three failed variants), USB-C custom-pad bug in the DSN found and fixed, 3V3 rails back to 0.2 mm, fan-out keep-outs around the fine-pitch ICs; render reviewed (`img/main_board_render_top.jxl`); WP7 outputs generated in `hardware/instrument/fab/` (Gerbers with the plane filled, BOM 46 lines/164 parts, CPL, `ORDER.md`). Details and the run history: `kb/main_board_layout_notes.md`.

- 2026-11-12 (night) — Main board method change: pcbnew segfault solved (wrong interpreter: pcbnew is built for system Python 3.14, the venv is 3.12; `kb/pcb_toolchain_notes.md`), `layout/SPEC.md` written, force-directed placement replaced by block regions (`BLOCK_REGIONS`, `assign_blocks`; HPWL without GND 6189 -> 4417 mm, 0 overlaps), power net classes (0.4/0.25 mm), In2 allowed for signals with a 3V3_D pour, mounting holes placed before routing, floorplan image `img/main_board_floorplan.jxl`. Pre-routing critical nets in code was not needed: placement keeps the USB pair, crystals and boost loop inside their blocks and the classes set widths.

- 2026-11-12 (early) — The user chose one main board with the block-by-block method and accepted 45-degree Y-branches (`dfm` reports them as advisory; 4 two-segment V turns still block). Printed-enclosure proposal modelled (`enclosure_printed.py`) with a preview image (`img/enclosure_printed_preview.jxl`) and sliced estimates; Dremel 3000 and accessories ingested into `lab/docs/inventory.md` (photo deleted as asked); the Dremel chop stand planned (waits on the nose-thread measurement).

- 2026-11-11 (21:45) — Assessment of the slow main board written (`kb/main_board_assessment.md`), plan in `TODO-agent.md`; the In2 route result recorded (SES written in about 45 min, import crashed on the mounting-hole footprint; board file unchanged).

- 2026-11-11 (evening) — Chat 13: K1 model (K1-FA35) recorded; enclosure posts split in the CAD into the L post and a separate `_bar` (flat, no supports) and re-sliced into per-window files (`kb/printing_state.md`); printed parts inventoried from the user's photo (nothing to reprint; photo stored as `img/printed_parts_2026-11-11.jxl`); calibration physics confirmed by the user (second 1 g weight preferred), `fixture_cal_rider` designed, tested and sliced, `procedures.md`/`plan.md`/`assembly.md`/`print_requirements.md` updated; bed-mesh convention checked against Klipper's source (front is the low end); library fixes (multi-line description that stopped `kicad-cli` loading `jlc.pretty`, models kept so `lib_footprint_mismatch` is gone, duplicated courtyard lines, USB-C pegs as non-plated holes), netlist paths made portable, DRC rules decided (min track 0.10 mm, pad-hole gap 0.45 mm), `mainboard.py` gained an In2 plane option, mounting holes, silk policy, netlist-parity and mounting-hole DFM checks, an acute-joint rewriter; two pre-existing smoke-test failures fixed (a last-sample glitch in the device-sink sim, a segfaulting `pcbnew.LoadBoard` in the panel check).

- 2026-11-09 (evening) — First print of the new set: `sensor_bracket`, `damper_holder`, `fixture_gap_gauge`, `fixture_saw_guide_base` on one plate (slice 1 h 14 min, 31.7 g; printed in 74 min). The OrcaSlicer MCP fork had to be reinstalled and its port-lock problem worked around; the K1 lost Wi-Fi twice (reconnected from its touchscreen). Findings are in the wsl KB notes.

- 2026-11-09 — Chat 10: JLC order states re-read through the app (arm In Production, elec_board and clamp_ground Shipped with tracking); the shipping-discount line explains the earlier cheap Global-line prices; AliExpress parcel received (thin nuts, calipers without a cell), ledger and inventory updated, AliExpress balance list plus button cells promoted to the user's list; board rules (layer count by need, 45-degree copper, DFM last) added to the layout pipeline as `geometry` and `dfm` commands.

- 2026-11-08 — Chat 8 close: the `clamp_plate` order (Y6) is in the JLC cart at C$3.10 goods, not paid, because the Global Standard Direct Line shipping now reads C$8.14. Coupons not applied (kept for the small-designs order). The Orca project from `balance.3mf` was scrambled by plate-moving calls and is not sliced; the file on disk is unchanged. Chat 9 starts from `docs/kb/session_handoff.md`, which holds the new context block.
- 2026-11-06 — Chat 8: `clamp_ground` JLC order placed, grand total C$5.08 (page price C$2.96). Balance materials checked by the user: no magnet pull on the sheet, pads or rod; rod 10 mm x 100 mm (printed calipers); the stainless sheet is a roll and sits loosely in `BALANCE MATERIALS`; nuts and screws are in `MISC TOOLS`. Slicer requirements for an outside model written (`docs/print_requirements.md`).

- 2026-11-05 — Chat 7: (1) the Claude co-author trailer was removed from every commit message in this repo and `lab` by a local history rewrite (backup bundles outside the repos; `refs/original` deleted; the hashes changed, so the remote needs the user's force-push). (2) The five AliExpress items of 2026-10-24 arrived: logged as received, new bag `BALANCE MATERIALS` (sheet flat in an envelope), checks listed as a user task (`lab/docs/orders.md`, `inventory.md`, `kb/inventory_storage_notes.md`). (3) `elec_board` JLC order placed by the user (5 boards): $2.10 USD + $1.50 USD shipping = $3.60 USD (C$5.10); `ORDER.md` has the status table and a currency note (order pages are USD, the card is CAD; the arm's "C$3.00" was probably USD). The save-to-cart spinner on the page needed no redo after the order went through. (4) JLCONE wrapper confirmed (`type jlcone` resolves to `~/.local/bin/jlcone`, the font is larger). (5) JLCMC checked inside the app: the "Mechatronic Parts" link opens outside, but loading `https://jlcmc.com/` into the account tab through the debug port works; the washers category (14 products) lists "Flat Washer Level A" (SUS304 among its materials, from about C$0.001 each), but each product page is a PDF catalogue (`/api/overseasFaPlatform/product/downloadPDF`) with no price table readable as text, and JLCMC orders can no longer be combined with JLCPCB/JLC3DP/JLCCNC (JLCMC notice of 2026-11-02), so a washer-only JLCMC parcel carries its own shipping: the washers stay on the AliExpress list and the JLCMC task was dropped.
- 2026-11-04 — JLC quote and coupon ingestion through the JLCONE app's debug port (read-only text reads, paced mouse clicks, nothing saved or submitted): the small-boards panel file quotes C$2.79 as a Single PCB (special offer) but C$19.25 as Panel by Customer with 3 designs (C$5.65 per extra design), so the three small boards go as separate single-board orders (`lab/docs/jlc/small_boards_panel_quote_2026-11-04.md`, `ORDER.md`); the account's 15 unused coupons with exact amounts and dates replaced the old ledger (`lab/docs/jlc/coupons.md`; the 30-day and 60-day ones are unclaimed offers, so no dates are missing); HDI and JLCCNC sheet-metal options recorded (`hdi_quote_ui.md`, `cnc_sheet_metal_quote_ui.md`; HDI is C$188.11 for the panel file at 1-step). A wrapper `~/.local/bin/jlcone` launches the app 13% larger (`--force-device-scale-factor=1.13`); the JLCMC washer check could not be done in the app.
- 2026-11-04 — JLC arm order total (user): HASL with lead, merchandise C$1.20 + shipping C$1.80 = C$3.00 after the coupon. The three small designs are now one customer panel (`boards.py` `panel_small()`, `fab/small_panel_gerbers.zip`, 36 x 96.5 mm, 4 boards on mouse-bite tabs, DRC: library-footprint warnings and open-outline items only) so one order and one coupon cover them; `ORDER.md` has the field settings.
- 2026-11-04 — JLCPCB arm order placed (5 FR4 boards, 1.2 mm; `hardware/balance/boards/fab/arm_gerbers.zip`) with the JLCONE $8 PCB coupon (the user reports it redeemed for C$11.17) and now in JLC's review. JLC asked whether the three copper areas on the arm are intended: two areas are bottom-only (strip contact pad 5.6 x 12 mm and the 20 x 8 mm electrode pad, joined by a 0.6 mm bottom trace), one has copper on both faces (the 8 x 7 mm flag pad at the arm end), all confirmed against `arm.kicad_pcb`. The order remark had mentioned ENIG pads although the plan is HASL; `ORDER.md` now carries a corrected remark.

- 2026-11-01 — EasyEDA/Spark route dropped, KiCad restored as the design source. What was built before the decision: the four mechanical boards and both sensor-head boards drawn natively in EasyEDA Pro (DRC clean); the 164-part main board schematic validated and a re-floorplanned layout (117.3 x 96.8 mm) with 0 DRC clearance errors but 62 open connections around the RP2040, which neither EasyEDA autorouter nor `tools/route_open_nets.py` could finish; a patch of the user's EasyEDA install (`tools/patch_easyeda_autoroute_jobs.py`, `--revert` restores the stock files), the offline validator `tools/validate_easyeda.py`, `tools/floorplan_main_board.py` and the router are kept as shelved tools. The KiCad/SKiDL netlists, Gerbers and panel files were never changed and remain the order files; WP5 (main-board layout in KiCad) still waits on A5. Notes: `docs/kb/easyeda_spark_notes.md` (archived).

- 2026-10-27 — WP9 and WP11: `docs/bringup.md` (power-up order for the electronics: rails, sensors and DAC, the ADC, each analog block with the load that cannot hurt, a sign-off table; what each `[FAIL]` means and where the unverified assumptions bite) and `docs/procedures.md` (A5 prototype check with the model's numbers beside each measurement: resonance 0.215 Hz, damping 0.40/0.86, 0.11 nN per 1000 s; the weights-and-plates calibration; the lead-current and heating campaign with controls and the analysis commands), and the paper skeleton `docs/paper/` (`main.tex` builds with latexmk; model numbers marked, every measurement a red `\todo`; `refs.bib` holds only the three references the repo records, with authors and titles to complete from the papers).

- 2026-10-27 — JLC account Parts I-N (coupons, parcels, materials, quote recipes, early heads order): `lab/docs/jlc/coupons.md` (the account's coupons with expiry dates, rules, planned use); `docs/fabrication.md` gained the order plan per checkout, a material and process table for the four mechanical parts (with the conductive-arm analysis and a decision rule), and a printed-parts shortlist for JLC3DP (`damper_holder` and `head` yes, `gantry` maybe); `tools/jlc_parcel_mass.py` (JLC's mass rule; mechanical boards 194 g, boards plus printed candidates combined 314 g so never combine across services); `hardware/balance/material_study.py` (the arm's first mode is 36 Hz with its loads, not the 64 Hz of the unloaded estimate; 1.6 mm gives 54 Hz; 0.8 mm aluminium matches FR4 1.2 mm), `arm_dxf.py` and `boards/fab/arm_cnc.dxf` for the sheet-metal quote and the 252 x 60 mm panel numbers; `ORDER.md` rewritten field by field against the PCB quote page; Standard PCBA's 70 x 70 mm and rail requirement folded into the WP5/WP7 plan; the sensor-head panel (`hardware/instrument/heads_panel/`: two head-1 and two head-2 boards on a 76 x 70 mm Standard-PCBA panel, routed with Freerouting, DRC clean apart from the intentional tab gaps, BOM and CPL, `ORDER.md`) with 8 new smoke checks overall. Waiting on the user: the quotes and decisions in `TODO-arcticoder.md`.

- 2026-10-26 — Twist test result: the N42 discs turn freely with no preferred angle, so they are magnetized through the flat faces. `MAGNET_MAGNETIZATION` set to "axial" in `hardware/balance/params.py`; `balance.py` regenerated the CAD (`damper_holder.stl` and the four magnet models now have flat round pockets); the field-modelled damping is 0.43 for one 0.3 mm pad and 0.86 for two (the budget assumes 0.40), no part overlaps, all smoke tests pass, the force-noise verdict is unchanged. The fab board files were regenerated but are unchanged in content (the Gerbers do not depend on the magnets). The old nut-check description (a nut goes to the centre of a flat face) was wrong and is corrected in `docs/history.md`.

- 2026-10-24 — WP8, the host side: `firmware/protocol.py` (sync + type + sequence + length + CRC-16 packets for ADC frames, lock-in outputs, environment readings and log text; MicroPython-compatible), `host/logger.py` (resynchronizing decoder to CSV, unwraps the 32-bit microsecond counter, converts codes to volts, reports bad CRCs, skipped bytes and sequence gaps; live from a serial port or from a recorded file), `host/analyze.py` (Welch ASD, Allan deviation, a noise report per channel) and `host/test_host.py` (16 checks in the smoke tests: round trips, 40 packets recovered through garbage, a damaged packet and a payload containing the sync pattern; ASD of white noise within 3% of sigma/sqrt(fs/2); a 1 kHz tone amplitude within 2%; Allan slopes -0.5 for white noise and +0.5 for a random walk).

- 2026-10-24 — WP8, the fixed-point lock-in (`firmware/lockin.py`, `test_lockin.py`; 13 checks in the smoke tests): demodulate with a +-1 square reference over exactly one 8-sample carrier period (1 kHz at 8 kSPS), then a leaky integrator at the period rate; integer arithmetic only; DC and ambient light cancel exactly, 50 Hz and 60 Hz interferers are rejected, the optical delay is found by `best_phase`, linear from 1000 to 1,000,000 counts (0.3% worst), and the 32-bit headroom is checked (24-bit input needs 2^32 of state, 16-bit input 2^24). The first version (a per-sample leaky integrator) failed its own tests: its state is a triangle wave inside each period, so a DC of D leaves -D / 2^(shift-1) at the period boundary; summing whole periods first removes it.

- 2026-10-24 — WP8, the sensor drivers and bring-up (`firmware/sensors.py`, `fake_sensors.py`, `test_sensors.py`, `bringup_sensors.py`; 19 checks): TMP117 (device ID, the data sheet's Table 7-1 codes), MMC5983MA (product ID, the data sheet's SET/RESET procedure with 18-bit counts, 16384 counts/G, null 131072; the test recovers field and bridge offset to one count and checks the write order SET, measure, RESET, measure), LIS2DW12 (register values from memory, flagged unverified). `bringup_sensors.py` scans the bus, powers the DAC to 0 V and checks plausibility of each reading; both bring-up scripts and all firmware tests run in the smoke tests.

- 2026-10-24 — WP8, the MCP4728 driver (`firmware/mcp4728.py`, `fake_mcp4728.py`, `test_mcp4728.py`; 18 checks in the smoke tests): the channel map A LED1 / B plate / C device current / D LED2; limits in code (LED 20 mA, plate 18.8 V, device current 300 mA; a request over a limit raises and writes nothing); only Multi-Write and Fast Write are implemented (the Single and Sequential Write commands also program the EEPROM, and the test proves none is sent); the LED channels use the internal 2.048 V reference, plate and device channels VDD. Found in the data sheet: the factory EEPROM state is 0 V on every channel, so power-up is safe even before the firmware runs.

- 2026-10-24 — WP8 first slice, the ADS131A04 driver (`hardware/instrument/firmware/`): `ads131a04.py` (MicroPython-compatible; 32-bit words, fixed six-word frame with CRC-16/CCITT, UNLOCK/configure/WAKEUP sequence for the schematic's strapping: charge pump and internal 2.442 V reference on, 16.384 MHz crystal to 8 kSPS), `fake_ads131a04.py` (a simulated device encoding the data-sheet protocol, with fault injection), `test_ads131a04.py` (13 checks, in the smoke tests; the CRC check uses the published CRC-16/CCITT-FALSE vector 0x29B1) and `bringup_adc.py` (the same script runs on the Pico and, against the fake, on the host). Writing the tests caught a sign bug in `code_to_volts`.

- 2026-10-24 — WP4d, boost ripple and the DAC ceiling: `sim/boost.spice` (behavioral MT3608: 1.2 MHz clock, 600 ns on-time, hysteretic comparator on FB, the board's real filter, capacitances derated for DC bias, the rail's load) gives the worst case of 0.40 V p-p at the boost output and 0.29 V p-p at the OPA197's supply, bursting at about 1 kHz (mean 24.05 V); through the OPA197 (PSRR assumed 80 dB, the data sheet's DC figure is far better) that is 0.76 pN of force at 18.8 V before the pendulum's filtering (a further factor of about 1e7 at 1 kHz): under the 1 pN check, so it does not enter `force_noise_budget.py`. The plate driver is linear to 0.0011% over the DAC's real 0.5-3.3 V range (full scale 18.8 V). Three new smoke checks (`analog_sims.boost()`, `plate()["gain_err_3v3_pct"]`).

- 2026-10-24 — WP4c, stand-in symbols checked against sources: TMP117 pins and address options (TI data sheet), VBPW34S (Vishay drawing: anode left, cathode right; our footprint is the gullwing land pattern within 0.15 mm of Vishay's, silkscreen agrees with symbol pin 1 = anode), SS14 (silkscreen cathode at pad 1), IR26-21C (pin 1 = cathode, a third-party record, consistent with the symbol). Not confirmable (manufacturer sites block downloads): KT-0603R polarity (footprint marks conflict; a reversed status LED only stays dark), USBLC6-2SC6 (standard ST pinout assumed), SM0xB tab pins, TS-1187A pairs (only the diagonal pins are wired), the ADC crystal's pinout; these are checks in WP7 (`TODO-BLOCKED.md`) against JLC's placement preview. Recorded in `kb/instrument_electronics_notes.md`.

- 2026-10-24 — TODO files restructured to the aqei-bridge pattern: `TODO-agent.md` holds open items only (WP4c, WP4d, WP8), with `TODO-BLOCKED.md` (A5, WP5-WP7), `TODO-backlog.md` (WP4e, WP9-WP11) and the old Part A planning text and finished Parts D, F, G, H archived in `kb/part_a_planning_archive.md`. WP4b (the ERC): `hardware/instrument/lib/set_pin_types.py` gives the generated symbols data-sheet pin types (132 IC pins; all other symbols passive); PWR_FLAGs on the supply nets; `schematic_test.py` now also runs electrical rules on the netlist (power inputs driven, inputs driven directly or through resistors, one driver per net, no unspecified pins, waivers listed with reasons). KiCad's `sch erc` on SKiDL's drawn sheets is not used as a gate (see the KB).

- 2026-10-24 — WP4, the schematic (as checked netlists): SKiDL descriptions of the main board and four head boards in `hardware/instrument/schematic/`, symbols and footprints for all 50 BOM parts in `hardware/instrument/lib/`; `schematic_test.py` (in the smoke tests) checks pin accounting, data-sheet nets, symbol pins against footprint pads, BOM equality with `parts.py` and design numbers. Reading the RP2040 hardware design guide and the ADS131A04 data sheet against the BOM changed it: the exact Raspberry Pi crystal (ABM8-272-T3), 2 A ferrite beads on the 5 V rail (the 600 ohm bead is rated 200 mA), 50 V capacitors on the 24 V boost; the extended-part budget went from 25 to 27. Open: WP4c-WP4d in TODO-agent.md.

- 2026-10-24 — Part H (H1–H4), live JLC lookups: `@jlcpcb/cli` 0.5.0 installed globally under nvm (chosen over the MCP server); `hardware/tools/jlc_query.py live()` and `parts.py --live` check the
  48-part BOM against JLC's live stock, library type and PCBA type (about 80 s, sequential because JLC answers 429 to bursts); it flagged two Standard-PCBA-only parts (H5 open); `jlc install` compared with
  `easyeda2kicad` on the ADS131A04: same pins and pads, so WP4 keeps `easyeda2kicad`. Notes in `kb/pcb_toolchain_notes.md`.
  H5: the two Standard-PCBA-only sensors are kept and the electronics order goes on Standard assembly (about $17 more setup, two-sided placement allowed); the MSKSEMI LIS2DW12 clone was rejected for lack of a datasheet and a spec mismatch; `parts.py --live` now reports 0 flagged.
- 2026-10-24 — Parts F and G: licenses (MIT + CERN-OHL-P v2) in both repos; the user's JLC-shipping chat ingested into `docs/kb/fab_ordering_notes.md` (checked against JLC's Combine Shipping page, capabilities page,
  OSH Park docs) and deleted; fabrication review in `docs/fabrication.md`: the arm, clamp plates and fixed electrode become FR4 boards for JLC (KiCad files, DRC clean, Gerbers and `ORDER.md` in
  `hardware/balance/boards/fab/`), a torsion head, FR4 device card with a 0.5 W cap, a clamping loop with no printed plastic, the centre of mass hanging 32 mm below the strip (31 mrad per mm), a field-modelled
  damper in two layouts, a gap gauge; plan, assembly steps and README rewritten; the five AliExpress items ordered 2026-10-24 recorded in `lab`; both knowledge bases updated with a handoff note.

- 2026-10-23 — Part D, balance materials review: enclosure redesigned for uncut 2 mm 150 × 250 mm acrylic (pinwheel walls, two-sheet lid,
  printed shelves, foam-tape-shimmed slots); damper rebuilt for radially magnetized discs on edge with a field model (magpylib, cross-checked
  to 0.01% against the analytic axial field), 20 × 20 mm vane of one or two 0.3 mm pads; saw guide for the ballast and strip-cutting guide;
  trim seats and `PRINTED_MASS_G` after finding that centre-of-mass offset tilts the arm 66 mrad per mm; foil path for the plate electrodes
  with a terminal on the fixed plate; `docs/assembly.md`. Smoke tests: 2 run, 0 failed; the force-noise verdict is unchanged (0.108 nN).
- 2026-10-23 — Split out of `lab` into this repo, with the experiment's history kept (G1–G3, WP1–WP3,
  the balance CAD and model, the instrument parts and simulations).
- 2026-11-10 — Chat 11: audit of the previous 10 commits written into `TODO-agent.md` (notes only); remaining balance plates sliced ahead and saved as G-code with headers checked (post, strip guide, three posts, gantry, base); print-session runbook written in the wsl repo and the Orca fork bundle copied to `~/tools/orcaslicer-mcp/`; user's cart reviewed (acrylic out pending an enclosure rework, calibration route without a mg weight set, washer thickness clarified); tracking numbers removed from my files; clamp_plate wording corrected (cancelled by the user over shipping; parcel-combining research open).

- 2026-11-10 — Chat 12: user feedback applied. The 2026-11-09 prints were inspected by the user (deburred, no damage), the thin M3 nuts are not magnetic, and the printer is off for tonight (gantry print moved to the morning of 2026-11-11). The AliExpress cart (washers, 0.1 g scale, 1 g weight) was reviewed against the listings and is correct; hacksaw blades stay in the order. Calibration route rewritten around PLA filament (about 30 mg per cm, mass per length measured on the 0.1 g scale) and the 1 g weight at small radii (`procedures.md` section B, `plan.md`); fine copper wire dropped from the plans. Order and batch numbers in `lab/docs/kb/jlc_account_and_quotes.md` masked.

- 2026-11-10 — Chat 12 (evening): the user placed the AliExpress balance order (7 items, cart C$14.19, free-shipping threshold cleared); logged in `lab/docs/orders.md`. Layout tooling hardened in `mainboard.py`: `drc()` removes the old report and exits 2 if `kicad-cli` writes none (no stale reads); `dfm()` now blocks on every severity `error`; `geometry()` takes a board path and `test_mainboard_geometry.py` checks the checker (clean, off-45, acute pass; the mid-segment tee is a known blind spot). The 415 versus 111 net counts: 111 nets in the DSN, 415 is Freerouting's own count of unrouted connections at the start (`fr.log`), so "9 of 415 unrouted" means connections. Scratch files `d0.json`, `t.kicad_pcb`, `t.rpt` deleted (unreferenced); `.gitignore` gained `/result.json` and the regenerated `out/` files (drc.json, ses, dsn, logs).

- 2026-11-10 — Chat 12 (late): the three AliExpress listing links (cells, JST-SH cable, hacksaw blades) recorded in `lab/docs/orders.md`. Generated layout outputs (`result.json`, `layout/out/drc.json`, `.dsn`, `.ses`, `fr.log`, `route.log`) removed from the git index with `git rm --cached` (staged, not committed; files kept on disk). Audit items done: absolute `/home/echo_/` paths replaced by `${KIPRJMOD}/../../lib/...` in the lib tables, 33 footprint files and the heads-panel board, and `schematic/generate.py` now writes the relative form; `mainboard.py` writes a project `fp-lib-table`, which cut `lib_footprint_issues` from 164 to 1 and exposed 64 `lib_footprint_mismatch` warnings; the whitespace-only line in `drc()` no longer exists.

- 2026-11-10 — Chat 12 (late): `geometry()` in `mainboard.py` now finds a segment end that tees into the middle of another same-net segment at an acute angle; `test_mainboard_geometry.py` covers it (passes). Run on the first routed board: no tees; the 7 acute joints are all Y-branches, no hairpins; off-grid deviation 0.106 degrees at most.

- 2026-11-10 — Chat 12 (late): TODO-agent.md cut from 91 to under 50 lines. Closed after checking: `-mp` is still listed by Freerouting 2.5.0 `--help` and `route(minutes)` is a parameter; the washers in `assembly.md` assume no thickness (20 washers, 7 mm OD fits under M3 heads); the a586e6a wording change touched only TODO files; `kb/README.md` lists every kb file and `lab/docs/kb/README.md` lists `jlc_account_and_quotes.md`; `TODO-BLOCKED.md` `clamp_plate` carries one revisit condition (coupon or rate back near US$1.50); `TODO-arcticoder.md` dates are current. Moved out of the list into kb: layout direction and board rules, printing state, staged orders, standing rules.

- 2026-11-10 — Chat 12 (late): `mainboard.py dfm` decisions made: malformed courtyards are advisory (library drawing issue), overlapping courtyards block, silk over copper stays advisory (the fab clips silk from pads), a missing In1/In2 zone blocks, missing assembly fiducials are advisory. Tested whether keeping footprint `models`/`description` in `place()` clears the 64 library mismatches: it does not, and keeping the description makes the board unloadable, so both stay cleared; the routed board was restored byte-for-byte from a backup (DRC counts unchanged).

- 2026-11-10 — Chat 12 (late): In1 ground plane implemented in `mainboard.py` (GND zone on In1.Cu, other nets kept off In1 with `use_layer`; a DSN power-plane definition was tried first and failed) and the board re-placed and re-routed at 120 x 90 mm: unconnected 9 -> 3 (a 100 x 80 mm board with the plane left 156), In1 holds only GND. `route` takes a minutes argument (needed 15-25 min). Calibration physics: weights cannot twist a vertical-axis torsion balance, so `procedures.md` B.1 and `plan.md` now use the added-inertia (period) method; the user is asked to confirm.

- 2026-11-11 — Printing session: filament loaded, the gantry (`balance_p3_gantry`, 70 g, 201.6 min) printed and inspected by the user (good); post nn started 10:46. Wi-Fi dropped repeatedly 7:19-7:50 with the print unaffected. Moonraker print hours 6.21 h.

- 2026-11-11 — Post nn (71.3 min) and the strip guide (34.4 min) printed and inspected; fast-start sequence (single G28 + `PRINT_PREPARED`) recorded in `kb/printing_state.md`. Moonraker print hours 7.97 h.
