arcticoder/spurious-force-balance/docs/TODO-agent.md

# TODO — agent (Claude-facing)

> Finished: `TODO-completed.md`. Waiting on something outside my control: `TODO-BLOCKED.md`. Later work: `TODO-backlog.md`. The user's list: `TODO-arcticoder.md`. Open items only.

- [ ] Main board: read the block-placement route (`mainboard.py route 12`, started 22:10 on 2026-11-11, log `layout/out/route_blocks.log`): record unrouted count, DRC, `geometry`, `dfm` in `kb/main_board_layout_notes.md`; fix what the numbers show (USB-C via short, courtyards, clearance), re-route in short runs; then the WP6 render review. Steps A (pcbnew), B (SPEC.md), C (block placement, floorplan image `img/main_board_floorplan.jxl`), D (net classes) and E (In2 pour with signals) are done.
