arcticoder/spurious-force-balance/(list of files, drawings)

Other design files:
hardware/easyeda/main_board_devices.json
hardware/instrument/layout/out/main_board.dsn
