arcticoder/spurious-force-balance/hardware/instrument/layout/out/main_board_filled.kicad_pcb

## KiCad design hardware/instrument/layout/out/main_board_filled.kicad_pcb (2026-11-12)

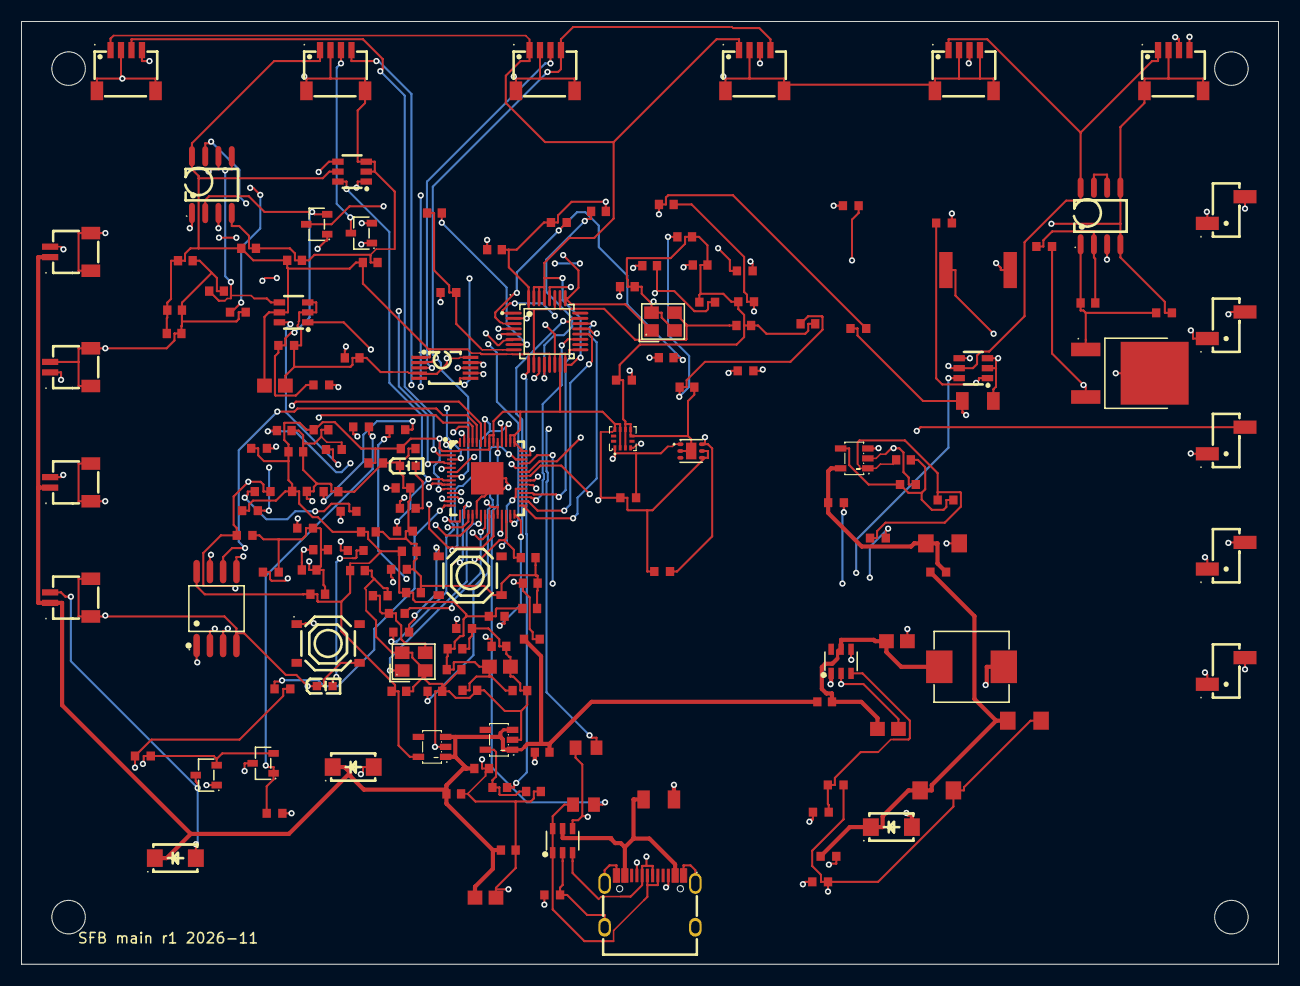
[picture p35: board main_board_filled.kicad_pcb from above]

Board: 4 copper layers, 120.0 x 90.0 mm, 168 parts (0 on the bottom side), 111 nets.

Parts:
C1, C5, C8, C51, C52: CL21A106KAYNNNE; C0805
C2, C9, C10, C11, C12, C13, C14, C15, C18, C19, C22, C23, C24, C25, C26, C28, C30, C31, C32, C33, C38, C46, C47, C57, C58, C59, C60: CC0603KRX7R9BB104; C0603
C3, C4, C6, C7, C16, C17, C27, C29, C34, C35, C36, C37, C39: CL10A105KB8NNNC; C0603
C20, C21: CL10C150JB8NNNC; C0603
C40, C41: CL10C220JB8NNNC; C0603
C42, C43, C44, C45: CL10B102KB8NNNC; C0603
C48, C49, C56: CL10C100JB8NNNC; C0603
C50: 0603B103K500NT; C0603
C53, C54, C55: CC1206KKX7R9BB475; C1206
CN1, CN2, CN3, CN8, CN9, CN10: SM04B-SRSS-TB; CONN-SMD_4P-P1.00_SM04B-SRSS-TB-LF-SN
CN4, CN5, CN6, CN7: SM02B-SRSS-TB; CONN-SMD_2P-P1.00_SM02B-SRSS-TB-LF-SN
D1: USBLC6-2SC6; SOT-23-6_L2.9-W1.6-P0.95-LS2.8-BL
D2, D3, D4: SS14; SMA_L4.2-W2.6-LS5.0-RD_1
F1: SMD1206P075TF; F1206
H1, H2, H3, H4, H5: HX PZ2.54-1X2P TP-YQ; HDR-SMD_HX-PZ2.54-1X2P-TP-YQ
L1, L2: GZ1608D601TF; L0603
L3: BLM18PG121SN1D_C14709; L0603
L4: SMMS0630-220M; IND-SMD_L7.3-W6.6_MHCI06030
LED1, LED2: KT-0603R; LED-SMD_L1.6-W0.8-R-RD
MH1, MH2, MH3, MH4: M3 hole; MountingHole_M3
Q1, Q2, Q4, Q5: AO3400A; SOT-23-3_L2.9-W1.3-P1.90-LS2.4-BR
Q3: AOD4184A; TO-252-2_L6.6-W6.1-P4.57-LS9.9-TL-CW
R1, R2, R36: 0603WAF5101T5E; R0603
R3, R4: 0805W8F270JT5E; R0805
R5, R6, R7, R8, R14, R15, R16, R17, R18, R19, R20, R21, R28, R29, R46, R49, R50, R52: 0603WAF1001T5E; R0603
R9, R10: 0603WAF2201T5E; R0603
R11, R13, R27, R39, R43, R45, R47, R48: 0603WAF1002T5E; R0603
R12, R22, R24, R26, R30, R33, R34, R35, R42, R44, R51, R53: 0603WAF1003T5E; R0603
R23, R25, R37, R40, R41: 0603WAF510JT5E; R0603
R31: 1206W4F100KT5E; R1206
R32: 25121WJ047JT4E; R2512
R38: 0603WAF4702T5E; R0603
SW1, SW2: TS-1187A-B-A-B; SW-SMD_4P-L5.1-W5.1-P3.70-LS6.5-TL_H1.5
U1, U2: LP5907MFX-3.3/NOPB; SOT-23-5_L3.0-W1.7-P0.95-LS2.8-BR
U3: RP2040; LQFN-56_L7.0-W7.0-P0.4-EP
U4: ABM8-272-T3_C20625731; CRYSTAL-SMD_4P-L3.2-W2.5-BL
U5: W25Q16JVSSIQTR; SOIC-8_L5.3-W5.3-P1.27-LS8.0-BL
U6: TMP117AIDRVR; WSON-6_L2.0-W2.0-P0.65-TL-EP
U7: LIS2DW12TR; LGA-12_L2.0-W2.0-P0.50-BL
U8: MCP4728-E/UN; MSOP-10_L3.0-W3.0-P0.50-LS5.0-TL
U9: ADS131A04IPBSR; TQFP-32_L5.0-W5.0-P0.50-LS7.0-TL
U10, U11: TLV9062IDR; SOIC-8_L5.0-W4.0-P1.27-LS6.0-BL
U12, U13, U14: SN74LVC1G3157DBVR; SOT-23-6_L2.9-W1.6-P0.95-LS2.8-BR
U15: MT3608; SOT-23-6_L2.9-W1.6-P0.95-LS2.8-BL
U16: OPA197IDBVR; SOT-23-5_L3.0-W1.7-P0.95-LS2.8-BR
USBC1: TYPE-C-31-M-12; USB-C_SMD-TYPE-C-31-M-12_1
X1: X322512MSB4SI; CRYSTAL-SMD_4P-L3.2-W2.5-BL

Connections:
3V3_A: C8.1, C27.1, C28.1, C29.1, C30.1, C46.1, C47.1, CN8.1, CN9.1, CN10.1, L2.2, U8.1, U9.9, U10.8, U11.8, U12.5, U13.5, U14.5
3V3_AR: C7.1, L2.1, U2.5
3V3_D: C4.1, C5.1, C9.1, C10.1, C11.1, C12.1, C13.1, C14.1, C15.1, C16.1, C22.1, C24.1, C25.1, C26.1, C36.1, C37.1, C38.1, CN1.1, CN2.1, CN3.1, R9.1, R10.1, R11.1, R12.1, R13.1, U1.5, U3.1, U3.10, U3.22, U3.33, U3.42, U3.43, U3.44, U3.48, U3.49, U5.8, U6.4, U6.5, U7.2, U7.9, U7.10, U9.15, U9.16, U9.29, U9.30, U9.31
ADC_CAP: C39.1, U9.28
ADC_CS: R13.2, U3.28, U9.23
ADC_DRDY: U3.31, U9.19
ADC_IN1N: C42.2, R15.2, U9.1
ADC_IN1P: C42.1, R14.2, U9.2
ADC_IN2N: C43.2, R17.2, U9.3
ADC_IN2P: C43.1, R16.2, U9.4
ADC_IN3N: C44.2, R19.2, U9.5
ADC_IN3P: C44.1, R18.2, U9.6
ADC_IN4N: C45.2, R21.2, U9.7
ADC_IN4P: C45.1, R20.2, U9.8
ADC_MISO: R12.2, U3.27, U9.21
ADC_MOSI: U3.30, U9.20
ADC_REFEXT: C35.1, U9.14
ADC_REFP: C34.1, U9.12
ADC_RESET: R11.2, U3.32, U9.17
ADC_SCK: U3.29, U9.22
ADC_VNCP: C31.1, C32.1, C33.1, U9.11
ADC_XTAL1: C40.1, U9.25, X1.1
ADC_XTAL2: C41.1, U9.26, X1.3
BOOST_EN: R33.1, U3.16, U15.4
BOOST_FB: R35.2, R36.1, U15.3
BOOST_FB_MID: R34.2, R35.1
BOOST_SW: D2.2, L4.2, U15.1
BOOTSEL_N: R6.2, SW1.1
CC1: R1.1, USBC1.A5
CC2: R2.1, USBC1.B5
DAC_DUT: R27.1, U8.8
DAC_LED1: U8.6, U12.1
DAC_LED2: U8.9, U13.1
DAC_PLATE: U8.7, U16.3
DEBUG_RX: CN1.4, U3.3
DEBUG_TX: CN1.3, U3.2
DUT_D: Q3.2, R32.1
DUT_DIV: R27.2, R28.1, U14.1
DUT_EN: R26.1, U3.15, U14.6
DUT_FB: C50.2, R29.1, U11.2
DUT_G: C50.1, Q3.1, R30.1, U11.1
DUT_RET: CN4.2, R32.2
DUT_SET: U11.3, U14.4
DVDD_1V1: C17.1, C18.1, C19.1, U3.23, U3.45, U3.50
GND: C1.2, C2.2, C3.2, C4.2, C5.2, C6.2, C7.2, C8.2, C9.2, C10.2, C11.2, C12.2, C13.2, C14.2, C15.2, C16.2, C17.2, C18.2, C19.2, C20.2, C21.2, C22.2, C23.2, C24.2, C25.2, C26.2, C27.2, C28.2, C29.2, C30.2, C31.2, C32.2, C33.2, C34.2, C35.2, C36.2, C37.2, C38.2, C39.2, C40.2, C41.2, C46.2, C47.2, C48.2, C49.2, C51.2, C52.2, C53.2, C54.2, C55.2, C57.2, C58.2, C59.2, C60.2, CN1.2, CN1.5, CN1.6, CN2.2, CN2.5, CN2.6, CN3.2, CN3.5, CN3.6, CN4.3, CN4.4, CN5.2, CN5.3, CN5.4, CN6.3, CN6.4, CN7.3, CN7.4, CN8.2, CN8.4, CN8.5, CN8.6, CN9.2, CN9.5, CN9.6, CN10.2, CN10.5, CN10.6, D1.2, LED1.2, LED2.2, Q4.2, Q5.2, R1.2, R2.2, R15.1, R17.1, R19.1, R21.1, R22.2, R23.2, R24.2, R25.2, R26.2, R28.2, R30.2, R31.2, R33.2, R36.2, R39.2, R43.2, R45.2, R48.2, R51.2, R53.2, SW1.4, SW2.4, U1.2, U2.2, U3.19, U3.57, U4.2, U4.4, U5.4, U6.2, U6.7, U7.3, U7.6, U7.7, U7.8, U8.4, U8.10, U9.10, U9.13, U9.27, U9.32, U10.4, U11.4, U11.5, U12.2, U12.3, U13.2, U13.3, U14.2, U14.3, U15.2, U16.2, USBC1.1, USBC1.2, USBC1.3, USBC1.4, USBC1.A1B12, USBC1.B1A12, X1.2, X1.4
I2C_SCL: CN2.4, CN3.4, R10.2, U3.7, U6.1, U7.1, U8.2
I2C_SDA: CN2.3, CN3.3, R9.2, U3.6, U6.6, U7.4, U8.3
LED1_G: Q1.1, U10.1
LED1_K: CN9.3, Q1.3
LED1_MOD: R22.1, U3.8, U12.6
LED1_REF: C48.1, U10.3, U12.4
LED1_SRC: Q1.2, R23.1, R49.1, U10.2
LED2_G: Q2.1, U10.7
LED2_K: CN10.3, Q2.3
LED2_MOD: R24.1, U3.9, U13.6
LED2_REF: C49.1, U10.5, U13.4
LED2_SRC: Q2.2, R25.1, U10.6
MON_5V: C59.1, R47.2, R48.1, U3.39
MON_24V: C58.1, R46.2, U3.38
MON_LED: C60.1, R49.2, U3.40
MON_SPARE: CN10.4, U3.41
MOTOR1_D: CN6.2, D3.2, Q4.3
MOTOR1_G: Q4.1, R50.2, R51.1
MOTOR1_PWM: R50.1, U3.13
MOTOR2_D: CN7.2, D4.2, Q5.3
MOTOR2_G: Q5.1, R52.2, R53.1
MOTOR2_PWM: R52.1, U3.14
PD_SIG: CN8.3, R14.1
PLATE_FB: C56.2, R38.2, R39.1, U16.4
PLATE_MON: C57.1, R20.1, R42.2, R43.1
PLATE_OP: C56.1, R38.1, R40.1, U16.1
PLATE_OUT: CN5.1, R41.2, R42.1
PLATE_SR: R40.2, R41.1
QSPI_SCLK: U3.52, U5.6
QSPI_SD0: U3.53, U5.5
QSPI_SD1: U3.55, U5.2
QSPI_SD2: U3.54, U5.3
QSPI_SD3: U3.51, U5.7
QSPI_SS: R6.1, U3.56, U5.1
RAIL_MON: R44.2, R45.1, R46.1
REF_SIG: CN9.4, R16.1
RUN: C23.1, SW2.1, U3.26
SHUNT: Q3.3, R18.1, R29.2, R31.1
SPARE_A: H1.1, U3.4
SPARE_B: H1.2, U3.5
SPARE_C: H2.1, U3.34
SPARE_D: H2.2, U3.35
SPARE_E: H3.1, U3.36
SPARE_F: H3.2, U3.37
SPARE_G: H4.1, U3.11
SPARE_H: H4.2, U3.12
SPARE_OP: U11.6, U11.7
STATUS_LED1: R7.1, U3.17
STATUS_LED1_A: LED1.1, R7.2
STATUS_LED2: R8.1, U3.18
STATUS_LED2_A: LED2.1, R8.2
SWCLK: H5.1, U3.24
SWD: H5.2, U3.25
USB_DM: R4.2, U3.46
USB_DM_C: D1.3, D1.4, R4.1, USBC1.A7, USBC1.B7
USB_DP: R3.2, U3.47
USB_DP_C: D1.1, D1.6, R3.1, USBC1.A6, USBC1.B6
V5: C1.1, C2.1, C3.1, C6.1, CN4.1, CN6.1, CN7.1, D3.1, D4.1, L1.2, L3.1, R47.1, U1.1, U1.3, U2.1, U2.3
V5_BOOST: C51.1, C52.1, L3.2, L4.1, U15.5
V24: C55.1, R37.2, R44.1, U16.5
V24_RAW: C53.1, C54.1, D2.1, R34.1, R37.1
VBUS: D1.5, F1.1, USBC1.A4B9, USBC1.B4A9
VBUS_F: F1.2, L1.1
XIN: C20.1, U3.20, U4.1
XOSC_OUT: C21.1, R5.1, U4.3
XOUT: R5.2, U3.21
