arcticoder/spurious-force-balance/hardware/instrument/schematic/out/led_head.kicad_sch

## KiCad design hardware/instrument/schematic/out/led_head.kicad_sch (2026-10-25)

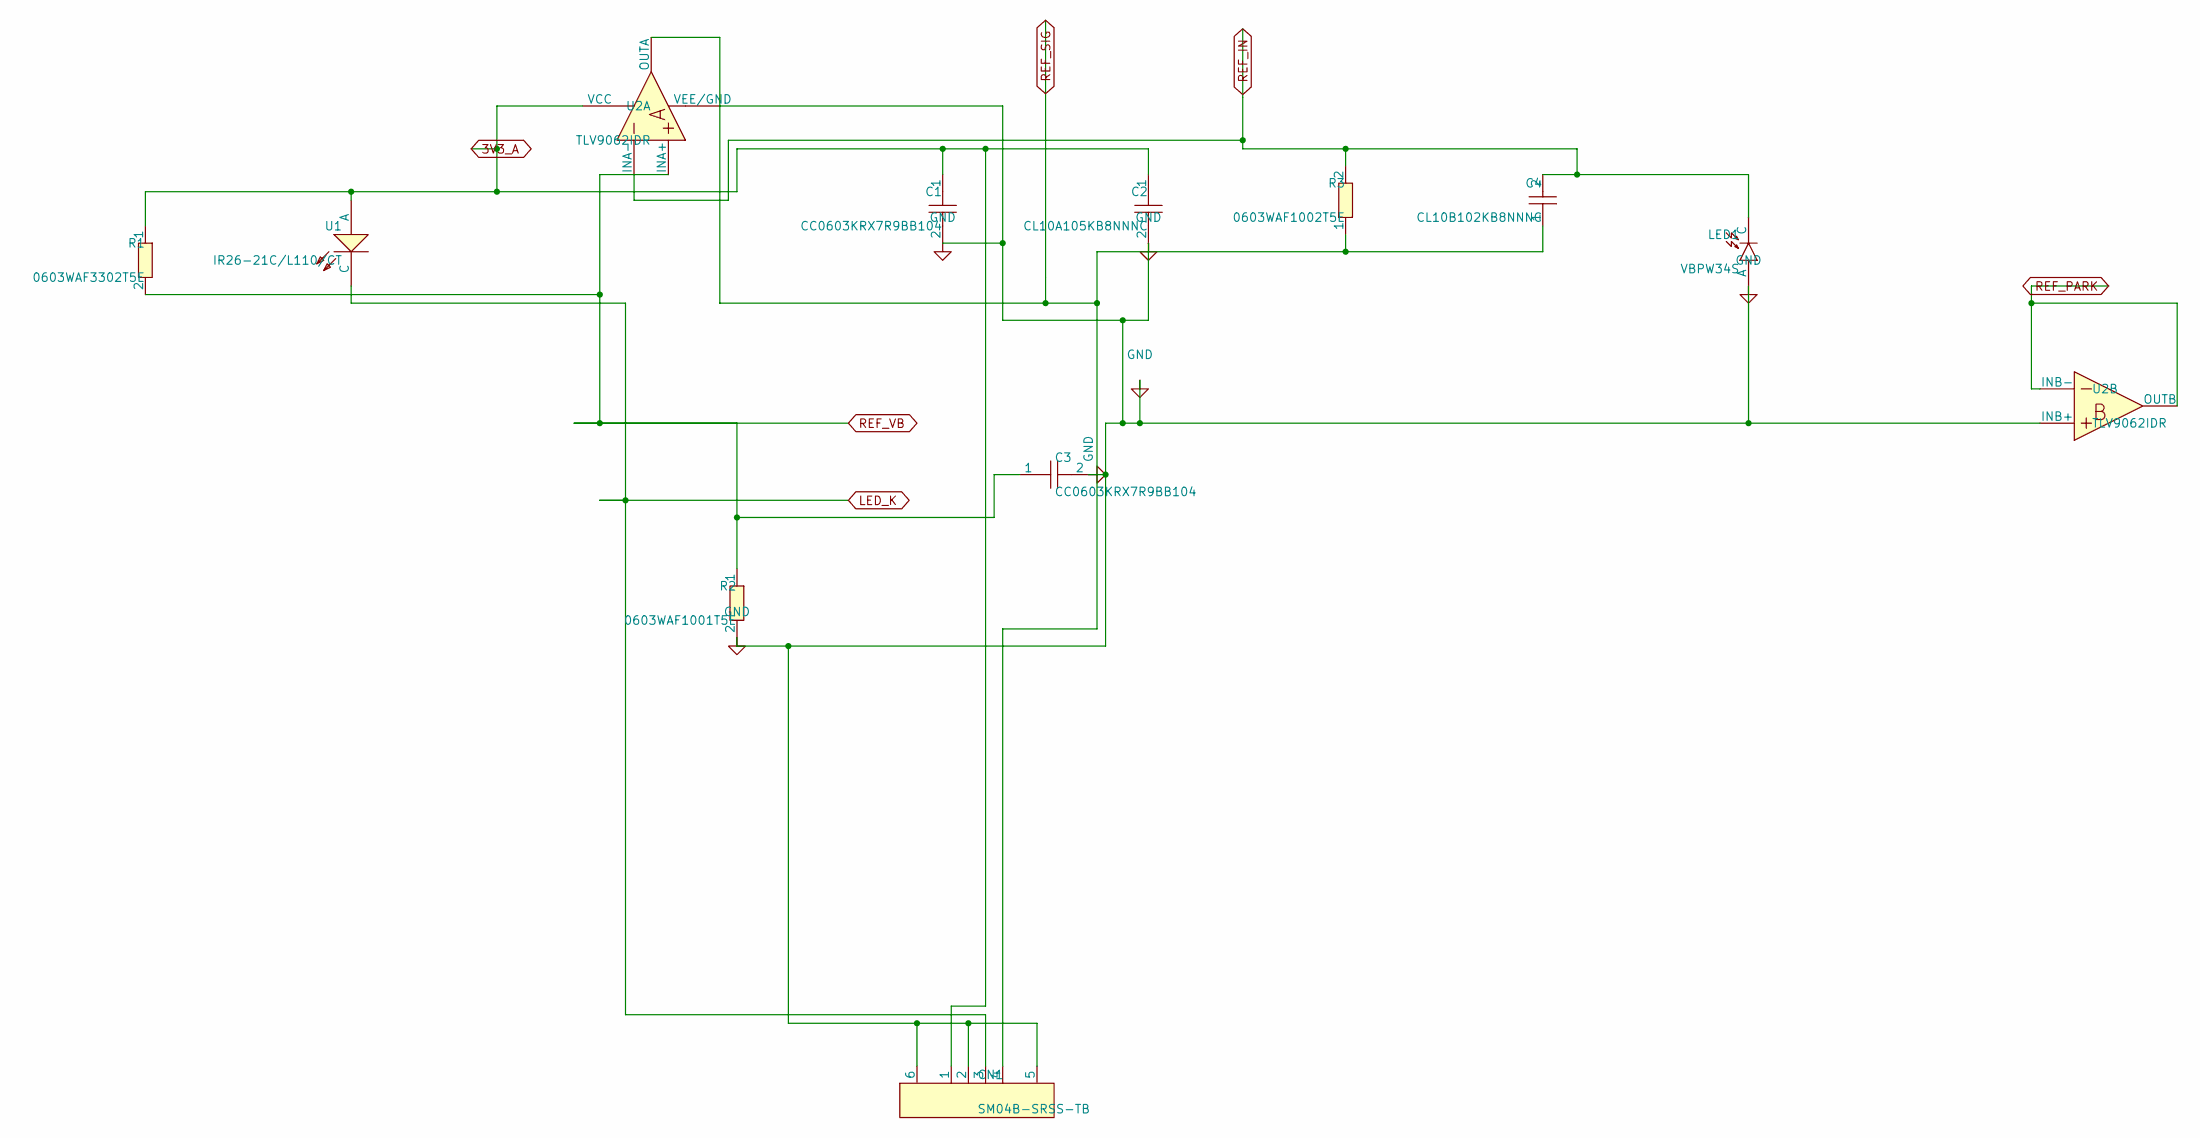
[picture p36: schematic led_head.kicad_sch]

Parts:
C1, C3: CC0603KRX7R9BB104; C0603; LCSC C14663
C2: CL10A105KB8NNNC; C0603; LCSC C15849
C4: CL10B102KB8NNNC; C0603; LCSC C1588
CN1: SM04B-SRSS-TB; CONN-SMD_4P-P1.00_SM04B-SRSS-TB-LF-SN; LCSC C160404
LED1: VBPW34S; SENSOR-SMD_L4.4-W3.9; LCSC C145262
R1: 0603WAF3302T5E; R0603; LCSC C4216
R2: 0603WAF1001T5E; R0603; LCSC C21190
R3: 0603WAF1002T5E; R0603; LCSC C25804
U1: IR26-21C/L110/CT; LED-SMD_L3.2-W1.6-RD_RED; LCSC C131280
U2: TLV9062IDR; SOIC-8_L5.0-W4.0-P1.27-LS6.0-BL; LCSC C398355

Connections:
3V3_A: C1.1, C2.1, CN1.1, R1.1, U1.2 (A), U2.8 (VCC)
GND: C1.2, C2.2, C3.2, CN1.2, CN1.5, CN1.6, LED1.1 (A), R2.2, U2.4 (VEE/GND), U2.5 (INB+)
LED_K: CN1.3, U1.1 (C)
REF_IN: C4.2, LED1.2 (C), R3.2, U2.2 (INA-)
REF_PARK: U2.6 (INB-), U2.7 (OUTB)
REF_SIG: C4.1, CN1.4, R3.1, U2.1 (OUTA)
REF_VB: C3.1, R1.2, R2.1, U2.3 (INA+)
