arcticoder/spurious-force-balance/hardware/balance/fixtures.py

"""
fixtures.py — printed jigs for cutting the balance's raw materials (no workshop tools needed beyond a hacksaw and a craft knife).

    ~/.venvs/lab-hw/bin/python hardware/balance/fixtures.py

  saw guide:   holds the 10 mm brass rod in a groove under a clamp plate (two M3 screws), with a stop so the hacksaw's kerf falls
               one ballast length (plus 0.5 mm to file off) from the rod's end.
  strip guide: a plate with a 0.8 mm knife slot exactly the strip width from a ridge the shim's straight edge butts against.
  gap gauge:   a 1.00 mm plate that sets the gap between the two calibration electrodes.
"""

import os

import cadquery as cq

import balance as B
import params as P

MM = 1e3
OUT = os.path.join(B.OUT)

ROD_D = 10.0  # mm, brass rod
KERF = 1.4  # mm, slot for a junior hacksaw blade (0.65 mm blade, set teeth)


def saw_guide(ballast_len):
    """Two printed pieces {name: solid}: the base block with a groove, and the clamp plate. x is along the rod."""
    cut_at = ballast_len + 0.5  # from the stop face to the kerf's near wall
    block_len = cut_at + KERF + 14.0  # stop + ballast piece + kerf + rod-side support
    base = B.box(0, block_len, 0, 30, 0, 18)
    base = base.cut(B.cyl_x(15, 18, -1, block_len + 1, ROD_D + 0.3))  # groove: the rod's axis in the block's top face
    # the stop: a wall closing the groove at x = 0 (the rod end butts against it)
    base = base.union(B.box(0, 3, 0, 30, 0, 18)).union(B.box(0, 3, 6, 24, 18, 24))
    stop = 3.0
    x_kerf = stop + cut_at
    base = base.cut(B.box(x_kerf, x_kerf + KERF, -1, 31, 4, 25))  # the saw slot, clear through the block above the floor
    for y in (4.5, 25.5):
        for x in (x_kerf + KERF + 5, stop + 4.0):  # two screws either side of the kerf
            base = base.cut(B.cyl_z(x, y, -1, 19, B.M3_PILOT))
    plate = B.box(stop, block_len, 0, 30, 18, 22).cut(B.box(x_kerf, x_kerf + KERF, -1, 31, 17, 23))
    plate = plate.cut(B.cyl_x(15, 18, -1, block_len + 1, ROD_D + 0.3))
    for y in (4.5, 25.5):
        for x in (x_kerf + KERF + 5, stop + 4.0):
            plate = plate.cut(B.cyl_z(x, y, 17, 23, B.M3_CLEAR))
    return {"fixture_saw_guide_base": base, "fixture_saw_guide_plate": plate}


BLADE_W = 6.0  # mm, the 2026-11-10 mini hacksaw blades (150 x 6 x 0.4 mm, 24T; hole positions not known: the handle clamps by friction and an end stop)
BLADE_T = 0.4
BLADE_GROOVE_W = BLADE_W + 0.3
BLADE_GROOVE_D = 0.30  # shallower than the blade is thick, so the cover crushes the blade by 0.1 mm on tightening
HANDLE_CLAMP_L = 62.0  # mm of blade held (the end stop is 5 mm short of the cover's end)
HANDLE_L, HANDLE_W, HANDLE_H, COVER_T = 130.0, 24.0, 22.0, 6.0
HANDLE_SCREWS = [(12.0, -8.0), (12.0, 8.0), (48.0, -8.0), (48.0, 8.0)]  # x along the handle, y across; outside the blade groove


def hacksaw_handle():
    """A pad-saw handle for the 150 x 6 x 0.4 mm blades: the blade's end lies in a shallow groove under a 6 mm cover held by four M3 x 14
    screws (self-tapped pilots in the body; same pattern as the saw guide). The blade's end butts against a stop, so the push stroke loads the stop,
    not the friction. The blade sticks out of the front (x = 0) by about 95 mm and runs in the saw guide's 1.4 mm kerf slot, which keeps it straight.
    Print the body as modelled (cover recess up) and the cover flat: no supports. Local frame: x along the blade, z up."""
    body = B.box(0, HANDLE_L, -HANDLE_W / 2, HANDLE_W / 2, 0, HANDLE_H)
    z_seat = HANDLE_H - COVER_T
    body = body.cut(B.box(-1, HANDLE_CLAMP_L, -HANDLE_W / 2 - 1, HANDLE_W / 2 + 1, z_seat, HANDLE_H + 1))  # recess the cover sits in
    stop_x = HANDLE_CLAMP_L - 5.0
    body = body.cut(B.box(-1, stop_x, -BLADE_GROOVE_W / 2, BLADE_GROOVE_W / 2, z_seat - BLADE_GROOVE_D, z_seat + 0.01))  # the blade groove, ends at the stop
    for x, y in HANDLE_SCREWS:
        body = body.cut(B.cyl_z(x, y, z_seat - 9.5, z_seat + 0.1, B.M3_PILOT))
    cover = B.box(0, HANDLE_CLAMP_L, -HANDLE_W / 2, HANDLE_W / 2, z_seat, HANDLE_H)
    for x, y in HANDLE_SCREWS:
        cover = cover.cut(B.cyl_z(x, y, z_seat - 1, HANDLE_H + 1, B.M3_CLEAR)).cut(B.cyl_z(x, y, HANDLE_H - 3.0, HANDLE_H + 1, B.M3_HEAD + 0.4))
    return {"fixture_hacksaw_handle_body": body, "fixture_hacksaw_handle_cover": cover}


def strip_guide(width_mm):
    """One plate lying on the shim: a ridge underneath for the shim's straight edge, a knife slot width_mm behind it."""
    fence = 2.0  # mm, ridge thickness
    slot_w = 0.8
    plate = B.box(0, 110, 0, 36, 0.5, 5.5)  # the plate's underside sits 0.5 mm above the board on the ridge
    ridge = B.box(0, 110, 0, fence, 0, 0.5)
    y_far = fence + width_mm  # the slot's far wall: the blade is pressed against it, so the cut falls exactly width_mm from the ridge
    plate = plate.cut(B.box(5, 105, y_far - slot_w, y_far, 0, 6))
    return {"fixture_strip_guide": plate.union(ridge)}, y_far


def gap_gauge():
    """A flat 1.00 mm (PLATE_GAP) gauge with a handle, to set the electrode gap between the arm board and the fixed electrode board."""
    return {"fixture_gap_gauge": B.box(0, 30, 0, P.PLATE_GAP * MM, 0, 20).union(B.box(10, 20, 0, P.PLATE_GAP * MM, 20, 45))}


CAL_WEIGHT_D = 10.0  # mm, the seat for the 1 g calibration weight [assume: check the weight when it arrives; filament pieces are bent into the same seat]
CAL_SLOT = 1.4  # mm, the saddle's slot for the 1.2 mm arm board (rib crush 0.25 mm on one wall brings the fit to about 1.15 mm)


def cal_rider():
    """The calibration rider (procedures.md B.1, added-inertia method): a saddle that clips over the arm board's top edge with a flat tray on top for the
    1 g weight or a bent filament piece. Printed in twos (one at +r, one at -r); a centre mark along y shows the radius to measure with calipers. Local frame:
    the board's top edge is z = 0, the board lies in y = 0 .. BOARD_T, x along the arm. Printed platform-down (slot opening up): no supports."""
    bt = P.BOARD_T * MM
    y0 = -(CAL_SLOT - bt) / 2  # slot centred on the board
    wall = 3.0
    body = B.box(-7, 7, y0 - wall, y0 + CAL_SLOT + wall, -8, 2.0)
    body = body.cut(B.box(-8, 8, y0, y0 + CAL_SLOT, -9, 0))  # the slot; its ceiling at z = 0 rests on the board's top edge
    body = body.union(B.box(-7, 7, y0 + 0.0, y0 + 0.25, -8, 0).translate((0, 0, 0)).intersect(B.box(-5.5, -4, -10, 10, -8, 0)))  # crush ribs on the y0 wall
    body = body.union(B.box(-7, 7, y0 + 0.0, y0 + 0.25, -8, 0).intersect(B.box(4, 5.5, -10, 10, -8, 0)))
    ymid = y0 + CAL_SLOT / 2
    plat = B.box(-8, 8, ymid - CAL_WEIGHT_D / 2 - 1.5, ymid + CAL_WEIGHT_D / 2 + 1.5, 2.0, 4.5)
    plat = plat.cut(B.cyl_z(0, ymid, 3.0, 5.0, CAL_WEIGHT_D + 0.4))  # the seat, 1.5 mm deep
    plat = plat.cut(B.box(-0.3, 0.3, ymid - CAL_WEIGHT_D / 2 - 2, ymid + CAL_WEIGHT_D / 2 + 2, 4.0, 5.0))  # centre mark: a 0.6 mm groove across the seat
    return {"fixture_cal_rider": body.union(plat)}


def build_all():
    bl, by = B.balance_solve()
    parts = {}
    parts.update(saw_guide(bl))
    parts.update(hacksaw_handle())
    parts.update(gap_gauge())
    parts.update(cal_rider())
    g, y_far = strip_guide(P.STRIP_WIDTH * MM)
    parts.update(g)
    return parts, bl, y_far


def main():
    parts, bl, y_far = build_all()
    os.makedirs(OUT, exist_ok=True)
    for n, solid in parts.items():
        bb = solid.val().BoundingBox()
        cq.exporters.export(solid, os.path.join(OUT, n + ".stl"))
        print(f"  {n:28s} {bb.xlen:.0f} x {bb.ylen:.0f} x {bb.zlen:.0f} mm")
    print(f"saw guide for a {bl:.1f} mm ballast; strip guide: slot wall {y_far - 2.0:.2f} mm from the ridge face")


if __name__ == "__main__":
    main()
