arcticoder/spurious-force-balance/(commit log)

2026-10-23 Add new simulation files and scripts for hardware instrumentation
    - Created `led_sink.spice` for IR LED current sink simulation.
    - Added `oa.inc` for behavioral op-amp models (TLV9062 and OPA197).
    - Introduced `plate_driver.spice` for electrostatic plate driver simulation.
    - Implemented `tia.spice` for transimpedance amplifier simulation.
    - Developed `smoke_test.py` to validate GPIO pin mapping and power budget.
    - Added `jlc_query.py` for querying JLCPCB parts library.
    - Updated `breadboard.md` with diagnostic procedures for lock-in amplifier.
    - Enhanced `diagnose_levels.py` for improved jumper row diagnostics.
    - Introduced `force_noise_budget.py` for end-to-end force-noise prediction in tor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
2026-10-23 Refactor CAD models and update parameters for balance hardware
    - Updated several STL files for the balance hardware, including new parts (enclosure components, gantry, and panels) and modifications to existing parts (ballast, base, damper holder, etc.).
    - Removed obsolete files (beam, upright_a, upright_b, y_counter).
    - Adjusted parameters in `params.py` for moving mass and inertia to reflect design changes.
    - Enhanced `eddy_damping_estimate` function in `model.py` to allow for optional parameters and updated calculations.
    - Modified `smoke_test.py` to include new checks for enclosure clearance, fastener inventory, and updated damping ratio estimates.
2026-10-24 Enclosure for uncut 2 mm acrylic, radially magnetized damper with a field model, cutting jigs, trim seats, plate foil path, assembly guide
2026-10-24 FR4 board redesign of the balance, torsion head, damper field model, fab decisions, licenses and knowledge base
    Arm, clamp plates and fixed electrode become JLC FR4 boards (KiCad, DRC-clean, Gerbers); device card capped at 0.5 W; MIT + CERN-OHL-P v2; fab ordering and workflow notes, handoff.
2026-10-25 feat: live JLC part check (jlc CLI), parts.py --live; flag two Standard-PCBA-only sensors
2026-10-25 feat: settle Standard-PCBA-only sensors (H5); electronics order on Standard assembly
2026-10-25 docs: electronics order is Standard PCBA
2026-10-25 feat: finalize Part H; update electronics order to Standard assembly and document changes
2026-10-25 Add sensor head schematic and associated tests
    - Created a new schematic file for the sensor head (sensor_head_2.net) including components such as capacitors, connectors, and temperature sensors.
    - Generated an ERC JSON file (sensor_head_2_kicad_erc.json) to capture electrical rule checks for the new schematic.
    - Added a symbol library table (sym-lib-table) to reference the JLC library for components used in the schematic.
    - Implemented a schematic test script (schematic_test.py) to validate pin connections, power requirements, footprint integrity, BOM consistency, and design limits against datasheet specifications.
    - Updated smoke test to include schematic validation, ensuring all checks pa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
2026-10-25 Update sensor head schematic and associated files
    - Modified sensor_head_2.net to update component details, including new PWR_FLAG components (#FLG1 and #FLG2) and adjusted pin types for better clarity.
    - Removed outdated sensor_head_2_kicad_erc.json file as it is no longer needed.
    - Enhanced schematic_test.py to include electrical rule checks (ERC) for improved validation of circuit design.
    - Introduced a new SPICE simulation file (boost.spice) for modeling the MT3608 boost converter behavior.
    - Updated smoke_test.py to include checks for the boost converter's performance and safety metrics.
2026-10-25 Add unit tests for firmware and host components, including lock-in, MCP4728, sensors, and logging
    - Implemented `test_lockin.py` for pass/fail checks of the fixed-point lock-in on synthetic photodiode streams.
    - Created `test_mcp4728.py` to validate the MCP4728 driver against a simulated chip, ensuring safety limits and EEPROM discipline.
    - Developed `test_sensors.py` for sensor driver checks against simulated chips, including TMP117 and MMC5983MA.
    - Added `analyze.py` for noise analysis of logged ADC data, calculating amplitude spectral density and Allan deviation.
    - Introduced `logger.py` for host-side logging of the instrument's USB stream, handling packet decoding and CSV writing.
    - Crea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
2026-10-27 Update CAD models and parameters for balance hardware
    - Updated STL files for damper holder, magnet low (0 and 1), and magnet up (0 and 1) to reflect design changes.
    - Modified MAGNET_MAGNETIZATION parameter in params.py to "axial" based on twist test results from 2026-10-26, indicating that the poles are on the flat faces of the discs.
2026-10-28 Add jlc_parcel_mass.py for estimating mass of JLC parcels
    This script calculates the estimated mass of planned JLC parcels based on the dimensions of mechanical boards and printed parts. It incorporates JLC's mass estimation rules and allows for combined shipping calculations. The script also includes handling for STL file volumes and material densities.
2026-10-28 Update ordering notes and coupon details for JLCPCB mechanical boards and sensor-head panel
2026-10-28 Refactor fabrication documentation and update arm order details
    - Revised the fabrication documentation to clarify the decision to keep the FR4 arm and the associated costs, including a detailed breakdown of the user's quote.
    - Updated the history log with the latest arm order details and decisions made on 2026-10-28.
    - Added a new labeled image of the apparatus to the documentation for better visualization.
    - Enhanced balance design notes with recent findings on arm stiffness and damper performance.
    - Adjusted the ordering notes to reflect the latest quotes and shipping details for the arm and small boards.
    - Improved session handoff documentation to include the latest user interactions and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
2026-10-30 Refactor TODO documentation for clarity; update Spark registration notes and MCP client wiring details
2026-10-30 Update TODO-agent and history documentation; add details on EasyEDA Pro arm board redesign and limitations
2026-10-30 Update TODO-agent and history documentation; add details on mechanical board designs and EasyEDA project status
2026-10-30 Update documentation for sensor head schematics; clarify PCB sync process and open issues
2026-10-30 Update TODO-arcticoder and history documentation; correct PCB import steps and clarify EasyEDA menu options
2026-10-30 Update documentation and project files; clarify EasyEDA Pro tasks and import status for sensor heads
2026-10-30 Update documentation for sensor head designs; clarify layout progress and server restart requirements
2026-10-30 Update documentation and parameters; clarify tasks for sensor head assembly and fastener orders
2026-10-31 Update documentation and .gitignore; add backup folder for EasyEDA Pro and clarify sensor head tasks
2026-10-31 Update TODO-arcticoder and history documentation; clarify tasks for sensor head 2 and copper rebuilding process
2026-10-31 Update documentation for sensor head designs; clarify tasks for EasyEDA panel and sensor head assembly
2026-10-31 Update history documentation; outline progress on sensor-head PCBs and clarify panel tasks
2026-10-31 Update documentation and notes; clarify EasyEDA panel status and silkscreen tasks for sensor-head PCBs
2026-10-31 Update documentation and project files; clarify main board wiring status, add device table for EasyEDA, and revise session handoff notes
2026-10-31 Update documentation and project files; finalize main board schematic, clarify import steps, and document wiring status for EasyEDA
2026-10-31 Refactor EasyEDA project validation and update documentation
    - Updated `TODO-arcticoder.md` to reflect the need for exporting the project for offline validation.
    - Revised `history.md` to clarify the current state of the main board and the requirements for validation.
    - Added `easyeda_validation.md` to document the offline validation process, including checks performed and export requirements.
    - Created `native_checks.json` to store EasyEDA's ERC/DRC results for each board.
    - Implemented `validate_easyeda.py` for offline validation of EasyEDA projects, including checks for naming, connectivity, pull-ups, floating inputs, BOM completeness, and SKiDL cross-checks.
    - Updated `session_handoff.md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
2026-10-31 Add netlist JSON files for sensor head components and enhance validation script
    - Created `sensor_head_1.json` and `sensor_head_2.json` containing component details and netlist information for the sensor head.
    - Updated `validate_easyeda.py` to support validation of live netlists from JSON files, allowing for easier integration without needing to export from EasyEDA.
    - Enhanced error checking in the validation script to include new conditions for crystal components.
2026-10-31 Fix PCB netlist issues: re-import schematic changes for TLV9062 components and update validation notes
2026-10-31 Update TODO-arcticoder and history notes: clarify schematic import issues with TLV9062 components and document fallback options
2026-11-01 Add deterministic floorplan generation for main board components
    - Introduced a new script `floorplan_main_board.py` to automate the placement of components on the main board using EasyEDA coordinates.
    - The script reads component data from `main_board_parts.json` and outputs the placement information to `main_board_placement.json`.
    - Implemented a greedy algorithm to optimize the placement of components based on signal net connections.
    - Added a new JSON file `main_board_placement.json` to store the final layout of components with their respective coordinates and rotations.
2026-11-01 Update TODO-arcticoder and history notes: clarify steps for autorouting and MCP server configuration, and document main board placement results
2026-11-01 Update TODO files and session handoff notes: refine tasks for EasyEDA autorouting, document GND pour status, and clarify next steps for main board routing and validation.
2026-11-01 Update TODO and history notes: clarify GND autoroute status, document Copper Manager rebuild results, and outline next steps for signal routing.
2026-11-01 Update TODO-arcticoder and history notes: clarify GND autoroute status, document router choice limitations, and outline next steps for signal routing and DRC checks.
2026-11-01 Update TODO-arcticoder and history notes: refine GND autoroute instructions, clarify timeout settings, and document findings on autorouter performance.
2026-11-02 Update main board placement and floorplan scaling
    - Adjusted component positions in main_board_placement.json for improved layout.
    - Introduced scaling factor in floorplan_main_board.py to allow dynamic resizing of the board layout based on environment variables.
    - Enhanced autoroute job patching script to support new API methods for creating multiple vias and lines efficiently.
2026-11-02 Update session handoff and EasyEDA notes: document GND stitching via creation, connection errors, and next steps for signal net routing.
2026-11-02 Refactor EasyEDA project tasks and add offline routing tool
    - Updated TODO-agent.md with detailed steps for EasyEDA Pro conversion and Spark submission, including routing tasks and validation processes.
    - Revised TODO-arcticoder.md to clarify user actions required for ordering PCBs and managing coupons.
    - Enhanced history.md to document recent changes in DRC token cost handling and routing status for main_board.
    - Expanded easyeda_spark_notes.md with insights on DRC results and routing lessons learned from recent sessions.
    - Modified session_handoff.md to include new routing strategy for U4 area and updated DRC check procedures.
    - Implemented patch_easyeda_autoroute_jobs.py to add new DRC ch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
2026-11-02 Drop EasyEDA/Spark route and restore KiCad as the design source; update related documentation and shelve EasyEDA tools.
2026-11-05 Update TODO lists and order remarks: clarify JLCPCB arm order details, adjust coupon timing, and log completed tasks.
2026-11-05 Add small panel PCB design and gerber files
    - Introduced a new KiCad PCB file for the small panel design, including detailed footprints and layout.
    - Added corresponding gerber files for manufacturing.
2026-11-05 Update ordering instructions for small panel PCB: clarify dimensions, delivery format, and pricing details
2026-11-05 Update ordering instructions and history for small boards: switch to separate single-board orders, clarify pricing details, and document coupon status.
2026-11-05 Update ordering instructions and history: clarify small board orders, confirm special offer pricing, and document JLCONE app usage.
2026-11-06 Update ordering documentation and history: revise JLCPCB order details, clarify pricing and shipping information, and log recent material arrivals.
2026-11-07 Update TODO documentation: add staged orders for `clamp_ground` and `clamp_plate`, clarify balance materials check, and revise JLCONE app instructions.
2026-11-07 Update TODO documentation: record `clamp_ground` order details, add `clamp_plate` order instructions, and clarify print requirements for balance parts.
2026-11-07 Update print requirements and history: clarify slicer settings for `balance.3mf`, document adjustments for optimal printing, and log changes made to the file.
2026-11-08 Update print settings and filament inventory: correct bed temperature for Hyper PLA, document filament stock details, and remove outdated photos.
2026-11-08 Update ordering and printing documentation: clarify `clamp_plate` order setup, revise printing instructions for balance frame, and document filament inventory details.
2026-11-08 Update clamp_plate order details: revise checkout instructions, clarify shipping estimates, and document coupon application.
2026-11-08 Update history documentation: add coupon details for `clamp_plate` order and document slicer adjustments for `balance.3mf`.
2026-11-08 Update checkout and slicer documentation: add shipping charge details, clarify checkout process, and document slicer rebuild status.
2026-11-08 Update documentation: clarify `clamp_plate` order details, revise printing instructions, and enhance session handoff context.
2026-11-08 Update documentation: revise `clamp_plate` shipping analysis, clarify checkout test, and correct order details for arm and clamp_plate.
2026-11-08 Update history documentation: add coupon and shipping analysis for `clamp_plate` orders, clarify current status, and document reasons for shipping cost increase.
2026-11-08 Update documentation: clarify status of `clamp_plate` orders, revise conditions for revisiting, and adjust printer setup instructions.
2026-11-08 Update documentation: remove shipping decision from list, clarify current tasks for printer setup, and confirm status of `clamp_plate` order.
2026-11-09 Update documentation: add printer status updates, filament loading instructions, and print plan details for K1 printer.
2026-11-09 Update documentation: record successful print of plate 1, detail parts printed, and provide next steps for user
2026-11-09 Update documentation and scripts: add print window details, update part weights, and include fastener images for assembly guidance
2026-11-09 Update documentation: revise measurement instructions for calipers and clarify Z-belt tooth skipping details.
2026-11-09 Update documentation: clarify that the main board and sensor heads replace breadboards for A5 prototype checks, and adjust related workflow details in TODO files.
2026-11-09 Add main board design settings and routing log
    - Created main_board.kicad_pro with design rules including minimum clearance, track width, via diameter, and hole specifications.
    - Added an empty route.log file for routing information.
2026-11-09 Add routing log for main board design process and note freerouting time limit
2026-11-09 Add freerouting log for main board and update history documentation
2026-11-10 Add network connection troubleshooting notes for K1 printer during print jobs
2026-11-10 Update TODO documentation with recent print results and tasks; refine order details
2026-11-10 Add audit section to TODO-agent.md summarizing last 10 commits; include repository hygiene, mainboard.py checks, documentation consistency, and bench/printer follow-ups
2026-11-10 Refactor TODO lists and session handoff documentation; update tracking number policies and shipping research tasks
    - Updated `TODO-agent.md` with new standing rules regarding tracking numbers and shipping research for JLC orders.
    - Revised `TODO-arcticoder.md` to reflect changes in the AliExpress order cart and clarified parts needed for upcoming orders.
    - Enhanced `TODO-completed.md` with a summary of recent tasks completed, including print-session runbook creation and G-code slicing.
    - Modified `history.md` to include detailed notes on recent actions taken regarding tracking numbers and order history.
    - Updated `session_handoff.md` to reflect the latest state of JLC orders, printing tasks,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
2026-11-11 Update documentation across multiple files: refine AliExpress order details, clarify calibration procedures, and document user feedback on printed parts
2026-11-11 Update order details in TODO documentation: include diamond needle files to meet free-shipping threshold and adjust cart total; clarify battery type for scale.
2026-11-11 Add unit tests for mainboard geometry validation
    This commit introduces a new test script `test_mainboard_geometry.py` that checks the functionality of the trace-shape checker. The tests include scenarios for a clean board, an off-45 segment, an acute joint, and a tee joint. The results are printed to the console, indicating the number of joints found and whether the geometry checks pass or fail.
2026-11-11 Remove obsolete log and result files from the project. The route.log and result.json files were deleted as they contained outdated information and were no longer necessary for the current workflow.
2026-11-11 Refactor 3D model paths in KiCad footprint files to use project-relative paths
    - Updated model paths in multiple footprint files to use the ${KIPRJMOD} variable for better portability.
    - Modified the generate.py script to write the correct paths for symbol and footprint libraries in the output tables.
    - Ensured consistency across all affected files to facilitate easier project management and sharing.
2026-11-11 Update TODO and session documentation with recent print session details and observations
2026-11-11 Update CAD files for balance hardware
    - Modified existing STL files: ballast.stl, encl_post_nn.stl, encl_post_np.stl, encl_post_pn.stl, encl_post_pp.stl.
    - Added new STL files: encl_post_nn_bar.stl, encl_post_np_bar.stl, encl_post_pn_bar.stl, encl_post_pp_bar.stl.
2026-11-12 Update TODO documentation and printing state with recent changes and completed tasks
2026-11-12 Refactor library paths in schematic output files to use KIPRJMOD variable
    - Updated library source paths in pd_head.net, sensor_head_1.net, and sensor_head_2.net to utilize the KIPRJMOD variable for better portability and maintainability.
2026-11-12 Update documentation and assessment for main board layout and performance
2026-11-12 Refactor main board layout and enclosure design
    - Updated TODO-agent.md with new assessment methods and user decisions regarding board layout and Y-branch acceptance.
    - Revised TODO-arcticoder.md to reflect changes in enclosure wall choices and Dremel tool measurements.
    - Documented completed tasks in TODO-completed.md, including user decisions on board design and enclosure printing.
    - Enhanced history.md with detailed notes on user decisions and design proposals.
    - Added enclosure_printed_preview.jxl image to visualize the proposed printed enclosure.
    - Updated balance design notes to include the printed enclosure proposal and material choices.
    - Adjusted main board assessment notes to refle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
2026-11-12 Add KiCad project and layout files for main board design
    - Created main_board_filled.kicad_prl for board layout settings and visibility configurations.
    - Added main_board_filled.kicad_pro for project settings, design rules, and net settings.
2026-11-13 Update printing schedule and prep details in documentation
2026-11-13 Update printing state documentation with recent print session details and error handling notes
2026-11-13 Refactor enclosure design and update related tasks
    - Updated the printed enclosure design to include 1.2 mm plates with a 2 mm rim and no acrylic window, as decided by the user on 2026-11-12.
    - Adjusted related tasks in TODO-BLOCKED.md, TODO-arcticoder.md, and TODO-backlog.md to reflect the new enclosure design and requirements.
    - Modified balance.py to ensure the panel cut list is empty when the enclosure is printed.
    - Enhanced smoke_test.py to validate the printed enclosure's dimensions and volume against the design specifications.
    - Updated parameters in params.py to indicate that the enclosure is printed and no acrylic will be purchased.
    - Revised enclosure_printed.py to reflect the new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
2026-11-13 Update TODO documentation with design details and safety gear requirements
2026-11-13 Update TODO and history documentation with recent print session details and inspection tasks
2026-11-13 Update documentation with ballast alternatives and printing session summaries
2026-11-13 Update TODO documentation with recent print session outcomes, safety gear requirements, and ballast decisions
2026-11-14 Update TODO documentation with safety glasses order, print windows, and slicing status
2026-11-14 Update TODO documentation with recent print session outcomes, slicing details, and user decisions
2026-11-14 Update TODO and history documentation with recent print session outcomes, including sliced files and user decisions
2026-11-14 Update TODO documentation with recent print session outcomes, including sliced files and user decisions
2026-11-14 Update TODO and history documentation with recent print session details, including print windows and spool status
